milindmadhukar/keygen/README.md

# Keygen

**A wireless split ergonomic keyboard with a custom two-layer PCB designed in KiCad 10.**






Keygen, both halves in their black PETG case, the per-key LEDs lit under smoke translucent keycaps

Keygen is a one-off build: 66 keys over two column-staggered halves, a 2 × 2 thumb cluster, a rotary
encoder and a 0.96-inch OLED on each half, and per-key RGB lighting. Each half has its own
nRF52840 controller hidden on the PCB underside, and an optional printed wedge tents it 13°. The keyboard reaches the host over Bluetooth or
USB-C, and the halves talk to each other over Bluetooth.

The schematic, placement and most of the routing are generated by the Python scripts in
[`tools/`](tools/), and so are the switch plate and the 3D-printed case.
[`tools/regen.py`](tools/regen.py) keeps every generated file current with its sources. The name and the
silkscreen artwork come from Martin Garrix's track *Keygen* (STMPD RCRDS); see
[Silkscreen artwork](notes/16%20-%20hardware%20reference.md#silkscreen-artwork).
[`tools/check_mechanical.py`](tools/check_mechanical.py) checks the plate, case and component
clearances, including the battery stack at full gasket travel.

**To build one, follow [INSTRUCTIONS.md](INSTRUCTIONS.md).**

## Specifications

| | |
|---|---|
| Layout | Column-staggered QWERTY, six columns per hand plus an extra bottom row |
| Keys | 66 (33 per half): 52 × 1u, 14 × 1.25u |
| Thumb cluster | 2 × 2 block rotated 30° (two 1u over two 1.25u) plus one 1.25u key per hand |
| Encoders | HongYan EC11H with a 20 mm D shaft on each half, fixed to the top frame and plugged into a pin header on the PCB, with a 17 mm aluminium D-shaft knob, in the key matrix. Left: scroll wheel, press for middle click. Right: volume, press to mute |
| Displays | 0.96 in. 128 × 64 SSD1306 OLED per half (I2C), held in the top frame and plugged into the PCB, showing ZMK's status screen |
| Switches | Akko V3 Lavender Purple Pro (tactile, 5-pin) in Kailh hotswap sockets (CPG151101S11) |
| Keycaps | Blank DSA PBT, smoke translucent |
| Lighting | 33 SK6812MINI-E reverse-mount RGB backlights per half, on a 5 V rail from a TPS61023 boost that the firmware switches off with the lighting. An SN74LV1T125 buffer drives their data at 5 V. ZMK's addressable RGB driver; on battery the lighting is optional (a System-layer key), dimmer, and off on a low cell |
| Controller | nRF52840 SuperMini (nice!nano v2 clone, Pro Micro format), one per half, socketed on the underside |
| Connectivity | Host: USB-C (left half) or Bluetooth, 5 profiles. Halves: Bluetooth split |
| Power | KP-355085 LiPo pouch per half (3.5 × 50 × 85 mm, listed 3000 mAh) with a protection board, JST-PH connector, slide switch driving a P-MOSFET battery switch. Each half charges from its own USB-C at about 300 mA |
| PCB | 2 layers, FR-4 1.6 mm, 1 oz copper, HASL, black soldermask with white silkscreen. One half is 160.2 × 126.0 mm |
| Switch plate | Clear polycarbonate 1.5 mm, CNC-routed, with eight gasket tabs per half |
| Case | 3D-printed PETG, gasket-mounted: a bottom shell and a top frame per half, 175.4 × 143.7 × 24.5 mm. The top frame covers the plate round the keycaps and the knob, and holds the OLED and the encoder. Rubber feet, and a steel disc set flush into each floor |
| Tenting | Optional 3D-printed 13° PETG wedge per half, held by four N35 10 × 3 mm magnets to the steel disc, with the feet standing in recesses in its top face |
| Foam | Poron ring switch pads (0.5 mm) on the PCB, EVA plate foam (2 mm) taped under the plate, EVA case foam (5 mm) on the case floor |
| Firmware | [ZMK](https://zmk.dev) `main` (Zephyr 4.1): QWERTY base with Nav, Fn and System layers, ZMK Studio |

## Gallery

The lit pictures are Cycles renders of the [Blender scene](notes/17%20-%20building%20from%20source.md#blender-scene),
which is rebuilt from the board and the case on request; the case layers and the PCB come from KiCad.

<details>
<summary>More renders and animations</summary>

**Both OLEDs booting.** A closeup of both screens playing the firmware boot sequence.

Both Keygen OLEDs playing the boot animation in a Blender closeup

**Per-key lighting.** The SK6812MINI-E LEDs shine up through the switches' clear tops and the smoke
translucent caps. The [logic audit](docs/logic-audit.md) records the current and voltage limits that
still need a powered prototype test before brightness or battery life can be promised.

A rainbow wave running across Keygen's per-key LEDs

**All round.**

Keygen turning on a turntable

**From above.** The top frame's deck round the keycaps, the OLED window and the knob.

Keygen from above

**From the side.** The back edge of each half, with its USB-C port and power switch.

Keygen from behind at desk level, showing the case profile, the USB-C ports and the power switches

**Underneath.** The bottom shells, with the counterbored case screws and the reset pinhole.

Keygen turned over, showing the underside of both bottom shells

**Tenting.** Each half on its wedge, and the wedges' top faces: four recesses for the rubber feet, and
four pockets for the magnets under the steel disc.

Both halves on their 13° wedges, from behind at desk level

The two wedges, with their foot recesses and magnet pockets

**Knob and thumb cluster.**

Close up on the left half's knob, OLED window and thumb cluster

**Status screen.** ZMK's status screen on the left OLED: Bluetooth profile, battery and layer. The
Keygen screens, with their boot animation and lighting menu, are in
[`firmware/README.md`](firmware/README.md#oled-screens).

Close up on the left half's OLED showing ZMK's status screen, beside the knob

**Case layers.** Bottom shell, case foam, standoff screws, PCB, switch pads, shims and standoffs,
plate foam, gasket strips under and over the plate tabs, plate and top frame.

Keygen case, exploded

**Bare PCB.** Black soldermask with white silkscreen artwork on both sides; see
[Silkscreen artwork](notes/16%20-%20hardware%20reference.md#silkscreen-artwork).

The bare Keygen PCB at an angle, black soldermask and white silkscreen

The bare Keygen PCB from above

The bare Keygen PCB from below

**PCB underside, assembled.** The controllers, power switches, battery connectors and reset buttons
sit on the back.

Keygen PCB underside with its parts

Renders of the case parts, the plate and the routing are in the [`media` release](https://github.com/milindmadhukar/keygen/releases/tag/media).

</details>

## Documentation

| Document | What it covers |
|---|---|
| [Build guide](INSTRUCTIONS.md) | Parts list, what to order and when, what goes on which side, one section per part with close-ups, flashing, closing the case, troubleshooting |
| [Hardware reference](notes/16%20-%20hardware%20reference.md) | Electronics, PCB rules, plate, case, foam and the silkscreen artwork |
| [Building from source](notes/17%20-%20building%20from%20source.md) | Requirements, the schematic and PCB pipeline, the plate and case, the [Blender scene](notes/17%20-%20building%20from%20source.md#blender-scene), every generated file |
| [Firmware](firmware/README.md) | ZMK configuration: keymap, OLED screens, hardware support, building and flashing |
| [Design notes](notes/index.md) | The Obsidian design notes: layout, controller, PCB, case, final design, datasheet audit |
| [Encoder mount](docs/encoder-mount.md) | The encoder boss, knob clearance, the plate and PCB openings, the cable and a printable test coupon |
| [Build plan](plan/index.html) | Layout drawing, connectivity, parts, pin budget and checklist. Open it in a browser |
| [Printed reference (PDF)](https://github.com/milindmadhukar/keygen/releases/download/build/keygen-reference.pdf) | A4, black and white: each half's key layout with every layer's legends, the case footprint and the back of the board at 1:1, the power parts and each part type close up, the keymap, the key matrix with the controller's pads, and the parts lists |
| [Schematic (PDF)](https://github.com/milindmadhukar/keygen/releases/download/build/keygen-schematic.pdf) | A top sheet with left (refs 1xx) and right (refs 2xx) sub-sheets |
| [KiCad project](pcb/keygen.kicad_pro) | Schematic and PCB, KiCad 10. Both halves are in one board file as two separate outlines |
| [Build files](https://github.com/milindmadhukar/keygen/releases/tag/build) | The PCB and plate Gerbers, case and wedge STLs and STEPs, foam cut files and plate print PDFs, as a release |
| [Ordering notes](fab/ORDER.md) | PCB order-form settings and what to check in the DFM report |
| [Plate ordering notes](case/plate/PLATE.md) | The DXFs for routing the switch plates from polycarbonate sheet, and the Gerbers for an FR-4 plate from a PCB fab |
| [Assembly BOM](fab/BOM.md) | Every part's references per half, with quantities and soldering notes |
| [Parts and sources](plan/bom.html) | Shopping list with Indian and import sources (from [`bom/bom.csv`](bom/bom.csv)) |
| [Shopping checklist](bom/CHECKLIST.md) | What to buy, from which store, with links and prices, to tick off |
| [Datasheets](docs/datasheets/README.md) | Every part's datasheet, with the page each design fact comes from |

## Firmware

Keygen runs [ZMK](https://zmk.dev), one build per half on the nice!nano v2 target, with the left half as
the central. The configuration builds; it has not yet run on the boards. GitHub Actions builds the
UF2s on every push that changes `firmware/`. The keymap, the build and the flashing steps are in
[`firmware/README.md`](firmware/README.md).

Keygen base layer

## Repository layout

```
keygen/
├── INSTRUCTIONS.md Build guide
├── pcb/            KiCad 10 project: schematic (generated), PCB, plate, project footprints and 3D models
├── tools/          Python scripts that generate, route, check and export the design
├── fab/            Assembly BOMs and ordering notes (the Gerbers are in the build release)
├── case/           Plate ordering notes (the case, wedge, plate and foam files are in the build release)
├── bom/            Bill of materials with sources (bom.csv) and the shopping checklist
├── plan/           Build plan and parts list as HTML
├── docs/           Datasheet index (the PDFs are in the datasheets release)
├── assets/         Keymap pictures and assembly figures (the renders are in the media release)
├── blender/        Blender studio scene with the materials and the lit LEDs; it links the generated parts
├── notes/          Design notes, hardware reference and build pipeline (Obsidian Markdown)
├── firmware/       ZMK configuration: shield, keymap, builds
└── lib/            Git submodules: marbastlib and Keebio-Parts footprint libraries, KeyV2 keycaps
```

## Project status

- [x] Layout and schematic, ERC clean
- [x] PCB placed, routed, DRC clean with schematic parity
- [x] Datasheet audit with no failures
- [x] Manufacturing files and assembly BOM
- [x] Parts sourced and priced
- [ ] Boards ordered and assembled
- [x] ZMK firmware builds
- [ ] ZMK firmware tested on the boards
- [x] Switch plate, gasket-mounted case and tenting wedges designed, fit-checked against the PCB
- [ ] Case and wedges printed

## Credits and licenses

- Footprints from [marbastlib](https://github.com/ebastler/marbastlib) (CERN-OHL-P v2) and
  [Keebio-Parts](https://github.com/keebio/Keebio-Parts.pretty) (MIT), included as git submodules.
- DSA keycap models generated with [KeyV2](https://github.com/rsheldiii/KeyV2) (GPL-3.0), a git submodule.
- MX switch 3D model from [kiswitch](https://github.com/kiswitch/kiswitch) (MIT / CC-BY-SA 4.0); see
  [`pcb/lib/keygen.3dshapes/NOTICE.md`](pcb/lib/keygen.3dshapes/NOTICE.md).
- Datasheets in the [`datasheets` release](https://github.com/milindmadhukar/keygen/releases/tag/datasheets) belong to their manufacturers.
