milindmadhukar/keygen/notes/14 - case & plate requirements.md

---
created: 2026-10-20
name: 14 - case & plate requirements
tags:
  - keyboards
  - case
updated: 2026-10-24
---
# Case & Plate Requirements

> [!info] Running checklist
> Every PCB or electronics decision that the **case**, **switch plate** or **faceplate** must account for goes here as soon as it's made. Read this before designing either. Decisions themselves live in [[12 - final design]]; the case as designed is in [[09 - case design]].
>
> The positions table at the bottom is generated by `tools/case_refs.py` in the repo. Re-run it after any PCB change.

## Openings in the case

All the ports are on the **top edge** of each half, next to the controller, so one cut-out area per half covers them. The left and right halves mirror each other.

| Opening | Where | Size / notes |
|---|---|---|
| **USB-C** | Top wall, at the controller | The controller (18 mm wide) hangs **under** the PCB on sockets, and its USB-C end reaches ~1 mm past the PCB edge; the edge is slanted, so one corner reaches ~1.6 mm. The controller's end sits in a **20 mm pocket inside the wall**, open at the top of the bottom shell so the stack drops in straight, behind 1.5 mm of wall. Through that wall, a **14.2 × 9.8 mm port** with 2 mm corners is centred on the mid-mount receptacle (5.4 mm under the PCB top with 3.0 mm sockets): it takes a 12.35 × 6.5 mm plug overmould, the largest the USB-C spec recommends, moved by the floating stack 0.5 mm sideways, 1.5 mm down and 1.0 mm up, with 0.4 mm to spare, so a plugged cable never touches the case. 3.1 mm of wall stays below it. |
| **Power switch** (SK12D07VG5, right-angle) | Top wall, near the USB-C | The 2 × 2 mm knob comes out of the body 2.55 mm under the PCB's underside (centre) and reaches 4 mm past the PCB edge, through a **9 × 5.3 mm slot**, 1.5 mm proud of the wall (1.0–2.0 mm as the stack floats). The bottom shell's slot is open up to the split, so the stack drops in with the knob through the wall, and a tongue on the top frame fills it above the knob, 0.4 mm clear at full float. Outside, the wall is thinned from 10 mm before the USB-C to the corner past the switch: to **1.5 mm** past the inner wall round the knob, and to 1.5 mm in front of the controller's pocket across the USB-C. |
| **Reset pinhole** | Case **floor**, under the reset button | The 6 × 6 mm, 5 mm-tall button sits on the PCB underside. You press it with a **paperclip** through a **Ø 2 mm hole**, countersunk outside, with a guide tube (Ø 5 mm) up to 1 mm under the button. ZMK can also enter the bootloader from a key combo. |
| **Rotary encoder knob** (both halves, mirrored) | Top: through the switch plate | The encoder is fixed to the top frame and the plate and PCB float round it. The selected HongYan EC11H body is 12 × 11.7 mm and up to 6.8 mm tall. The plate has an **18 × 18 mm cut-out** and the PCB an **18 × 20 mm opening**; the top frame has a Ø15 mm boss, 2.5 mm thick, with a 7.3 mm hole for the 7 mm bushing, and two 1.2 × 9 mm cheeks that keep the body from turning. The washer and M7 nut clamp it from above. The encoder's 20 mm shaft is measured from its 6.5 mm body, so its tip is 26.5 mm above the PCB; it is cut 1.0 mm short so the knob (11 mm deep inside, its hub 2 mm up inside it) sits 5.5 mm above the deck, with its hub on the shaft's D flat and 2.4 mm clear of the nut while pushed. The knob is Ø 17 mm, its edge 10 mm below the OLED, 5.7 mm from the thumb cluster's top key and 9.1 mm from the G/H column. Shafts at (167.0, 134.5) left and (256.5, 134.5) right, in board coordinates (KiCad mm). |
| **OLED window** (both halves) | Top: through the switch plate, above the knob | The 27.5 × 27.8 mm SSD1306 module (GME12864-11 drawing) is held in the top frame on **four Ø 1.7 mm pegs** through its corner holes, melted or glued over on its back, and plugs into a right-angle header in J101/J201 on a 4-wire jumper lead. Its glass sits in a pocket under a **1.0 mm lip**, 1.0 mm below the deck top, and its board 5.2–6.4 mm above the PCB on a boss that thickens the deck down to it, with 1.5 mm reliefs over its four joints and over the flex cable at its far edge. The lip's window is 1 mm round the active area at its underside, chamfered at 45° and opening towards the thumbs. The header and plug lie flat under the module, 2.8 mm tall. The plate has a **29.5 × 29.8 mm window** round the module, 1 mm per side, so the floating plate clears it by 0.5 mm. Module at x 154–181.5, y 88–116 (left) and x 242–269.5, y 88–116 (right), in board coordinates, over the controller's antenna end and 4.6 mm from the nearest keycaps. `tools/gen_case.py` checks the case against the modules. |

## Inside the case (under the PCB)

- **Tallest part: the controller on sockets.** The case reserves **9.4 mm below the PCB** for the socketed controller (the sockets, the male pins' carrier and the board, plus 2.9 mm for its parts, pin tails and spare), plus 1.5 mm of float travel to the floor. The PCB's 3D model uses 3.0 mm sockets (`SOCKET_H` in `tools/gen_schematic.py`) under the 1.6 mm SuperMini with its mid-mount USB-C, and the USB-C port is placed from them: set `SOCKET_H` to the measured socket body before printing the case; the controller envelope and the case depth follow it.
- **Battery**: a **KP-355085 LiPo pouch, 85 × 50 × 3.5 mm, listed 3000 mAh**, with a protection board. The bay takes a cell **≤ 5 mm thick and at most 60 × 88 mm** including the protection board. It lies in a **bay sunk 1.6 mm into the case floor**, long side across the board, under the outer and middle key columns, held with double-sided tape. Measure the actual cell before printing.
  - Bay: the cell plus 1.5 mm each side, 63 × 91 mm. Cell position (same coordinates as the table below): left half x 16.7–104.7, y 6.4–66.4; right half x 57.9–145.9, y 6.4–66.4. `tools/case_geometry.py` places it, as near the battery connector as the rules below allow.
  - Keep it **≥ 15 mm from the controller's antenna end** (no foil near the antenna) and ≥ 3 mm from the controller, the JST-PH connector, the slide switch, the reset button, the encoder and the OLED header pins. It has 10 mm.
  - The lead end faces the side-entry JST-PH next to the controller, about 40 mm away, so a lead of 80 mm or more reaches it.
  - Height: bay floor 12.5 mm below the PCB's underside. A 6.1 mm installed envelope (5.0 mm nominal cell + 0.3 mm thickness tolerance + 0.5 mm swelling + 0.3 mm tape) leaves 4.4 mm to the sockets and diodes (assumed 2.0 mm under the PCB), and 2.9 mm with the floating stack pressed 1.5 mm down. `tools/gen_case.py` checks the modeled envelope. Solder higher than 2.0 mm uses that gap.
- **Case height:** 3.0 mm floor + 1.5 mm float gap + 9.4 mm controller envelope + 1.6 mm PCB puts the PCB top 15.5 mm above the desk, the plate top 20.5 mm and keycap tops about 35 mm, before tenting and feet. The full stack is in [[09 - case design#The stack]].
- **Plate standoff screws** under the PCB (M2 button heads, 1.1 mm) are lower than the hotswap sockets.
- **Other underside parts.** Kailh hotswap sockets (~1.8 mm), through-hole diodes (~2 mm body, leads clipped flush), reverse-mount LEDs (nearly flush) and the switch pins poking through. Allow **≥ 4 mm** clear under the key area.
- **Bluetooth antenna.** The nRF52840's chip antenna is at the controller's **bottom end** (opposite USB-C). The case must be **plastic**, with **no metal plate, weight or screws** under or right next to that end. The PCB already keeps ground fill out of that area.

## Switch plate (faceplate)

- **Clear polycarbonate, 1.5 mm**, the thickness the MX clips are made for, CNC-routed from solid sheet with `case/plate/dxf/` (notes in `case/plate/PLATE.md`): each half needs a 178 × 139 mm piece, so a 6 × 24 in. (152 × 610 mm) strip holds three. Routed, not laser-cut: a laser browns and chars polycarbonate edges. `case/plate/gerber/` has the same plate as a 1.6 mm board with no copper for a PCB fab; the case takes either.
- **14.0 × 14.0 mm** square cut-out per switch, with 0.5 mm corner radii (in the DXFs, a dogbone at each corner for a 1/8 in. bit).
  - Thumb keys follow the PCB rotation (±15° / ±30°).
  - The two tall 1.25u thumb switches per half are turned 90°, but the cut-out is square so that doesn't matter.
- **No stabilizer cut-outs.** Nothing is wider than 1.25u.
- **Plate-to-PCB gap.** The plate top sits 5.0 mm above the PCB top (MX standard), so the gap is 3.5 mm. At all five holes per half an **M2 × 3 mm female-female standoff** stands on a **0.5 mm DIN 988 shim** (2 × 5 mm) on the PCB, screwed on from below with an M2 × 5 button head: 2.9 mm into the 3 mm standoff, its tip within ±0.25 mm of the standoff top and free in the plate's 2.2 mm hole if it pokes past.
- **Plate fixing.** Every standoff's top bears on the plate; the switches, clipped into the plate and plugged into the hotswap sockets, hold the plate to the PCB, and the case clamps the plate's tabs between the gasket strips.
- **Mounting holes** line up with the PCB's M2 holes (table below), 2.2 mm.
- **Gasket tabs:** 8 per half, 12 × 5 mm, on the plate edge, kept 22 mm from the USB-C and the power switch. The right half's are the left's, mirrored.
- **Encoder cut-out** (18 × 18 mm) and **OLED window** (29.5 × 29.8 mm) on both halves (see above).

## Lighting

- **Per-key LEDs** sit **south** of each switch (under the MX LED window), so shine-through legends would need south-facing keycaps.
- **Opaque floor.** All the lighting is per-key and shows through the keycaps, so the case floor needs no diffuser.

## Ergonomics and feel

- **Tenting.** An optional printed 13° wedge per half, its four magnets on a 40 mm steel disc set flush into a 1.0 mm pocket in the inner half of the floor, at least 15 mm from the controller's antenna end and clear of the battery bay.
- **Rubber feet** and **foam** (EVA case foam, Poron switch pads) for a thocky sound. See [[07 - switch & keycap selection]].
- **Keycaps.** Blank DSA PBT, smoke translucent: 52 × 1u, 14 × 1.25u. Switches: Akko V3 Lavender Purple Pro.

## Positions (from the PCB)

Measured from the top-left corner of each half's bounding box, looking at the switch side. The y axis points down, toward the thumbs.

<!-- case-refs:start -->
**Left half**: board outline 160.2 × 126.0 mm (bounding box)

| Ref | What | x | y |
|---|---|---|---|
| BT101 | Battery JST-PH connector (underside) | 143.6 | 28.2 |
| ENC101 | Rotary encoder shaft (top) | 136.7 | 58.9 |
| H101 | M2 mounting hole | 84.0 | 60.0 |
| H102 | M2 mounting hole | 4.5 | 85.5 |
| H103 | M2 mounting hole | 152.7 | 51.4 |
| H104 | M2 mounting hole | 136.1 | 121.3 |
| H105 | M2 mounting hole | 23.5 | 8.5 |
| J101 | OLED wiring pin 1 (top); the module is above it, in the top frame | 141.2 | 39.1 |
| J102 | Encoder lead header pin 1 (underside) | 155.9 | 79.4 |
| SW190 | Power slide switch (underside), knob through the top wall | 149.6 | 7.0 |
| SW191 | Reset button (underside) -> floor pinhole | 152.6 | 41.2 |
| U101 | Controller (underside), USB-C at the top edge | 129.1 | 20.8 |

**Right half**: board outline 160.2 × 126.0 mm (bounding box)

| Ref | What | x | y |
|---|---|---|---|
| BT201 | Battery JST-PH connector (underside) | 16.7 | 28.2 |
| ENC201 | Rotary encoder shaft (top) | 23.6 | 58.9 |
| H201 | M2 mounting hole | 82.1 | 57.5 |
| H202 | M2 mounting hole | 7.5 | 51.4 |
| H203 | M2 mounting hole | 34.4 | 115.4 |
| H204 | M2 mounting hole | 155.6 | 85.5 |
| H205 | M2 mounting hole | 138.1 | 9.0 |
| J201 | OLED wiring pin 1 (top); the module is above it, in the top frame | 26.6 | 39.1 |
| J202 | Encoder lead header pin 1 (underside) | 14.5 | 79.4 |
| SW290 | Power slide switch (underside), knob through the top wall | 10.7 | 7.0 |
| SW291 | Reset button (underside) -> floor pinhole | 14.2 | 41.2 |
| U201 | Controller (underside), USB-C at the top edge | 31.2 | 20.8 |

<!-- case-refs:end -->
