milindmadhukar/keygen/notes/15 - datasheet audit.md

---
created: 2026-10-20
name: 15 - datasheet audit
tags:
  - keyboards
  - pcb
updated: 2026-10-22T15:00
---
# Datasheet Audit

> [!note] Result (2026-10-28): connectivity passes, lighting limits remain
> `tools/check_datasheets.py` checks the routed PCB against component pinouts and electrical limits: **109 pass, 0 fail, 15 warnings**. It now verifies all 66 switch/LED openings and warns about the 40% full-white current and missing per-pixel bypass capacitors. This is not a brightness or battery-life sign-off. The full operating review is in [`docs/logic-audit.md`](../docs/logic-audit.md). Re-run the script after any PCB change, with `-v` to list passes. Datasheets and source pages are in `docs/datasheets/`.

## How the checking fits together

There are three checks, each covering a different gap:

1. `tools/check_schematic.py`: the schematic matches the design tables in `gen_schematic.py` (plus KiCad's electrical rules check).
2. `kicad-cli pcb drc --schematic-parity`: the PCB matches the schematic.
3. `tools/check_datasheets.py`: the design tables are **right for the parts**. Nothing else checked this.

The audit reads the `.kicad_pcb` file, the thing that gets fabricated. It checks **physical pad positions**, not just pin numbers, because footprint numbering can disagree with the datasheet.

To prove the test catches real mistakes, I fed it deliberately broken copies of the board, and it flagged every one. They included a mirrored controller pinout, a mirrored LED footprint, a reversed diode, LED data on a low-frequency pin, and the battery bypassing the switch.

## Learnings

### nRF52840 pins
- **No bootstrapping pins.** Unlike the ESP32, every nRF52840 GPIO resets to a disconnected input, and nothing on the GPIOs decides how the chip boots. P0.18 is reset; P0.00/P0.01 are the 32 kHz crystal; SWD has dedicated pins.
- **Bootloader:** the nice!nano's Adafruit bootloader 0.6.0 defines DFU = P0.18 (reset) and FRESET = P0.19 (not connected), and current master says "no buttons". **No edge pad is read at power-up**, so a held key can't push the board into DFU. Double-tapping RST within 500 ms enters the bootloader.
- **"Low frequency" pins (≤ 10 kHz)** come from the *Recommended usage* column of Table 142 in the nRF52840 spec (aQFN73 ball assignments, p. 578). The nRF52840 has no "GPIO near the radio" section; that is the nRF52832's document. The restricted pins on the edge pads are P0.02, P0.09, P0.10, P0.29, P0.31, P1.04, P1.06, P1.11, P1.13 and P1.15, plus the inner pads P1.01, P1.02 and P1.07. The nice!nano pinout image colours exactly these purple. Running faster signals on them can upset the radio.
  - LED data (SPI at 4 MHz) is on **P0.06**, unrestricted. **P0.08** drives the LED boost's enable (a slow output). The OLED's I2C is on **P0.17** (SDA) and **P0.20** (SCL), both full-speed pins.
  - The encoder's A and B lines (P0.10, P0.09) are slow inputs, so the low-frequency NFC pins suit them.
  - The matrix columns and ROW4 *are* on low-frequency pins. That's fine: ZMK scans about once per millisecond (~1 kHz).
- **NFC pins P0.09/P0.10** stay NFC antenna pads until UICR.NFCPINS is cleared. With ZMK's Zephyr 4.1, the old `CONFIG_NFCT_PINS_AS_GPIOS` is gone; use devicetree `&uicr { nfct-pins-as-gpios; };`. Once written, the setting sticks until UICR is erased. When driven to different levels, the two pins leak 1–10 µA between each other.
- **Absolute maximum on any I/O is VDD + 0.3 V.** Every signal on a pin comes from inside the half, at 3.3 V.

### nice!nano v2 pinout (the SuperMini)
- The nRF52840 SuperMini is a nice!nano v2 clone with the same 24-pin header, so the footprint follows the nice!nano v2. Pinout verified pad by pad against the official image. **Mounted on the underside, the component side (chip, USB-C) must face away from the PCB.** That's what the footprint assumes. Soldered the other way, the columns swap and battery + lands on a GPIO.
- P0.13 *low* cuts VCC on the v2. The "high" wording in the docs is for v1. VCC (pad 16) powers the OLED, so the firmware holds P0.13 high with a gpio-hog. Battery voltage is read internally (VDDH), so it uses no pin.
- The SuperMini charges through a TP4054 at about 100 mA as shipped; its BOOST link on the back, an unfitted 0 Ω link, raises that to about **300 mA**, and Keygen bridges it: about ten hours for an empty 3000 mAh cell. On USB a diode feeds the controller (VDDH) from USB and a P-MOSFET takes the battery off it, so ZMK reads the battery as full while plugged in ([vendor schematic](https://img.alicdn.com/imgextra/i1/3009214883/O1CN01dX5XEt1lwSylaBst7_!!3009214883.jpg)). It has no over-discharge cut-off, so the cell carries its own protection board. Check B+ (pad 13), GND and VCC (pad 16) on each board before soldering it, and the charge current after bridging BOOST. With no battery fitted, B+ is only the charger's output, so the LED boost has no proper supply.
- No VCC current limit is published, and no antenna position or keep-out. The renders show bare board at the end away from USB-C, so the audit keeps the last 6 mm clear.

### Parts
- **SK6812MINI-E:** the datasheet numbers the pins 1 VDD, 2 DOUT, 3 GND, 4 DIN. KiCad's symbol uses 1 VSS, 2 DIN, 3 VDD, 4 DOUT. They still line up physically: the reverse-mount footprint is the datasheet's lens-side view mirrored, which is correct because the lens faces the board. The chamfered corner is GND. When ordering assembly, check the fab's placement preview against that.
  - VDD is rated 3.7–5.5 V. The LEDs get 4.95 V from the TPS61023 boost over the cell's whole 3.0–4.2 V. VIH = 0.7 × VDD = 3.47 V, so the data comes from an SN74LV1T125 on the same rail, which drives the chain at the rail.
  - 12 mA per colour, so 33 LEDs at full white ≈ 1.2 A per half. Each LED also draws 1 mA even when dark (≈ 33 mA per half), so the boost turns off with the lighting.
  - The manufacturer's example has a capacitor at every pixel and a resistor on DIN: each LED has an optional 100 nF footprint beside it (left empty), and a 330 Ω resistor feeds the first LED.
- **TPS61023:** SOT-563, pins 1 FB, 2 EN, 3 VIN, 4 GND, 5 SW, 6 VOUT. VREF 595 mV (580–610), so 732 kΩ / 100 kΩ gives 4.95 V. EN high above 1.2 V, so P0.08's 3.3 V enables it; 0.1 µA shutdown with the output disconnected. Valley switch limit 2.7–3.7 A at 3.6 V in. Inductor 0.37–2.9 µH (1 µH used, 4.6 A saturation); effective output capacitance at least 4 µF (2 × 22 µF used). Layout follows the example on p. 18. The pins are 0.15 mm apart, below the board's 0.2 mm rule, so a DRC rule allows 0.15 mm there (JLCPCB's minimum is 0.127 mm).
- **SN74LV1T125:** SOT-23-5, pins 1 OE̅ (tied to GND), 2 A, 3 GND, 4 Y, 5 VCC. VIH 2.02–2.03 V at VCC 4.5–5 V, against the nRF52840's VOH ≥ 2.9 V. Its inputs take 5.0 V with VCC at 0 V, so the controller can't back-power the LED rail when the boost is off.
- **SK12D07VG5 power switch:** three pins in a row at 2 mm pitch, the middle one (2) common, and mounting tabs 8.3 mm apart, all under the middle of the 8.7 × 4.4 × 4.7 mm body (p. 4). It makes before it breaks ("SHORTING"), so pin 3 is unconnected. The 2 × 2 mm knob stands 4 mm out of the body, centred 2.55 mm off the board, and slides 2 mm. Rated **300 mA at 50 V DC**, 130–330 gf, 5,000 cycles (pp. 2–3). It only drives the gate of an AO3401A P-MOSFET, which carries the battery current, including the charge current.
- **EC11:** A C B in a row with C (common) in the middle, and the push switch on the other side. Swapping A and B only reverses the rotation direction, which firmware can fix.
- **AO3401A:** SOT-23 pins 1 G, 2 S, 3 D, matching KiCad's symbol. RDS(on) < 85 mΩ at VGS = −2.5 V, so the battery's −3.0 to −4.2 V gate drive turns it fully on (about 43 mV drop at 500 mA). Its body diode runs drain to source: with the source on the battery and the drain on B+, it blocks the battery when the switch is off. With the switch off and USB in, charge current can cross that diode, dissipating about 0.2 W at 300 mA. Full-charge termination is not assured with the diode in that path; leave the switch on when charging.
- **JST PH:** JST defines no battery polarity, and LiPo packs come wired both ways round.

## Open warnings

> [!success] Fixed 2026-10-20
> - **Antenna keep-out.** `load_without_zones()` now keeps rule areas and `ground_pours()` adds back any missing antenna keep-out, so re-pours can't put ground under the antenna. Both keep-outs are on the board. About 20 signal tracks per half still cross the antenna end; that matters much less than solid ground.
> - **Battery polarity.** A "+" is printed beside pad 1 of BT101/BT201. Still check each battery's red wire before plugging it in: a reversed pack destroys the charger.

> [!note] Firmware (ZMK)
> - Both halves: `&uicr { nfct-pins-as-gpios; };`, or the encoder lines (A on P0.10, B on P0.09) read dead.
> - Hold P0.13 high (gpio-hog) so the OLED keeps its 3.3 V supply.
> - Cap LED brightness and check the actual P0.08/LED_VDD state on battery. The pinned ZMK ext-power driver enables the boost at startup; the Keygen module turns it off whenever the lighting is off, but a dark strip is not proof that its supply is cut.
> - Matrix: `diode-direction = "col2row"` (cathodes are on the rows).

> [!note] Accepted, but outside datasheet limits
> - Switch off with USB plugged in: charge current can cross the AO3401A's body diode, about 0.2 W at 300 mA on the SOT-23. Full-charge termination is not assured. Leave the switch on while charging.

## Datasheets

All in `docs/datasheets/` in the repo. Its `README.md` lists each source and the page every fact comes from, and has an English translation of the SK12D07VG5 drawing's Chinese notes. The nRF52840 spec is v1.1 (Nordic blocks scripted downloads); its pin table matches the current online spec.
