milindmadhukar/keygen/notes/03 - microcontroller selection.md

---
created: 2026-03-09
updated: 2026-10-22T15:00
name: 03 - microcontroller selection
---

> [!success] Controller
> **nRF52840 SuperMini**, a nice!nano v2-compatible board, one per half, socketed on the PCB **underside** and hidden, with USB-C out through the top edge of the case. It runs ZMK. See [[12 - final design#Controllers]].

## nRF52840 SuperMini

- **Compatibility:** a nice!nano v2 clone with the same 24-pin Pro Micro header and pinout. The board uses no other pads.
- **MCU:** nRF52840 (ARM Cortex-M4F, 64 MHz), 1 MB flash, 256 KB RAM
- **Radio:** Bluetooth Low Energy, used for the host link and the link between the halves
- **USB:** USB-C on the module, which is the keyboard's USB port
- **Format:** Pro Micro footprint (marbastlib's `nice_nano_H_USBup`), with USB facing the top edge
- **Firmware:** ZMK builds it as the nice!nano v2 (target `nice_nano//zmk`); flashing is drag-and-drop UF2 after a double-tap of reset
- **Charger:** an on-board TP4054 LiPo charger, at about 300 mA with the BOOST link on the back (an unfitted 0 Ω link) bridged, as Keygen has it: about ten hours for an empty cell. It has no over-discharge cut-off, so the battery carries its own protection board.
- **Power path:** on USB, the controller runs from USB through a diode, and a P-MOSFET takes the battery out of its supply. The LED boost runs from the cell rail (B+), so bright white lighting can draw more than the charger supplies. With no battery fitted, the keys, OLED and Bluetooth run from USB and the lighting has no supply. The battery level reads full while plugged in, since ZMK measures the controller supply (VDDH).
- **Check on arrival:** before soldering, check B+ (pad 13), GND and VCC (pad 16) with a multimeter. After bridging the BOOST link, confirm the charge current.
- **Switched VCC:** an on-board MOSFET on P0.13 cuts the 3.3 V VCC rail. Keygen's VCC (pad 16) powers only the OLED, and the firmware holds P0.13 high with a gpio-hog so it stays on. The LEDs run from a 5 V boost on the battery, enabled from P0.08.
- **Mounting:** socketed with low-profile machined round-pin headers, so a controller can be swapped. It sits about 7.5 mm below the PCB, which sets the case depth.

## Pin budget

21 usable GPIO; 18 on the Pro Micro edge pads.

| Function | Left | Right |
|---|---|---|
| Matrix (5 rows × 7 cols) | 12 | 12 |
| Encoder A/B | 2 | 2 |
| RGB data | 1 | 1 |
| LED boost enable | 1 | 1 |
| OLED SDA/SCL | 2 | 2 |
| **Total** | **18** | **18** |

Every one of the 18 edge pins is used on both halves; the three inner pads stay unused.

- LED data is on **P0.06**, a full-speed pin.
- The OLED's I2C is on **P0.17** (SDA, pad 5) and **P0.20** (SCL, pad 6), both full-speed pins.
- The encoder is on the NFC pins, the same on both halves: A on **P0.10** (pad 23), B on **P0.09** (pad 24), set up as GPIO with `nfct-pins-as-gpios`.
- **P0.08** enables the LED boost.
- The pin restrictions were checked against the nRF52840 datasheet in [[15 - datasheet audit]]. Full pin map: [[12 - final design#Controller pin map]].

## Related notes
- [[04 - firmware options]] — ZMK
- [[05 - pcb design]] — schematic and routing
- [[06 - split architecture]] — how the halves connect
- [[08 - electronics & components]] — supporting parts

## Resources
- [nice!nano documentation](https://nicekeyboards.com/docs/nice-nano/) (the pinout the SuperMini shares)
- [ZMK supported hardware](https://zmk.dev/docs/hardware)

### Video notes
- [[How To Build A Corne Keyboard - Beginners Guide]] — socketing the controller with Mill-Max pins
