milindmadhukar/keygen/notes/07 - switch & keycap selection.md

---
created: 2026-03-09
updated: 2026-10-22T15:00
name: 07 - switch & keycap selection
---

> [!success] Decision (2026-10-20)
> - **Switch: Akko V3 Lavender Purple Pro** (tactile, 5-pin), in **Kailh MX hotswap** sockets. 2 × 45 from [StacksKB](https://stackskb.com/store/akko-v3-lavender-purple-pro-switch-pack-of-45/) at ₹1,099 a pack: 66 used, 24 spare.
> - **Keycaps: blank DSA PBT, smoke translucent.** 52 × 1u and 14 × 1.25u, all from one AliExpress seller.
> - See [[12 - final design#Keycaps]] and [[13 - bill of materials]].

## Switches

### Akko V3 Lavender Purple Pro

| | |
|---|---|
| Type | Tactile, light, 5-pin MX |
| Force | 40 gf operating, 55 gf rounded bump |
| Travel | 3.8 mm |
| Housing | Clear PC top, nylon bottom, POM stem |
| Sound | Creamy and quiet |
| Quantity | 66 used, 24 spare (two packs of 45) |

**Why:** feedback on every press without a heavy bump, which suits small hands. The clear top lets the per-key LEDs through. The hotswap sockets let any switch be pulled and replaced without soldering, and the 24 spares cover that.

### Requirements it meets
- MX, in Kailh MX hotswap sockets
- Creamy rather than loud
- Light tactile

## Keycaps

### Blank DSA PBT, smoke translucent

- **Blank:** only the letters are fixed (QWERTY), so every other key can move between layers and positions freely.
- **Translucent:** the per-key RGB also shows status, and translucent caps show each key's colour across the whole cap.
- **DSA:** a uniform profile, so any cap works in any position, including the rotated thumb keys.
- **PBT:** textured, resists shine.

| Size | Qty | Source |
|---|---|---|
| 1u | 52 | [SZElectronic Store](https://www.aliexpress.com/item/1005008827240220.html), a 50-pack in LBlack, and a [10-pack in LBlack](https://www.aliexpress.com/item/1005010720096151.html) from the same store (8 spares) |
| 1.25u | 14 (8 outer column, 2 thumb, 4 tall thumb) | [SZElectronic Store](https://www.aliexpress.com/item/1005008827506189.html), 20-pack in LBlack |

All from SZElectronic Store on AliExpress, ordered with the LEDs, so the smoke shade matches across sizes.

Every key is 1.25u or smaller and sits on its switch alone.

## Sound

The thocky, creamy sound comes from the switch and the build together:

- **Switch:** nylon bottom housing and a POM stem.
- **Keycaps:** thick PBT.
- **Foam:** a 0.5 mm Poron ring switch pad on the PCB under each switch, 2 mm EVA plate foam between the pads and the plate, and 5 mm EVA in the case floor. The plate floats on Poron gaskets. See [[09 - case design#Sound]].

## Related Notes
- [[02 - layout design]] for key sizes and positions
- [[05 - pcb design]] for the hotswap sockets and LED windows
- [[09 - case design]] for the foam
- [[10 - assembly & build guide]] for switch installation
- [[13 - bill of materials]] for prices and sources

## Resources
- [Switch Search Database](https://switches.mx/)
- [GOLEM Keycap Profiles](https://golem.hu/guide/keycap-profiles/)
- [GOLEM Keyboard Sound Database](https://golem.hu/sound/)
