milindmadhukar/keygen/case/plate/PLATE.md

# Making the Keygen switch plates

The plate is clear polycarbonate, 1.5 mm (the MX clips are made for it), CNC-routed from
solid sheet.

## Routing the plates from polycarbonate sheet

[`keygen-plate-left.dxf`](https://github.com/milindmadhukar/keygen/releases/download/build/keygen-plate-left.dxf) and [`keygen-plate-right.dxf`](https://github.com/milindmadhukar/keygen/releases/download/build/keygen-plate-right.dxf) are the plates as 1:1 DXFs in mm,
seen from above, one closed outline per contour, on three layers:

| Layer | Cut |
|---|---|
| `CUTOUTS` | inside the line (pockets through): switch, encoder and OLED cut-outs |
| `OUTLINE` | outside the line: the plate edge with its gasket tabs |
| `DRILL` | 2.2 mm holes, drilled (smaller than a router bit) |

- Sheet: solid clear polycarbonate, 1.5 mm, at least 178 × 139 mm per half. A
  6 × 24 in. (152 × 610 mm) strip holds three halves, the 139 mm side across the strip.
- Route it, don't laser it: a laser browns and chars polycarbonate edges. A sharp single-flute
  (O-flute) bit for plastics, at a feed fast enough that the chips come off cold and the cut doesn't melt
  shut; hold the sheet down with tape or vacuum so the thin strips between cut-outs don't chatter.
- Each cut-out corner has a dogbone (a half circle through the corner) for a router bit of
  3.175 mm (1/8 in.) or smaller, so the switches sit square.
- 66 square switch cut-outs (33 per half), 14.0 × 14.0 mm, plus a 18 × 18 mm encoder cut-out
  and a 29.5 × 29.8 mm OLED window per half. Five 2.2 mm holes per half (M2).
- Leave the protective film on while cutting; peel it after deburring the edges.

## The same plate in FR-4 from a PCB fab

The Gerbers make the plate as a plain 1.6 mm FR-4 board with no copper; the case takes it too.
Place **two orders**, like the PCB:
[`keygen-plate-left-gerbers.zip`](https://github.com/milindmadhukar/keygen/releases/download/build/keygen-plate-left-gerbers.zip) and
[`keygen-plate-right-gerbers.zip`](https://github.com/milindmadhukar/keygen/releases/download/build/keygen-plate-right-gerbers.zip) from the build release, 5 of each.

| Setting | Value |
|---|---|
| Layers | 2 (both copper layers are empty) |
| Material | FR-4, 1.6 mm |
| Board size | one half: 169.8 × 130.6 mm |
| Quantity | 5 left + 5 right (two orders) |
| Surface finish | HASL lead-free (no copper is exposed) |
| Soldermask / silkscreen | **black** both sides / none |
| Assembly | none |

**Things to tell the fab or check in their DFM report**
- It is a keyboard switch plate: **no copper** on either layer. Empty copper Gerbers are on purpose.
- The switch, encoder and OLED cut-outs are internal Edge.Cuts outlines with 0.5 mm corner radii, to be
  routed (milled) with a bit of 1.0 mm or less, so the corners stay at 0.5 mm.
- The outline has rectangular tabs (12 × 5 mm) on its edges. They are part of the board.
- Five 2.2 mm non-plated holes per half (M2).

Files in each zip: keygen-plate-right-B_Cu.gbl, keygen-plate-right-B_Mask.gbs, keygen-plate-right-B_Silkscreen.gbo, keygen-plate-right-Edge_Cuts.gm1, keygen-plate-right-F_Cu.gtl, keygen-plate-right-F_Mask.gts, keygen-plate-right-F_Silkscreen.gto, keygen-plate-right-NPTH-drl_map.gbr, keygen-plate-right-NPTH.drl, keygen-plate-right-PTH-drl_map.gbr, keygen-plate-right-PTH.drl, keygen-plate-right-job.gbrjob

Generated by `tools/gen_plate.py` from `pcb/keygen.kicad_pcb`.
