milindmadhukar/keygen/bom/CHECKLIST.md

# Keygen shopping checklist

What to buy for one keyboard with spares, where from, and what it costs. Prices are what the
listings and carts showed on 2026-10-30, GST included. Specs are in the [bill of materials](../plan/bom.html).
Mark the first column `[x]` as things arrive. Anything shipped to Australia is bought on AliExpress
only, and a friend brings it to India.
The AliExpress order has now been placed, but this file records the earlier cart rather than the
final invoice. Its lines still say “in cart”; verify the delivered contents against the order before
marking them received. The Amazon.in cart was ordered on 2026-11-08.

Order in two stages. First the PCBs, the electronics and the AliExpress cart; build one half on the
bench and test it. Then the parts made to fit: the plate and its foam once an OLED module measures
27.5 × 28 mm or less, and the case and its foam once the controller sockets and an OLED module are measured
([INSTRUCTIONS.md](../INSTRUCTIONS.md#the-plan)). Estimated total
about ₹23,000 (at ₹67 per AU$ and ₹95 per US$ on 2026-10-30, with customs on the PCBs and the optional wedges, Y cable and wrist rests), plus the CNC cutting of the plate.

| Got | Item | Qty | Where | Link | Price | Notes |
|---|---|---|---|---|---|---|
| [ ] | Main PCBs, black | 5 left + 5 right | JLCPCB (in cart, JLCONE) | [quote](https://cart.jlcpcb.com/quote) | US$15.40 per design, US$40.63 with UPS to India | Settings in [`fab/ORDER.md`](../fab/ORDER.md). Stage 1. Both are in the cart with the current copper. Indian customs is paid on delivery (18 % IGST or more, and a UPS clearance fee). Lion Circuits is the fallback at ₹3,400 per design |
| [ ] | Switch plate sheet, clear polycarbonate, 1.5 mm solid, 6 × 24 in. (152 × 610 mm), pack of 2 | 1 | Amazon.in (ordered 2026-11-08) | [V-LITE 1.5 mm sheet](https://www.amazon.in/dp/B0GXG2SW48), size 6x24IN | ₹704 | Three halves per strip. Then a CNC router job (not a laser) with [`case/plate/dxf/`](../case/plate/dxf/), 1/8 in. bit or smaller, as [`PLATE.md`](../case/plate/PLATE.md) describes: a local router shop, as no Indian service quotes polycarbonate online. Stage 2. In FR-4 instead, the plate Gerbers are US$16.30 per design at JLCPCB |
| [ ] | Switches, Akko V3 Lavender Purple Pro | 90 (2 × 45) | StacksKB | [pack of 45](https://stackskb.com/store/akko-v3-lavender-purple-pro-switch-pack-of-45/) | ₹2,198 | 24 spare |
| [ ] | Diodes 1N4148W, SOD-123 (Diodes Inc 1N4148W-7-F) | 80 | Robu.in (in cart) | [R242981](https://robu.in/product/1n4148w-7-f-diodes-incorporated-100v-independent-type-1-25v150ma-4ns-300ma-sod-123-switching-diodes-rohs/) | ₹240 (₹3 each at 10+) | 68 needed + 12 spare |
| [ ] | Keycaps 1u, blank DSA PBT, LBlack (smoke translucent), pack of 50 | 50 | AliExpress → Australia (in cart) | [SZElectronic Store](https://www.aliexpress.com/item/1005008827240220.html) | AU$10.89 | Option "50pcs LBlack" |
| [ ] | Keycaps 1u, blank DSA PBT, LBlack (smoke translucent), pack of 10 | 10 | AliExpress → Australia (in cart) | [SZElectronic Store](https://www.aliexpress.com/item/1005010720096151.html) | AU$3.89 | Options "LBlack" and "10pcs": the last 2 of the 52 × 1u, plus 8 spares. Same store, so the shade matches |
| [ ] | Keycaps 1.25u, blank DSA PBT, LBlack (smoke translucent), pack of 20 | 20 | AliExpress → Australia (in cart) | [SZElectronic Store](https://www.aliexpress.com/item/1005008827506189.html) | AU$8.05 | Option "20pcs LBlack": 14 needed (4 of them the tall thumb keys), 6 spare |
| [ ] | Per-key LEDs SK6812MINI-E | 100 | AliExpress → Australia (in cart) | [Venuss 777 Store](https://www.aliexpress.com/item/1005007863635868.html) | AU$5.69 | 34 spare. Not stocked in India. Almost sold out |
| [ ] | Controller, nRF52840 SuperMini (nice!nano v2 clone), pack of 5 | 5 (2 + 3 spare) | AliExpress → Australia (in cart) | [A+A+A Store](https://www.aliexpress.com/item/1005007383270623.html) | AU$23.99 | Same 24-pin header as the nice!nano; the board uses no other pads. Before soldering, check B+ (pad 13), GND and VCC (pad 16) with a multimeter, then bridge its BOOST link and check the charge current (about 300 mA). Almost sold out |
| [ ] | Controller sockets, round-hole female header 1×40 | 10 | AliExpress → Australia (in cart) | [MT Technology](https://www.aliexpress.com/item/32717301965.html) | AU$5.09 | Round holes take only round pins, not square headers. Measure the height on arrival: with the male pins' carrier it sets how deep the controller sits. Not stocked at Robu |
| [ ] | Controller pins, machined male header 1×40 | 2 | Robu.in (in cart) | [machined pin header](https://robu.in/product/361019140sg107601-jiln-2-54x1-9machined-pin-header-1x40p-180-l7-65-upper-pinpoint0-46-bottom-pinpoint0-46-au1u-pps/) | ₹126 | Soldered to the controllers, in place of their square headers. The controller rests on their plastic carrier: measure it on arrival. One strip makes three 12-pin rows; the two controllers take four |
| [ ] | OLED 0.96 in. I2C, white | 3 | Robu.in (in cart) | [OLED white](https://robu.in/product/0-96-inch-i2c-iic-oled-lcd-module-4pin-with-vcc-gnd-white/) | ₹657 | Pin order GND VCC SCL SDA. Measure the board, glass and lit area before ordering the plate or printing the case: the top frame holds the glass in a pocket. Remove the header if fitted |
| [ ] | Right-angle male pin header, 1×40, 2.54 mm, pack of 5 | 2 × 4 + 2 × 5 pins | AliExpress → Australia (in cart) | [DQLZV Official Store](https://www.aliexpress.com/item/1005006149080284.html), option 5PCS | AU$1.93 | One 1×4 piece per half in J101 / J201 (OLED) and one 1×5 piece in J102 / J202 (encoder): 18 of the 200 pins |
| [x] | Female–female jumper wires, 2.54 mm | 18 | Already owned | | — | Four per OLED and five per encoder, plug ends glued into one plug; the other ends soldered to the OLED or the encoder. Check you have 18 |
| [ ] | Rotary encoder EC11 with switch, D shaft, 20 mm | 2 | Robu.in (in cart) | [Hongyan EC11](https://robu.in/product/hongyan-ec11h-7ce20p1zd20-rotary-encoder-with-push-button-switch-vertical-plug-in-5-pin/) | ₹116 | D shaft ("hemicycle") to match the knob. Measure the delivered knob and test it on the coupon before cutting the shaft; see [build guide](../INSTRUCTIONS.md#when-the-parts-arrive) |
| [ ] | Knob, aluminium 17 × 13 mm, 6 mm D shaft, pack of 10 | 2 | AliExpress → Australia (in cart) | Good Good Cheap Electronics Wholesale Store | AU$11.19 | Option "D halfshaft 17x13" |
| [ ] | Battery, 3.7 V LiPo KP-355085 | 2 | BatteriesShop.in (in cart) | [KP-355085](https://batteriesshop.in/products/37v-3000mah-lithium-polymer-lipo-rechargeable-battery-model-kp-355085) | ₹425 each + 18% tax + ₹49 shipping (~₹1,052 total), plus any connector charge | Seller lists 3000 mAh and 3.5 × 50 × 85 mm. The photo appears to show a protection PCB, but the listing says protection is optional. Confirm both delivered packs have it and measure no more than 5 × 60 × 88 mm including the PCB. Ask the seller to fit JST-PH 2.0 plugs to both packs; bare insulated leads are acceptable if buying the plugs locally. Check polarity with a multimeter before plugging in. |
| [ ] | Battery cable, 2-pin JST-PH 2.0 plug with 10 cm wires, pack of 10 | 2 | AliExpress → Australia (in cart) | [XMS Store](https://www.aliexpress.com/item/1005007270514533.html), option Single head / 10PCS / 10CM / 2P | AU$2.61 | Plugs into the S2B-PH-K-S socket; solder the battery leads to its wires and heat-shrink them, unless BatteriesShop fits PH 2.0 plugs. Check polarity at the PCB's + pad before plugging in |
| [ ] | Battery connector S2B-PH-K-S | 10 | Robu.in (in cart) | [S2B-PH-K](https://robu.in/product/s2b-ph-klfsn-jst-1x2p-2p-ph-tin-2-25%e2%84%8385%e2%84%83-2a-1-2mm-brass-bend-insert-push-pullp2mm-wire-to-board-connector-rohs/) | ₹80 | Check it is the side-entry -S part |
| [ ] | P-MOSFET AO3401A, SOT-23 | 10 | Robu.in (in cart) | [AO3401A](https://robu.in/product/ao3401a-umwyoutai-semiconductor-co-ltd-30v-4-2a-50m%CF%8910v-1-4w-400mv-1-piece-p-channel-sot-23-mosfets-rohs/) | ₹36 | 2 used, the battery switches |
| [ ] | Resistor 1 MΩ, 1206 | 20 | Robu.in (in cart) | [1 MΩ](https://robu.in/product/1m-ohm-1-4w-1206-surface-mount-chip-resistor-pack-of-100/) | ₹10.80 | 20, not 10: Robu needs at least ₹10 per line |
| [ ] | Resistor 100 kΩ 1 %, 1206 (Yageo RC1206FR-13100KL) | 25 | Robu.in (in cart) | [100 kΩ 1 %](https://robu.in/product/rc1206fr-13100kl-yageo-250mw-thick-film-resistors-%c2%b1100ppm-%e2%84%83-%c2%b11-100k%cf%89-1206-chip-resistor-surface-mount-rohs/) | ₹20.50 | 4 used: the boost's feedback and enable resistors. 25 to clear Robu's ₹10 line minimum |
| [ ] | Resistor 732 kΩ 1 %, 1206 (Yageo RC1206FR-07732KL) | 25 | Robu.in (in cart) | [732 kΩ](https://robu.in/product/rc1206fr-07732kl-yageo-250mw-thick-film-resistors-200v-%c2%b1100ppm-%e2%84%83-%c2%b11-732k%cf%89-1206-chip-resistor-surface-mount-rohs/) | ₹10.75 (₹0.43 each) | 2 used, the boost's feedback divider. 25 for the line minimum |
| [ ] | Resistor 330 Ω 1 %, 0805 (Yageo RC0805FR-07330RL) | 25 | Robu.in (in cart) | [330 Ω](https://robu.in/product/rc0805fr-07330rl-yageo-res-thick-film-0805-330-ohm-1-0-125w1-8w-%c2%b1100ppm-c-pad-smd-t-r/) | ₹11 | 2 used, beside the first LED. 25 for the line minimum |
| [ ] | Capacitor 10 µF, 1206 | 10 | Robu.in (in cart) | [10 µF](https://robu.in/product/cl31a106kbhnnne-samsung-electro-samsung-electro-mechanics-cap-smd-mlcc-10-f-50-v-1206-pack-of-1/) | ₹110 | 4 used: the boosts' inputs and the last LEDs |
| [ ] | Capacitor 22 µF 16 V X7R, 1206 (Samwha CS3216X7R226K160NRI) | 10 | Robu.in (in cart) | [22 µF](https://robu.in/product/cs3216x7r226k160nri-samwha-16v-22uf-x7r-%c2%b110-1206-multilayer-ceramic-capacitors-mlcc-smd-smt-rohs/) | ₹60 (₹6 each) | 4 used, the boosts' outputs |
| [ ] | Capacitor 100 nF X7R, 0805 (Yageo CC0805KKX7R0BB104) | 20 | Robu.in (in cart) | [100 nF](https://robu.in/product/cc0805kkx7r0bb104-yageo-100v-100nf-x7r-%c2%b110-0805-multilayer-ceramic-capacitors-mlcc-smd-smt-rohs/) | ₹27.40 | 2 used, at the buffers; the rest for the optional footprints beside the LEDs |
| [ ] | Boost converter TI TPS61023DRLR, SOT-563 | 5 | Robu.in (in cart) | [TPS61023DRLR](https://robu.in/product/tps61023drlr-texas-instruments-boost-type-adjustable-2-2v5-5v-3a-500mv5-5v-sot-563-dc-dc-converters-rohs/) | ₹215 (₹43 each) | 2 used, the LED boosts. 0.5 mm pitch: spares for practice |
| [ ] | Inductor 1 µH, 1210 (TDK TMS322512ALM-1R0MTAA) | 5 | Robu.in (in cart) | [TMS322512ALM-1R0MTAA](https://robu.in/product/tms322512alm-1r0mtaa-tdk-4a-1uh-%c2%b120-4-6a-37m%cf%89-1210-inductors-smd-rohs/) | ₹125 (₹25 each) | 2 used, one per boost |
| [ ] | Buffer TI SN74LV1T125DBVR, SOT-23-5 | 5 | Robu.in (in cart) | [SN74LV1T125DBVR](https://robu.in/product/sn74lv1t125dbvr-texas-instruments-buffer-74lv1t125-1-6-v-to-5-5-v-sot-23-5/) | ₹115 (₹23 each) | 2 used, the LED data buffers |
| [ ] | Power switch SK12D07VG5 | 5 | Robu.in (in cart) | [SK12D07VG5](https://robu.in/product/sk12d07vg5-shou-han-500ma-single-pole-double-throw-spdt-50v-5-thousand-times-plugin-slide-switches-rohs/) | ₹12.60 | 5, not 2: Robu needs at least ₹10 per line |
| [ ] | Reset button, 6 × 6 × 5 mm | 10 | Robu.in (in cart) | [tact switch](https://robu.in/product/kfc-a06-5-0-tact-switch-4pin6x6x5/) | ₹13 | |
| [ ] | Case, PETG black: 2 bottom shells + 2 top frames | 4 parts | Robu.in (saved BOM "Keygen case and wedge print 2026-10-30") | [3D printing service](https://robu.in/product/3d-printing-service1/) | ₹959 (₹341 + ₹342 + ₹138 + ₹138) | Stage 2. Quoted from the current STLs at 0.2 mm, PETG black, 90 % infill. Robu keeps the print and the parts in separate carts: restore the saved BOM to order it. Ask for no supports: the steel disc's pocket bridges. Upload again if the socket or pin carrier height changes the case |
| [ ] | Heat-set inserts M2, 3 mm long, 3.5 mm OD, pack of 100 | 16 | AliExpress → Australia (in cart) | [brass heat insert nut](https://www.aliexpress.com/item/1005006798286851.html) | AU$5.19 | Size for the case's 3.2 mm holes. 84 left for other projects |
| [ ] | Case screws M2 × 16, socket head (ISO 4762), 304 stainless, pack of 50 | 16 | AliExpress → Australia (in cart) | [HZYUEGOU](https://www.aliexpress.com/item/32966941844.html), option 304 stainless steel / M2 / 16mm | AU$2.84 | Bottom shell to top frame, 8 per half. Same store as the button-head screws |
| [ ] | Plate standoffs M2 × 3 mm, brass hex, female-female, pack of 100 | 10 | AliExpress → Australia (in cart) | [brass standoff](https://www.aliexpress.com/item/1005008798318304.html), option M2 / 3mm | AU$4.49 | Each stands on a 0.5 mm shim: together they set the plate height for MX. 3.5 mm standoffs are not stocked |
| [ ] | Standoff shims, DIN 988 M2 2 × 5 × 0.5 mm, pack of 50 | 10 | AliExpress → Australia (in cart) | [shim washer](https://www.aliexpress.com/item/1005002301164770.html), option M2x5 / 0.5mm | AU$4.09 | One under each standoff, on the PCB |
| [ ] | Plate screws M2 × 5, button head, pack of 50 | 10 | AliExpress → Australia (in cart) | [HZYUEGOU ISO 7380](https://www.aliexpress.com/item/32967225441.html), option M2 (50pcs) / 5mm | AU$2.09 | One under the PCB into each standoff; nothing screws in from above |
| [ ] | Switch pads, Poron ring, pack of 120 | 66 | AliExpress → Australia (in cart) | [Apc Accessories Store](https://www.aliexpress.com/item/1005009936259305.html), option PORON | AU$4.22 | One round each switch on the PCB, under the plate foam. Open middle, so the LED window stays clear. Only 1 left. StacksKB's KBDFans pads are a different shape, made to sit under the switch |
| [ ] | Plate foam, EVA 2 mm, A4 | 2 sheets | Amazon.in (ordered 2026-11-08) | [black, pack of 10](https://www.amazon.in/dp/B0H4D6P874) | ₹140 | Laser-cut the left/right plate-foam DXFs from the build release; taped under the plate with the thin double-sided tape |
| [ ] | Case foam, EVA 5 mm, A4 | 2 sheets | Amazon.in (ordered 2026-11-08) | [black, pack of 5](https://www.amazon.in/dp/B0D2NJD4DK) | ₹249 | Goes on the bottom shell's floor, under the PCB. Laser-cut the left/right case-foam DXFs from the build release |
| [ ] | Gaskets, Poron strip 80 × 4 × 3 mm, pack of 20 | 32 pieces | AliExpress → Australia (in cart) | [gasket Poron strip](https://www.aliexpress.com/item/1005004800667967.html) | AU$6.91 | Cut each strip into six 12 mm pieces. Two per plate tab: one on the shell's ledge under the tab, one on top of it under the frame. Option 80x4x3MM |
| [ ] | Y cable, USB-A to 2 × USB-C, data and charging | 1 | AliExpress → Australia (in cart) | [Asia Market Choice Store](https://www.aliexpress.com/item/1005012373354214.html), option Black/1.8m | AU$6.14 | Optional. Powers both halves from one port, wired mode through the left. Find the data leg on arrival: plug only the left half into each leg in turn |
| [ ] | Tenting wedges, PETG black, 13° | 2 parts | Robu.in (same saved BOM) | [3D printing service](https://robu.in/product/3d-printing-service1/) | ₹1,221 (₹610 + ₹611) | Optional, and can follow the case. 0.2 mm, PETG black, 20 % infill, top face down, no supports. Upload again with the case if its height changes |
| [ ] | Wedge magnets, neodymium disc, N35, 10 × 3 mm, pack of 10 | 8 | AliExpress → Australia (in cart) | [N35 10 × 3 mm](https://www.aliexpress.com/item/1005010134212551.html), option 10x3-10piece | AU$5.09 | Four per wedge, superglued in. Fits the wedge's 10.3 mm pockets |
| [ ] | Steel plates, self-adhesive, round, 40 mm, black, pack of 5 | 2 | Amazon.in (ordered 2026-11-08) | [LIRAMARK 5 Round Plates](https://www.amazon.in/dp/B0D6N3WY1T) | ₹179 | One per half, pressed into the round pocket in the floor, flush. The wedge's magnets hold to it |
| [ ] | Rubber feet, silicone bumpers, clear, domed, 8 mm across, 3 mm tall, pack of 100 | 16 | Amazon.in (ordered 2026-11-08) | [HASTHIP 3x8mm](https://www.amazon.in/dp/B083DTH5HL) | ₹179 | Four per half, four under each wedge |
| [ ] | Wrist rests, memory foam, black, 130 mm wide, 18 mm tall | 2 | Amazon.in (ordered 2026-11-08) | [Techzere](https://www.amazon.in/dp/B08R41X5V6) | ₹598 | One per half. Raise it with a strip of 5 mm case EVA when tented |
| [ ] | Flux, no-clean 559 paste, 10 ml syringe | 1 | Amazon.in (ordered 2026-11-08) | [SCHOFIC UV-559](https://www.amazon.in/dp/B0F4RKKKX7) | ₹390 | For the LEDs and the SOT-23 parts |
| [ ] | Kapton tape, 12 mm × 33 m | 1 roll | Amazon.in (ordered 2026-11-08) | [AR Kapton 12 mm](https://www.amazon.in/dp/B0DQYJ7569) | ₹139 | |
| [ ] | Keycap and switch puller, 2-in-1 | 1 | StacksKB | [Switch Puller + Keycap puller](https://stackskb.com/store/switch-puller-keycap-puller/) | ₹200 | Same order as the switches |
| [ ] | Double-sided tape, thin (0.3 mm or less) | 1 roll | Stationery shop | | ~₹30 | Holds the battery in its bay and the plate foam under the plate. Tissue tape, not foam tape |
| [ ] | Superglue, heat-shrink tubing, a paint pen | 1 of each | Stationery or hardware shop | | ~₹100 | Superglue for the OLED plug and the magnets; heat-shrink for the battery joints; the pen marks pin 1 on the OLED plug |
| [ ] | Bench tools: iron, solder, wick, IPA, multimeter, calipers, 1.3 and 1.5 mm hex keys, flush cutters, fine hacksaw, pliers, file, craft knife, steel ruler, hot glue | Check what you have | | | | Listed in [INSTRUCTIONS.md](../INSTRUCTIONS.md#tools). The flush cutters are in the Amazon.in order (₹217) |
| [x] | Hotswap sockets, Kailh | 66 of 100 | Already owned | | | |
