milindmadhukar/keygen/fab/ORDER.md

# Ordering the Keygen PCBs (bare boards, self-assembly)

Place **two orders**: [`keygen-left-gerbers.zip`](https://github.com/milindmadhukar/keygen/releases/download/build/keygen-left-gerbers.zip) and
[`keygen-right-gerbers.zip`](https://github.com/milindmadhukar/keygen/releases/download/build/keygen-right-gerbers.zip), 5 of each, from the build release.
In the JLCPCB cart (2026-10-27): US$15.40 per half, US$40.63 for both with UPS to India, plus customs.
[`keygen-gerbers.zip`](https://github.com/milindmadhukar/keygen/releases/download/build/keygen-gerbers.zip) (both halves in one design) is kept for fabs that price it better.

| Setting | Value |
|---|---|
| Layers | 2 |
| Material | FR-4, 1.6 mm |
| Copper | 1 oz (35 µm) |
| Board size | both halves: 363.0 × 126.1 mm · one half: 160.3 × 126.1 mm |
| Quantity | 5 left + 5 right (two orders) |
| Surface finish | HASL lead-free (fine for hand soldering) |
| Mark on PCB | Remove Mark (keeps the fab's order number off the silkscreen artwork) |
| Soldermask / silkscreen | **black / white** (the silkscreen artwork is drawn for it; set in the board stackup) |
| Min track / clearance | 0.15 mm / 0.15 mm (6/6 mil; 0.15 mm only between the LED boost's pins, 0.2 mm elsewhere) |
| Min hole | 0.3 mm (vias); no blind/buried vias |
| Assembly | none (bare boards) |
| Stencil | not needed |

**Things to tell the fab or check in their DFM report**
- Each half has 33 small internal rectangular cut-outs (reverse-mount LED windows, about
  3.5 × 3.2 mm, with corner reliefs). They are on the Edge.Cuts layer and must be routed (milled).
- LED pads sit about 0.25 mm from those cut-outs (copper-to-edge 0.2 mm).
- The USB-C end of each controller overhangs the board edge by 1 mm on purpose (no copper there).
- The hotswap sockets' 3.0 mm holes leave a 0.15 mm annular ring on their 3.3 mm pads; the DFM report
  may flag it. It is the socket footprint's own and harmless.
- The LED boost U102 / U202 (SOT-563) has 0.15 mm between pads. If the DFM report removes the mask
  between its pins, accept it: solder it with flux and check for bridges.
- The LED windows are 3.40 × 3.00 mm for a 3.2 × 2.8 mm LED. If routing leaves one tight, file it.

Generated by `tools/export_fab.py` from `pcb/keygen.kicad_pcb`.
Files in each zip, named keygen-left-… and keygen-right-… in the half zips: keygen-B_Cu.gbl, keygen-B_Mask.gbs, keygen-B_Silkscreen.gbo, keygen-Edge_Cuts.gm1, keygen-F_Cu.gtl, keygen-F_Mask.gts, keygen-F_Silkscreen.gto, keygen-NPTH-drl_map.gbr, keygen-NPTH.drl, keygen-PTH-drl_map.gbr, keygen-PTH.drl, keygen-job.gbrjob
