milindmadhukar/keygen/fab/BOM-left.csv

Part | Qty | References | Value | Footprint | Notes
JST-PH 2-pin battery connector | 1 | BT101 | LiPo 3.7V 3000mAh | Connector_JST:JST_PH_S2B-PH-K_1x02_P2.00mm_Horizontal | through-hole side-entry, back side; check battery polarity first
22 µF capacitor (1206) | 2 | C101 C104 | 22uF | Capacitor_SMD:C_1206_3216Metric_Pad1.33x1.80mm_HandSolder | SMD, back side, at the boost's output
100 nF capacitor (0805) | 1 | C102 | 100nF | Capacitor_SMD:C_0805_2012Metric_Pad1.18x1.45mm_HandSolder | SMD, back side, beside the data buffer
10 µF capacitor (1206) | 2 | C103 C105 | 10uF | Capacitor_SMD:C_1206_3216Metric_Pad1.33x1.80mm_HandSolder | SMD, back side: C3 at the boost's input, C5 at the last LED
100 nF capacitor (0805), optional | 33 | C111 C112 C113 C114 C115 C116 C117 C118 C119 C120 C121 C122 C123 C124 C125 C126 C127 C128 C129 C130 C131 C132 C133 C134 C135 C136 C137 C138 C139 C140 C141 C142 C143 | 100nF | Capacitor_SMD:C_0805_2012Metric_Pad1.18x1.45mm_HandSolder | Not fitted: a footprint beside every LED, for extra decoupling if the chain glitches on full white
1N4148W diode | 34 | D101 D102 D103 D104 D105 D106 D107 D108 D109 D110 D111 D112 D113 D114 D115 D116 D117 D118 D119 D120 D121 D122 D123 D124 D125 D126 D127 D128 D129 D130 D131 D132 D133 D134 | 1N4148W | keygen:D_SOD-123_HandSolder | SOD-123, back side; band (cathode) over the bar in its silkscreen outline, at pad 1
EC11 rotary encoder | 1 | ENC101 | EC11 | keygen:EC11_Case_Mount | held in the top frame by its M7 nut, 20 mm D shaft
OLED 0.96in I2C | 1 | J101 | OLED 0.96in I2C | Connector_PinHeader_2.54mm:PinHeader_1x04_P2.54mm_Vertical
1x5 right-angle pin header | 1 | J102 | Encoder lead, 1x5 right angle | Connector_PinHeader_2.54mm:PinHeader_1x05_P2.54mm_Horizontal | through-hole, back side, pins lying flat and pointing away from the thumb keys
1 µH inductor (1210) | 1 | L101 | 1uH | Inductor_SMD:L_1210_3225Metric_Pad1.42x2.65mm_HandSolder | SMD, back side, beside the boost
SK6812MINI-E LED | 33 | LED101 LED102 LED103 LED104 LED105 LED106 LED107 LED108 LED109 LED110 LED111 LED112 LED113 LED114 LED115 LED116 LED117 LED118 LED119 LED120 LED121 LED122 LED123 LED124 LED125 LED126 LED127 LED128 LED129 LED130 LED131 LED132 LED133 | SK6812MINI-E | LED_SMD:LED_SK6812MINI-E_3.2x2.8mm_P1.5mm_ReverseMount | SMD, reverse-mount on the back; mind the corner mark
AO3401A P-MOSFET (SOT-23) | 1 | Q101 | AO3401A | Package_TO_SOT_SMD:SOT-23 | SMD, back side, between the controller and the power switch
1 MΩ resistor (1206) | 1 | R101 | 1M | Resistor_SMD:R_1206_3216Metric_Pad1.30x1.75mm_HandSolder | SMD, back side, below the battery MOSFET
732 kΩ resistor, 1 % (1206) | 1 | R102 | 732k | Resistor_SMD:R_1206_3216Metric_Pad1.30x1.75mm_HandSolder | SMD, back side, beside the boost
100 kΩ resistor, 1 % (1206) | 2 | R103 R104 | 100k | Resistor_SMD:R_1206_3216Metric_Pad1.30x1.75mm_HandSolder | SMD, back side: R3 below the boost (enable), R4 beside it (feedback)
330 Ω resistor (0805) | 1 | R105 | 330 | Resistor_SMD:R_0805_2012Metric_Pad1.20x1.40mm_HandSolder | SMD, back side, beside the data buffer and the first LED
MX switch, 1.25u key | 7 | SW101 SW108 SW114 SW121 SW132 SW133 SW134 | = | keygen:SW_MX_HS_CPG151101S11_1.25u | Kailh socket on the back; switch + 1.25u keycap (the two tall thumb keys turned 90°)
MX switch, 1u key | 26 | SW102 SW103 SW104 SW105 SW106 SW109 SW110 SW111 SW112 SW113 SW115 SW116 SW117 SW118 SW119 SW120 SW122 SW123 SW124 SW125 SW126 SW127 SW128 SW129 SW130 SW131 | 1 | keygen:SW_MX_HS_CPG151101S11_1u | Kailh socket on the back; switch + 1u keycap on top
SK12D07VG5 power slide switch | 1 | SW190 | SK12D07VG5 power | keygen:SW_SK12D07VG5 | through-hole, back side at the top edge, knob out; pins trimmed flush on the front
6 mm reset button | 1 | SW191 | Reset | Button_Switch_THT:SW_PUSH_6mm_H5mm | through-hole, back side
nRF52840 SuperMini (nice!nano v2 clone) | 1 | U101 | nRF52840 Pro Micro | keygen:nice_nano_H_USBup | on the back, socketed (Mill-Max/low-profile); check B+, GND and VCC first
TPS61023 boost converter (SOT-563) | 1 | U102 | TPS61023 | keygen:SOT-563_HandSolder | SMD, back side, beside the battery connector; 0.5 mm pitch: flux, then a fine tip or hot air. Pin 1 to the footprint's mark
SN74LV1T125 buffer (SOT-23-5) | 1 | U103 | SN74LV1T125 | Package_TO_SOT_SMD:SOT-23-5_HandSoldering | SMD, back side, beside the first LED
