milindmadhukar/keygen/fab/BOM-right.csv

Part | Qty | References | Value | Footprint | Notes
JST-PH 2-pin battery connector | 1 | BT201 | LiPo 3.7V 3000mAh | Connector_JST:JST_PH_S2B-PH-K_1x02_P2.00mm_Horizontal | through-hole side-entry, back side; check battery polarity first
22 µF capacitor (1206) | 2 | C201 C204 | 22uF | Capacitor_SMD:C_1206_3216Metric_Pad1.33x1.80mm_HandSolder | SMD, back side, at the boost's output
100 nF capacitor (0805) | 1 | C202 | 100nF | Capacitor_SMD:C_0805_2012Metric_Pad1.18x1.45mm_HandSolder | SMD, back side, beside the data buffer
10 µF capacitor (1206) | 2 | C203 C205 | 10uF | Capacitor_SMD:C_1206_3216Metric_Pad1.33x1.80mm_HandSolder | SMD, back side: C3 at the boost's input, C5 at the last LED
100 nF capacitor (0805), optional | 33 | C211 C212 C213 C214 C215 C216 C217 C218 C219 C220 C221 C222 C223 C224 C225 C226 C227 C228 C229 C230 C231 C232 C233 C234 C235 C236 C237 C238 C239 C240 C241 C242 C243 | 100nF | Capacitor_SMD:C_0805_2012Metric_Pad1.18x1.45mm_HandSolder | Not fitted: a footprint beside every LED, for extra decoupling if the chain glitches on full white
1N4148W diode | 34 | D201 D202 D203 D204 D205 D206 D207 D208 D209 D210 D211 D212 D213 D214 D215 D216 D217 D218 D219 D220 D221 D222 D223 D224 D225 D226 D227 D228 D229 D230 D231 D232 D233 D234 | 1N4148W | keygen:D_SOD-123_HandSolder | SOD-123, back side; band (cathode) over the bar in its silkscreen outline, at pad 1
EC11 rotary encoder | 1 | ENC201 | EC11 | keygen:EC11_Case_Mount | held in the top frame by its M7 nut, 20 mm D shaft
OLED 0.96in I2C | 1 | J201 | OLED 0.96in I2C | Connector_PinHeader_2.54mm:PinHeader_1x04_P2.54mm_Vertical
1x5 right-angle pin header | 1 | J202 | Encoder lead, 1x5 right angle | Connector_PinHeader_2.54mm:PinHeader_1x05_P2.54mm_Horizontal | through-hole, back side, pins lying flat and pointing away from the thumb keys
1 µH inductor (1210) | 1 | L201 | 1uH | Inductor_SMD:L_1210_3225Metric_Pad1.42x2.65mm_HandSolder | SMD, back side, beside the boost
SK6812MINI-E LED | 33 | LED201 LED202 LED203 LED204 LED205 LED206 LED207 LED208 LED209 LED210 LED211 LED212 LED213 LED214 LED215 LED216 LED217 LED218 LED219 LED220 LED221 LED222 LED223 LED224 LED225 LED226 LED227 LED228 LED229 LED230 LED231 LED232 LED233 | SK6812MINI-E | LED_SMD:LED_SK6812MINI-E_3.2x2.8mm_P1.5mm_ReverseMount | SMD, reverse-mount on the back; mind the corner mark
AO3401A P-MOSFET (SOT-23) | 1 | Q201 | AO3401A | Package_TO_SOT_SMD:SOT-23 | SMD, back side, between the controller and the power switch
1 MΩ resistor (1206) | 1 | R201 | 1M | Resistor_SMD:R_1206_3216Metric_Pad1.30x1.75mm_HandSolder | SMD, back side, below the battery MOSFET
732 kΩ resistor, 1 % (1206) | 1 | R202 | 732k | Resistor_SMD:R_1206_3216Metric_Pad1.30x1.75mm_HandSolder | SMD, back side, beside the boost
100 kΩ resistor, 1 % (1206) | 2 | R203 R204 | 100k | Resistor_SMD:R_1206_3216Metric_Pad1.30x1.75mm_HandSolder | SMD, back side: R3 below the boost (enable), R4 beside it (feedback)
330 Ω resistor (0805) | 1 | R205 | 330 | Resistor_SMD:R_0805_2012Metric_Pad1.20x1.40mm_HandSolder | SMD, back side, beside the data buffer and the first LED
MX switch, 1.25u key | 7 | SW201 SW208 SW214 SW221 SW232 SW233 SW234 | - | keygen:SW_MX_HS_CPG151101S11_1.25u | Kailh socket on the back; switch + 1.25u keycap (the two tall thumb keys turned 90°)
MX switch, 1u key | 26 | SW202 SW203 SW204 SW205 SW206 SW209 SW210 SW211 SW212 SW213 SW215 SW216 SW217 SW218 SW219 SW220 SW222 SW223 SW224 SW225 SW226 SW227 SW228 SW229 SW230 SW231 | 0 | keygen:SW_MX_HS_CPG151101S11_1u | Kailh socket on the back; switch + 1u keycap on top
SK12D07VG5 power slide switch | 1 | SW290 | SK12D07VG5 power | keygen:SW_SK12D07VG5 | through-hole, back side at the top edge, knob out; pins trimmed flush on the front
6 mm reset button | 1 | SW291 | Reset | Button_Switch_THT:SW_PUSH_6mm_H5mm | through-hole, back side
nRF52840 SuperMini (nice!nano v2 clone) | 1 | U201 | nRF52840 Pro Micro | keygen:nice_nano_H_USBup | on the back, socketed (Mill-Max/low-profile); check B+, GND and VCC first
TPS61023 boost converter (SOT-563) | 1 | U202 | TPS61023 | keygen:SOT-563_HandSolder | SMD, back side, beside the battery connector; 0.5 mm pitch: flux, then a fine tip or hot air. Pin 1 to the footprint's mark
SN74LV1T125 buffer (SOT-23-5) | 1 | U203 | SN74LV1T125 | Package_TO_SOT_SMD:SOT-23-5_HandSoldering | SMD, back side, beside the first LED
