milindmadhukar/keygen/case/3mf/keygen.3mf

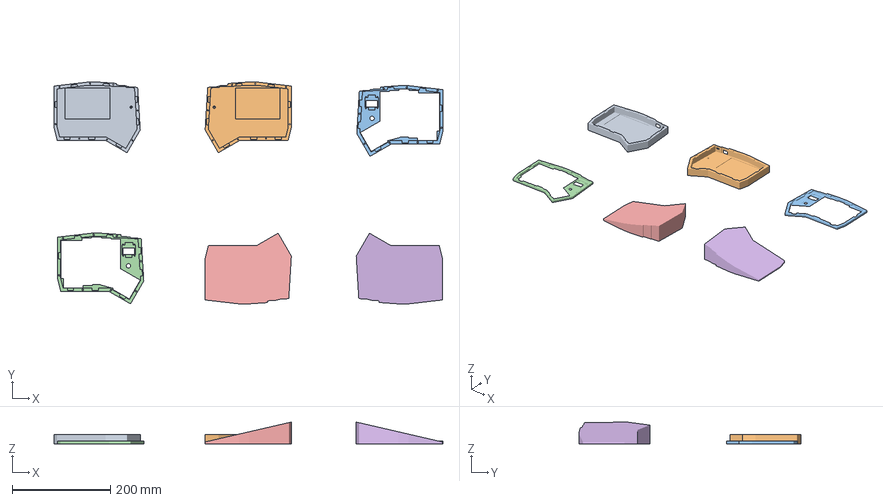
[picture p2: CAD file, 2026-11-11]
case/3mf/keygen.3mf
790.8 x 450.9 x 44.5 mm
keygen-left-bottom.stl
keygen-right-bottom.stl
keygen-left-top.stl
keygen-right-top.stl
keygen-left-wedge.stl
keygen-right-wedge.stl
