milindmadhukar/keygen/case/bottom/stl/keygen-right-bottom.3mf

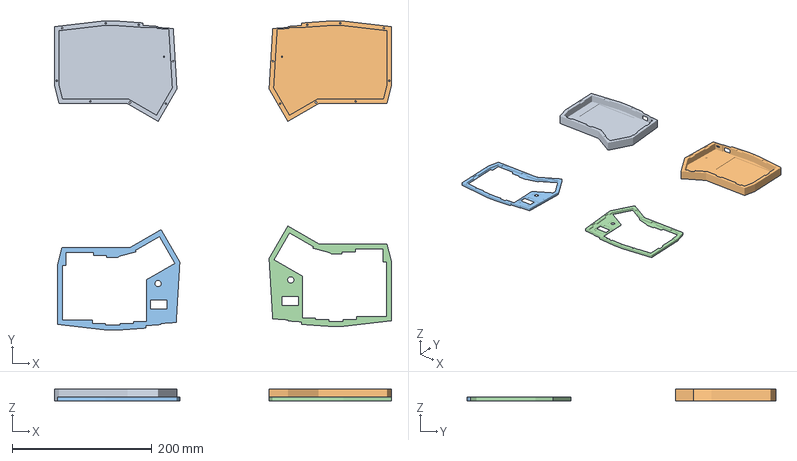
[picture p3: CAD file, 2026-11-11]
case/bottom/stl/keygen-right-bottom.3mf
482.6 x 442.3 x 17.1 mm
keygen-left-bottom.stl
keygen-right-bottom.stl
keygen-left-top.stl
keygen-right-top.stl
