milindmadhukar/keygen/(list of files, cad)

Other CAD files:
blender/keygen.blend
