milindmadhukar/keygen/pcb/keygen.kicad_pcb

## KiCad design pcb/keygen.kicad_pcb (2026-11-11)

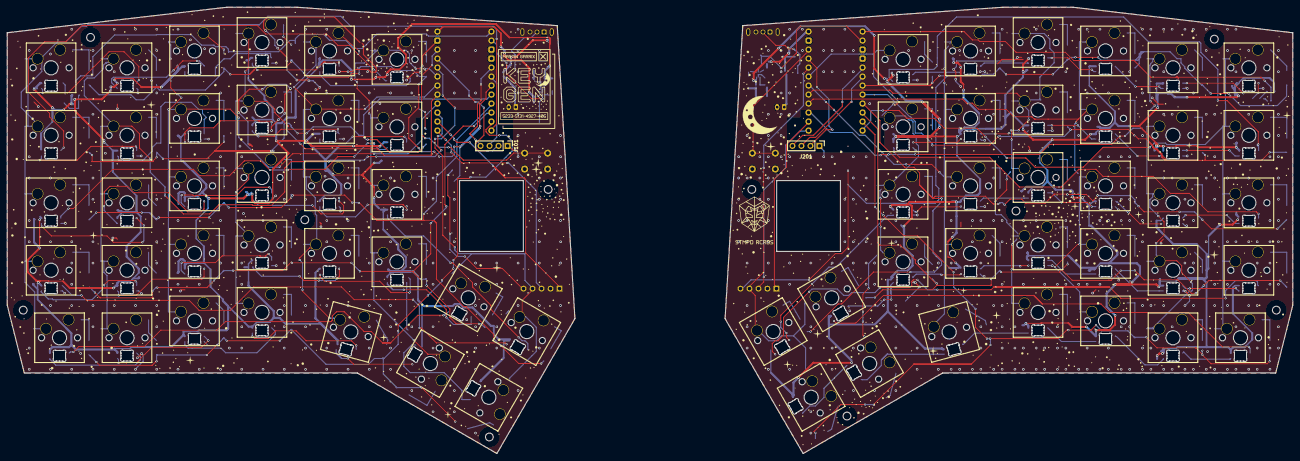
[picture p4: board keygen.kicad_pcb from above]

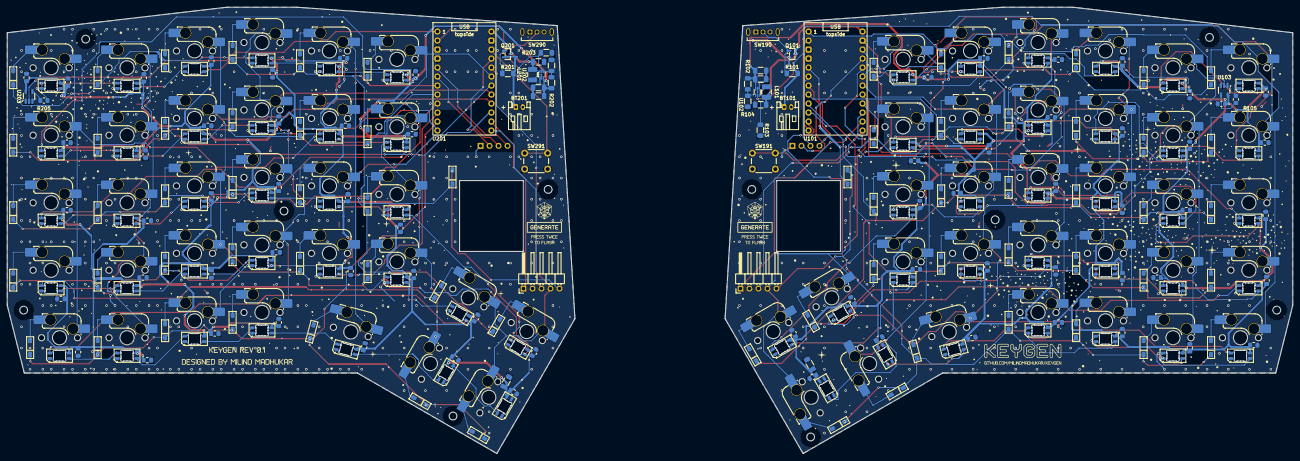
[picture p5: board keygen.kicad_pcb from below]

Board: 2 copper layers, 362.9 x 126.0 mm, 318 parts (304 on the bottom side), 190 nets.

Parts:
BT101, BT201: LiPo 3.7V 3000mAh; JST_PH_S2B-PH-K_1x02_P2.00mm_Horizontal
C101, C104, C201, C204: 22uF; C_1206_3216Metric_Pad1.33x1.80mm_HandSolder
C102, C111, C112, C113, C114, C115, C116, C117, C118, C119, C120, C121, C122, C123, C124, C125, C126, C127, C128, C129, C130, C131, C132, C133, C134, C135, C136, C137, C138, C139, C140, C141, C142, C143, C202, C211, C212, C213, C214, C215, C216, C217, C218, C219, C220, C221, C222, C223, C224, C225, C226, C227, C228, C229, C230, C231, C232, C233, C234, C235, C236, C237, C238, C239, C240, C241, C242, C243: 100nF; C_0805_2012Metric_Pad1.18x1.45mm_HandSolder
C103, C105, C203, C205: 10uF; C_1206_3216Metric_Pad1.33x1.80mm_HandSolder
D101, D102, D103, D104, D105, D106, D107, D108, D109, D110, D111, D112, D113, D114, D115, D116, D117, D118, D119, D120, D121, D122, D123, D124, D125, D126, D127, D128, D129, D130, D131, D132, D133, D134, D201, D202, D203, D204, D205, D206, D207, D208, D209, D210, D211, D212, D213, D214, D215, D216, D217, D218, D219, D220, D221, D222, D223, D224, D225, D226, D227, D228, D229, D230, D231, D232, D233, D234: 1N4148W; D_SOD-123_HandSolder
ENC101, ENC201: EC11; EC11_Case_Mount
H101, H102, H103, H104, H105, H201, H202, H203, H204, H205: M2; MountingHole_2.2mm_M2
J101, J201: OLED 0.96in I2C; PinHeader_1x04_P2.54mm_Vertical
J102, J202: Encoder lead, 1x5 right angle; PinHeader_1x05_P2.54mm_Horizontal
L101, L201: 1uH; L_1210_3225Metric_Pad1.42x2.65mm_HandSolder
LED101, LED102, LED103, LED104, LED105, LED106, LED107, LED108, LED109, LED110, LED111, LED112, LED113, LED114, LED115, LED116, LED117, LED118, LED119, LED120, LED121, LED122, LED123, LED124, LED125, LED126, LED127, LED128, LED129, LED130, LED131, LED132, LED133, LED201, LED202, LED203, LED204, LED205, LED206, LED207, LED208, LED209, LED210, LED211, LED212, LED213, LED214, LED215, LED216, LED217, LED218, LED219, LED220, LED221, LED222, LED223, LED224, LED225, LED226, LED227, LED228, LED229, LED230, LED231, LED232, LED233: SK6812MINI-E; LED_SK6812MINI-E_3.2x2.8mm_P1.5mm_ReverseMount
Q101, Q201: AO3401A; SOT-23
R101, R201: 1M; R_1206_3216Metric_Pad1.30x1.75mm_HandSolder
R102, R202: 732k; R_1206_3216Metric_Pad1.30x1.75mm_HandSolder
R103, R104, R203, R204: 100k; R_1206_3216Metric_Pad1.30x1.75mm_HandSolder
R105, R205: 330; R_0805_2012Metric_Pad1.20x1.40mm_HandSolder
SW101: =; SW_MX_HS_CPG151101S11_1.25u
SW102: 1; SW_MX_HS_CPG151101S11_1u
SW103: 2; SW_MX_HS_CPG151101S11_1u
SW104: 3; SW_MX_HS_CPG151101S11_1u
SW105: 4; SW_MX_HS_CPG151101S11_1u
SW106: 5; SW_MX_HS_CPG151101S11_1u
SW108: Tab; SW_MX_HS_CPG151101S11_1.25u
SW109: Q; SW_MX_HS_CPG151101S11_1u
SW110: W; SW_MX_HS_CPG151101S11_1u
SW111: E; SW_MX_HS_CPG151101S11_1u
SW112: R; SW_MX_HS_CPG151101S11_1u
SW113: T; SW_MX_HS_CPG151101S11_1u
SW114: Esc; SW_MX_HS_CPG151101S11_1.25u
SW115: A; SW_MX_HS_CPG151101S11_1u
SW116: S; SW_MX_HS_CPG151101S11_1u
SW117: D; SW_MX_HS_CPG151101S11_1u
SW118: F; SW_MX_HS_CPG151101S11_1u
SW119: G; SW_MX_HS_CPG151101S11_1u
SW120, SW220: Alt; SW_MX_HS_CPG151101S11_1u
SW121, SW221: Shift; SW_MX_HS_CPG151101S11_1.25u
SW122: Z; SW_MX_HS_CPG151101S11_1u
SW123: X; SW_MX_HS_CPG151101S11_1u
SW124: C; SW_MX_HS_CPG151101S11_1u
SW125: V; SW_MX_HS_CPG151101S11_1u
SW126: B; SW_MX_HS_CPG151101S11_1u
SW127, SW227: Ctrl; SW_MX_HS_CPG151101S11_1u
SW128: `; SW_MX_HS_CPG151101S11_1u
SW129: Caps; SW_MX_HS_CPG151101S11_1u
SW130: Left; SW_MX_HS_CPG151101S11_1u
SW131: Right; SW_MX_HS_CPG151101S11_1u
SW132: Super; SW_MX_HS_CPG151101S11_1.25u
SW133: Bksp; SW_MX_HS_CPG151101S11_1.25u
SW134: Del; SW_MX_HS_CPG151101S11_1.25u
SW190, SW290: SK12D07VG5 power; SW_SK12D07VG5
SW191, SW291: Reset; SW_PUSH_6mm_H5mm
SW201: -; SW_MX_HS_CPG151101S11_1.25u
SW202: 0; SW_MX_HS_CPG151101S11_1u
SW203: 9; SW_MX_HS_CPG151101S11_1u
SW204: 8; SW_MX_HS_CPG151101S11_1u
SW205: 7; SW_MX_HS_CPG151101S11_1u
SW206: 6; SW_MX_HS_CPG151101S11_1u
SW208: \; SW_MX_HS_CPG151101S11_1.25u
SW209: P; SW_MX_HS_CPG151101S11_1u
SW210: O; SW_MX_HS_CPG151101S11_1u
SW211: I; SW_MX_HS_CPG151101S11_1u
SW212: U; SW_MX_HS_CPG151101S11_1u
SW213: Y; SW_MX_HS_CPG151101S11_1u
SW214: '; SW_MX_HS_CPG151101S11_1.25u
SW215: ;; SW_MX_HS_CPG151101S11_1u
SW216: L; SW_MX_HS_CPG151101S11_1u
SW217: K; SW_MX_HS_CPG151101S11_1u
SW218: J; SW_MX_HS_CPG151101S11_1u
SW219: H; SW_MX_HS_CPG151101S11_1u
SW222: /; SW_MX_HS_CPG151101S11_1u
SW223: .; SW_MX_HS_CPG151101S11_1u
SW224: ,; SW_MX_HS_CPG151101S11_1u
SW225: M; SW_MX_HS_CPG151101S11_1u
SW226: N; SW_MX_HS_CPG151101S11_1u
SW228: ]; SW_MX_HS_CPG151101S11_1u
SW229: [; SW_MX_HS_CPG151101S11_1u
SW230: Down; SW_MX_HS_CPG151101S11_1u
SW231: Up; SW_MX_HS_CPG151101S11_1u
SW232: Fn; SW_MX_HS_CPG151101S11_1.25u
SW233: Space; SW_MX_HS_CPG151101S11_1.25u
SW234: Enter; SW_MX_HS_CPG151101S11_1.25u
U101, U201: nRF52840 Pro Micro; nice_nano_H_USBup
U102, U202: TPS61023; SOT-563_HandSolder
U103, U203: SN74LV1T125; SOT-23-5_HandSoldering

Connections:
/left/BAT_GATE: Q101.1, R101.1, SW190.2
/left/BAT_RAW: BT101.1, Q101.2, R101.2
/left/COL0: SW101.1, SW108.1, SW114.1, SW121.1, SW128.1, U101.12
/left/COL1: SW102.1, SW109.1, SW115.1, SW122.1, SW129.1, U101.22
/left/COL2: SW103.1, SW110.1, SW116.1, SW123.1, SW130.1, U101.21
/left/COL3: SW104.1, SW111.1, SW117.1, SW124.1, SW131.1, U101.20
/left/COL4: SW105.1, SW112.1, SW118.1, SW125.1, SW132.1, U101.19
/left/COL5: SW106.1, SW113.1, SW119.1, SW126.1, SW133.1, U101.18
/left/COL6: J102.4, SW120.1, SW127.1, SW134.1, U101.17
/left/ENC_A: J102.1, U101.23
/left/ENC_B: J102.3, U101.24
/left/GND: BT101.2, C101.2, C102.2, C103.2, C104.2, C105.2, C111.2, C112.2, C113.2, C114.2, C115.2, C116.2, C117.2, C118.2, C119.2, C120.2, C121.2, C122.2, C123.2, C124.2, C125.2, C126.2, C127.2, C128.2, C129.2, C130.2, C131.2, C132.2, C133.2, C134.2, C135.2, C136.2, C137.2, C138.2, C139.2, C140.2, C141.2, C142.2, C143.2, J101.1, J102.2, LED101.1, LED102.1, LED103.1, LED104.1, LED105.1, LED106.1, LED107.1, LED108.1, LED109.1, LED110.1, LED111.1, LED112.1, LED113.1, LED114.1, LED115.1, LED116.1, LED117.1, LED118.1, LED119.1, LED120.1, LED121.1, LED122.1, LED123.1, LED124.1, LED125.1, LED126.1, LED127.1, LED128.1, LED129.1, LED130.1, LED131.1, LED132.1, LED133.1, R103.2, R104.2, SW190.1, SW191.2, U101.3, U101.4, U101.14, U102.4, U103.1, U103.3
/left/K00: D101.2, SW101.2
/left/K01: D102.2, SW102.2
/left/K02: D103.2, SW103.2
/left/K03: D104.2, SW104.2
/left/K04: D105.2, SW105.2
/left/K05: D106.2, SW106.2
/left/K06: D107.2, J102.5
/left/K10: D108.2, SW108.2
/left/K11: D109.2, SW109.2
/left/K12: D110.2, SW110.2
/left/K13: D111.2, SW111.2
/left/K14: D112.2, SW112.2
/left/K15: D113.2, SW113.2
/left/K20: D114.2, SW114.2
/left/K21: D115.2, SW115.2
/left/K22: D116.2, SW116.2
/left/K23: D117.2, SW117.2
/left/K24: D118.2, SW118.2
/left/K25: D119.2, SW119.2
/left/K26: D120.2, SW120.2
/left/K30: D121.2, SW121.2
/left/K31: D122.2, SW122.2
/left/K32: D123.2, SW123.2
/left/K33: D124.2, SW124.2
/left/K34: D125.2, SW125.2
/left/K35: D126.2, SW126.2
/left/K36: D127.2, SW127.2
/left/K40: D128.2, SW128.2
/left/K41: D129.2, SW129.2
/left/K42: D130.2, SW130.2
/left/K43: D131.2, SW131.2
/left/K44: D132.2, SW132.2
/left/K45: D133.2, SW133.2
/left/K46: D134.2, SW134.2
/left/LED_D0: LED101.2, R105.2
/left/LED_D1: LED101.4, LED102.2
/left/LED_D2: LED102.4, LED103.2
/left/LED_D3: LED103.4, LED104.2
/left/LED_D4: LED104.4, LED105.2
/left/LED_D5: LED105.4, LED106.2
/left/LED_D6: LED106.4, LED107.2
/left/LED_D7: LED107.4, LED108.2
/left/LED_D8: LED108.4, LED109.2
/left/LED_D9: LED109.4, LED110.2
/left/LED_D10: LED110.4, LED111.2
/left/LED_D11: LED111.4, LED112.2
/left/LED_D12: LED112.4, LED113.2
/left/LED_D13: LED113.4, LED114.2
/left/LED_D14: LED114.4, LED115.2
/left/LED_D15: LED115.4, LED116.2
/left/LED_D16: LED116.4, LED117.2
/left/LED_D17: LED117.4, LED118.2
/left/LED_D18: LED118.4, LED119.2
/left/LED_D19: LED119.4, LED120.2
/left/LED_D20: LED120.4, LED121.2
/left/LED_D21: LED121.4, LED122.2
/left/LED_D22: LED122.4, LED123.2
/left/LED_D23: LED123.4, LED124.2
/left/LED_D24: LED124.4, LED125.2
/left/LED_D25: LED125.4, LED126.2
/left/LED_D26: LED126.4, LED127.2
/left/LED_D27: LED127.4, LED128.2
/left/LED_D28: LED128.4, LED129.2
/left/LED_D29: LED129.4, LED130.2
/left/LED_D30: LED130.4, LED131.2
/left/LED_D31: LED131.4, LED132.2
/left/LED_D32: LED132.4, LED133.2
/left/LED_DIN: U101.1, U103.2
/left/LED_DY: R105.1, U103.4
/left/LED_EN: R103.1, U101.2, U102.2
/left/LED_FB: R102.2, R104.1, U102.1
/left/LED_SW: L101.2, U102.5
/left/LED_VDD: C101.1, C102.1, C104.1, C105.1, C111.1, C112.1, C113.1, C114.1, C115.1, C116.1, C117.1, C118.1, C119.1, C120.1, C121.1, C122.1, C123.1, C124.1, C125.1, C126.1, C127.1, C128.1, C129.1, C130.1, C131.1, C132.1, C133.1, C134.1, C135.1, C136.1, C137.1, C138.1, C139.1, C140.1, C141.1, C142.1, C143.1, LED101.3, LED102.3, LED103.3, LED104.3, LED105.3, LED106.3, LED107.3, LED108.3, LED109.3, LED110.3, LED111.3, LED112.3, LED113.3, LED114.3, LED115.3, LED116.3, LED117.3, LED118.3, LED119.3, LED120.3, LED121.3, LED122.3, LED123.3, LED124.3, LED125.3, LED126.3, LED127.3, LED128.3, LED129.3, LED130.3, LED131.3, LED132.3, LED133.3, R102.1, U102.6, U103.5
/left/OLED_SCL: J101.3, U101.6
/left/OLED_SDA: J101.4, U101.5
/left/ROW0: D101.1, D102.1, D103.1, D104.1, D105.1, D106.1, D107.1, U101.7
/left/ROW1: D108.1, D109.1, D110.1, D111.1, D112.1, D113.1, U101.8
/left/ROW2: D114.1, D115.1, D116.1, D117.1, D118.1, D119.1, D120.1, U101.9
/left/ROW3: D121.1, D122.1, D123.1, D124.1, D125.1, D126.1, D127.1, U101.10
/left/ROW4: D128.1, D129.1, D130.1, D131.1, D132.1, D133.1, D134.1, U101.11
/left/RST: SW191.1, U101.15
/left/VBAT: C103.1, L101.1, Q101.3, U101.13, U102.3
/left/VCC: J101.2, U101.16
/right/BAT_GATE: Q201.1, R201.1, SW290.2
/right/BAT_RAW: BT201.1, Q201.2, R201.2
/right/COL0: SW201.1, SW208.1, SW214.1, SW221.1, SW228.1, U201.12
/right/COL1: SW202.1, SW209.1, SW215.1, SW222.1, SW229.1, U201.22
/right/COL2: SW203.1, SW210.1, SW216.1, SW223.1, SW230.1, U201.21
/right/COL3: SW204.1, SW211.1, SW217.1, SW224.1, SW231.1, U201.20
/right/COL4: SW205.1, SW212.1, SW218.1, SW225.1, SW232.1, U201.19
/right/COL5: SW206.1, SW213.1, SW219.1, SW226.1, SW233.1, U201.18
/right/COL6: J202.4, SW220.1, SW227.1, SW234.1, U201.17
/right/ENC_A: J202.1, U201.23
/right/ENC_B: J202.3, U201.24
/right/GND: BT201.2, C201.2, C202.2, C203.2, C204.2, C205.2, C211.2, C212.2, C213.2, C214.2, C215.2, C216.2, C217.2, C218.2, C219.2, C220.2, C221.2, C222.2, C223.2, C224.2, C225.2, C226.2, C227.2, C228.2, C229.2, C230.2, C231.2, C232.2, C233.2, C234.2, C235.2, C236.2, C237.2, C238.2, C239.2, C240.2, C241.2, C242.2, C243.2, J201.1, J202.2, LED201.1, LED202.1, LED203.1, LED204.1, LED205.1, LED206.1, LED207.1, LED208.1, LED209.1, LED210.1, LED211.1, LED212.1, LED213.1, LED214.1, LED215.1, LED216.1, LED217.1, LED218.1, LED219.1, LED220.1, LED221.1, LED222.1, LED223.1, LED224.1, LED225.1, LED226.1, LED227.1, LED228.1, LED229.1, LED230.1, LED231.1, LED232.1, LED233.1, R203.2, R204.2, SW290.1, SW291.2, U201.3, U201.4, U201.14, U202.4, U203.1, U203.3
/right/K00: D201.2, SW201.2
/right/K01: D202.2, SW202.2
/right/K02: D203.2, SW203.2
/right/K03: D204.2, SW204.2
/right/K04: D205.2, SW205.2
/right/K05: D206.2, SW206.2
/right/K06: D207.2, J202.5
/right/K10: D208.2, SW208.2
/right/K11: D209.2, SW209.2
/right/K12: D210.2, SW210.2
/right/K13: D211.2, SW211.2
/right/K14: D212.2, SW212.2
/right/K15: D213.2, SW213.2
/right/K20: D214.2, SW214.2
/right/K21: D215.2, SW215.2
/right/K22: D216.2, SW216.2
/right/K23: D217.2, SW217.2
/right/K24: D218.2, SW218.2
/right/K25: D219.2, SW219.2
/right/K26: D220.2, SW220.2
/right/K30: D221.2, SW221.2
/right/K31: D222.2, SW222.2
/right/K32: D223.2, SW223.2
/right/K33: D224.2, SW224.2
/right/K34: D225.2, SW225.2
/right/K35: D226.2, SW226.2
/right/K36: D227.2, SW227.2
/right/K40: D228.2, SW228.2
/right/K41: D229.2, SW229.2
/right/K42: D230.2, SW230.2
/right/K43: D231.2, SW231.2
/right/K44: D232.2, SW232.2
/right/K45: D233.2, SW233.2
/right/K46: D234.2, SW234.2
/right/LED_D0: LED201.2, R205.2
/right/LED_D1: LED201.4, LED202.2
/right/LED_D2: LED202.4, LED203.2
/right/LED_D3: LED203.4, LED204.2
/right/LED_D4: LED204.4, LED205.2
/right/LED_D5: LED205.4, LED206.2
/right/LED_D6: LED206.4, LED207.2
/right/LED_D7: LED207.4, LED208.2
/right/LED_D8: LED208.4, LED209.2
/right/LED_D9: LED209.4, LED210.2
/right/LED_D10: LED210.4, LED211.2
/right/LED_D11: LED211.4, LED212.2
/right/LED_D12: LED212.4, LED213.2
/right/LED_D13: LED213.4, LED214.2
/right/LED_D14: LED214.4, LED215.2
/right/LED_D15: LED215.4, LED216.2
/right/LED_D16: LED216.4, LED217.2
/right/LED_D17: LED217.4, LED218.2
/right/LED_D18: LED218.4, LED219.2
/right/LED_D19: LED219.4, LED220.2
/right/LED_D20: LED220.4, LED221.2
/right/LED_D21: LED221.4, LED222.2
/right/LED_D22: LED222.4, LED223.2
/right/LED_D23: LED223.4, LED224.2
/right/LED_D24: LED224.4, LED225.2
/right/LED_D25: LED225.4, LED226.2
/right/LED_D26: LED226.4, LED227.2
/right/LED_D27: LED227.4, LED228.2
/right/LED_D28: LED228.4, LED229.2
/right/LED_D29: LED229.4, LED230.2
/right/LED_D30: LED230.4, LED231.2
/right/LED_D31: LED231.4, LED232.2
/right/LED_D32: LED232.4, LED233.2
/right/LED_DIN: U201.1, U203.2
/right/LED_DY: R205.1, U203.4
/right/LED_EN: R203.1, U201.2, U202.2
/right/LED_FB: R202.2, R204.1, U202.1
/right/LED_SW: L201.2, U202.5
/right/LED_VDD: C201.1, C202.1, C204.1, C205.1, C211.1, C212.1, C213.1, C214.1, C215.1, C216.1, C217.1, C218.1, C219.1, C220.1, C221.1, C222.1, C223.1, C224.1, C225.1, C226.1, C227.1, C228.1, C229.1, C230.1, C231.1, C232.1, C233.1, C234.1, C235.1, C236.1, C237.1, C238.1, C239.1, C240.1, C241.1, C242.1, C243.1, LED201.3, LED202.3, LED203.3, LED204.3, LED205.3, LED206.3, LED207.3, LED208.3, LED209.3, LED210.3, LED211.3, LED212.3, LED213.3, LED214.3, LED215.3, LED216.3, LED217.3, LED218.3, LED219.3, LED220.3, LED221.3, LED222.3, LED223.3, LED224.3, LED225.3, LED226.3, LED227.3, LED228.3, LED229.3, LED230.3, LED231.3, LED232.3, LED233.3, R202.1, U202.6, U203.5
/right/OLED_SCL: J201.3, U201.6
/right/OLED_SDA: J201.4, U201.5
/right/ROW0: D201.1, D202.1, D203.1, D204.1, D205.1, D206.1, D207.1, U201.7
/right/ROW1: D208.1, D209.1, D210.1, D211.1, D212.1, D213.1, U201.8
/right/ROW2: D214.1, D215.1, D216.1, D217.1, D218.1, D219.1, D220.1, U201.9
/right/ROW3: D221.1, D222.1, D223.1, D224.1, D225.1, D226.1, D227.1, U201.10
/right/ROW4: D228.1, D229.1, D230.1, D231.1, D232.1, D233.1, D234.1, U201.11
/right/RST: SW291.1, U201.15
/right/VBAT: C203.1, L201.1, Q201.3, U201.13, U202.3
/right/VCC: J201.2, U201.16
