milindmadhukar/keygen/tools/gen_pcb.py

#!/usr/bin/env python3
"""Build pcb/keygen.kicad_pcb: place every footprint from the schematic's netlist, assign nets,
and draw each half's outline. Routing is not done here.

Key positions come from Redox's KLE layout (19.05 mm per unit). Per-key parts are placed
relative to each switch:  switch + socket (back), SK6812MINI-E under the switch's LED window
(back, south), 1N4148W (SOD-123) standing east of the switch (back). Everything else is placed by hand
below. Footprints keep their schematic link (path) so KiCad's "Update PCB from schematic"
still works after this script.
"""
import math, re, subprocess, sys, tempfile
from pathlib import Path

import pcbnew

sys.path.insert(0, str(Path(__file__).parent))
from sexp import find, first, parse
import gen_schematic as g

ROOT = Path(__file__).resolve().parent.parent
PCB = ROOT / "pcb"
U = 19.05
OFF = (26.0, 76.0)            # centres both halves on the A3 drawing sheet (mm)
MIRROR_X = 19.5 * U           # left x  <->  right x  (Redox is mirror-symmetric about 9.75u)

FP_DIRS = {
    "keygen": ROOT / "pcb/lib/keygen.pretty",
    "marbastlib-mx": ROOT / "lib/marbastlib/footprints/marbastlib-mx.pretty",
    "marbastlib-various": ROOT / "lib/marbastlib/footprints/marbastlib-various.pretty",
    "marbastlib-xp-promicroish": ROOT / "lib/marbastlib/footprints/marbastlib-xp-promicroish.pretty",
    "Keebio-Parts": ROOT / "lib/Keebio-Parts.pretty",
}

# --------------------------------------------------------------------------------------
# Redox KLE (img/redox-layout.json from mattdibi/redox-keyboard, MIT), legends stripped. The 2x2
# thumb block's tall keys are 1.25u (Redox: 1.5u), bottom edge unchanged, the 1u pair above them
# moved down to meet them. The right 1.25u thumb key is the exact mirror of the left one (Redox has it
# 1.9 mm off).
# --------------------------------------------------------------------------------------
KLE = [[{"x":3.5},"",{"x":10.5},""],[{"y":-0.875,"x":2.5},"",{"x":1},"",{"x":8.5},"",{"x":1},""],[{"y":-0.875,"x":5.5},"",{"x":6.5},""],[{"y":-0.875,"x":0.25,"w":1.25},"","",{"x":14.5},"",{"w":1.25},""],[{"y":-0.625,"x":6.5},"",{"x":4.5},""],[{"y":-0.75,"x":3.5},"",{"x":10.5},""],[{"y":-0.875,"x":2.5},"",{"x":1},"",{"x":8.5},"",{"x":1},""],[{"y":-0.875,"x":5.5},"",{"x":6.5},""],[{"y":-0.875,"x":0.25,"w":1.25},"","",{"x":14.5},"",{"w":1.25},""],[{"y":-0.625,"x":6.5,"h":1.5},"",{"x":4.5,"h":1.5},""],[{"y":-0.75,"x":3.5},"",{"x":10.5},""],[{"y":-0.875,"x":2.5},"",{"x":1},"",{"x":8.5},"",{"x":1},""],[{"y":-0.875,"x":5.5},"",{"x":6.5},""],[{"y":-0.875,"x":0.25,"w":1.25},"","",{"x":14.5},"",{"w":1.25},""],[{"y":-0.375,"x":3.5},"",{"x":10.5},""],[{"y":-0.875,"x":2.5},"",{"x":1},"",{"x":8.5},"",{"x":1},""],[{"y":-0.875,"x":5.5},"",{"x":6.5},""],[{"y":-0.875,"x":0.25,"w":1.25},"","",{"x":14.5},"",{"w":1.25},""],[{"y":-0.375,"x":3.5},"",{"x":10.5},""],[{"y":-0.875,"x":2.5},"",{"x":12.5},""],[{"y":-0.75,"x":0.5},"","",{"x":14.5},"",""],[{"r":15,"y":-2.625,"x":5.75,"w":1.25},""],[{"r":30,"rx":6.5,"ry":4.25,"y":-0.75},"",""],[{"h":1.25},"",{"h":1.25},""],[{"r":-30,"rx":13,"y":-0.75,"x":-2},"",""],[{"x":-2,"h":1.25},"",{"h":1.25},""],[{"r":-15,"rx":19.5,"ry":0,"y":2.75,"x":-7,"w":1.25},""]]

def parse_kle(rows):
    keys, c, cl = [], dict(x=0, y=0, w=1, h=1, r=0, rx=0, ry=0), dict(x=0, y=0)
    for row in rows:
        for it in row:
            if isinstance(it, dict):
                if "r" in it: c["r"] = it["r"]
                if "rx" in it: c["rx"] = cl["x"] = it["rx"]; c["x"], c["y"] = cl["x"], cl["y"]
                if "ry" in it: c["ry"] = cl["y"] = it["ry"]; c["x"], c["y"] = cl["x"], cl["y"]
                c["x"] += it.get("x", 0); c["y"] += it.get("y", 0)
                if "w" in it: c["w"] = it["w"]
                if "h" in it: c["h"] = it["h"]
            else:
                keys.append(dict(c)); c["x"] += c["w"]; c["w"] = c["h"] = 1
        c["y"] += 1; c["x"] = c["rx"]
    return keys

# KLE index -> (side, row, col) of the matrix in gen_schematic.KEYS. Indices 12, 13, 26, 27 are
# Redox's inner column, removed in Keygen.
KLE_MAP = {
    8: ("left", 0, 0), 9: ("left", 0, 1), 2: ("left", 0, 2), 0: ("left", 0, 3), 3: ("left", 0, 4), 6: ("left", 0, 5),
    22: ("left", 1, 0), 23: ("left", 1, 1), 16: ("left", 1, 2), 14: ("left", 1, 3), 17: ("left", 1, 4), 20: ("left", 1, 5),
    36: ("left", 2, 0), 37: ("left", 2, 1), 30: ("left", 2, 2), 28: ("left", 2, 3), 31: ("left", 2, 4), 34: ("left", 2, 5),
    48: ("left", 3, 0), 49: ("left", 3, 1), 42: ("left", 3, 2), 40: ("left", 3, 3), 43: ("left", 3, 4), 46: ("left", 3, 5),
    56: ("left", 4, 0), 57: ("left", 4, 1), 54: ("left", 4, 2), 52: ("left", 4, 3), 60: ("left", 4, 4),
    63: ("left", 4, 5), 64: ("left", 4, 6), 61: ("left", 3, 6), 62: ("left", 2, 6),
    11: ("right", 0, 0), 10: ("right", 0, 1), 5: ("right", 0, 2), 1: ("right", 0, 3), 4: ("right", 0, 4), 7: ("right", 0, 5),
    25: ("right", 1, 0), 24: ("right", 1, 1), 19: ("right", 1, 2), 15: ("right", 1, 3), 18: ("right", 1, 4), 21: ("right", 1, 5),
    39: ("right", 2, 0), 38: ("right", 2, 1), 33: ("right", 2, 2), 29: ("right", 2, 3), 32: ("right", 2, 4), 35: ("right", 2, 5),
    51: ("right", 3, 0), 50: ("right", 3, 1), 45: ("right", 3, 2), 41: ("right", 3, 3), 44: ("right", 3, 4), 47: ("right", 3, 5),
    59: ("right", 4, 0), 58: ("right", 4, 1), 55: ("right", 4, 2), 53: ("right", 4, 3), 69: ("right", 4, 4),
    68: ("right", 4, 5), 67: ("right", 4, 6), 66: ("right", 3, 6), 65: ("right", 2, 6),
}

def key_geometry():
    """(side, row, col) -> (cx_mm, cy_mm, rot_cw_deg, w_u, h_u, corners_mm)"""
    out = {}
    for i, k in enumerate(parse_kle(KLE)):
        if i not in KLE_MAP: continue
        a = math.radians(k["r"])
        def tf(x, y):
            dx, dy = x - k["rx"], y - k["ry"]
            return ((k["rx"] + dx * math.cos(a) - dy * math.sin(a)) * U, (k["ry"] + dx * math.sin(a) + dy * math.cos(a)) * U)
        cx, cy = tf(k["x"] + k["w"] / 2, k["y"] + k["h"] / 2)
        corners = [tf(k["x"], k["y"]), tf(k["x"] + k["w"], k["y"]), tf(k["x"] + k["w"], k["y"] + k["h"]), tf(k["x"], k["y"] + k["h"])]
        out[KLE_MAP[i]] = (cx, cy, k["r"], k["w"], k["h"], corners)
    return out

def rot(v, deg):
    a = math.radians(deg)
    return (v[0] * math.cos(a) - v[1] * math.sin(a), v[0] * math.sin(a) + v[1] * math.cos(a))

# --------------------------------------------------------------------------------------
# Netlist from the schematic
# --------------------------------------------------------------------------------------
def read_netlist():
    sch = PCB / "keygen.kicad_sch"
    with tempfile.TemporaryDirectory() as d:
        out = Path(d) / "n.net"
        subprocess.run(["kicad-cli", "sch", "export", "netlist", "--format", "kicadsexpr", "-o", str(out), str(sch)],
                       check=True, capture_output=True)
        tree = parse(out.read_text())
    comps = {}
    for c in find(first(tree, "components"), "comp"):
        ref = first(c, "ref")[1]
        sp = first(c, "sheetpath")
        comps[ref] = dict(value=first(c, "value")[1], footprint=first(c, "footprint")[1],
                          path=first(sp, "tstamps")[1] + first(c, "tstamps")[1], pins={})
    for n in find(first(tree, "nets"), "net"):
        name = first(n, "name")[1]
        for node in find(n, "node"):
            ref, pin = first(node, "ref")[1], first(node, "pin")[1]
            if ref in comps: comps[ref]["pins"][pin] = name
    return comps

# --------------------------------------------------------------------------------------
# Board building
# --------------------------------------------------------------------------------------
def mm(x, y): return pcbnew.VECTOR2I(pcbnew.FromMM(x + OFF[0]), pcbnew.FromMM(y + OFF[1]))

class Board:
    def __init__(self, comps):
        self.b = pcbnew.CreateEmptyBoard()
        self.comps, self.nets, self.placed = comps, {}, set()
        ds = self.b.GetDesignSettings()
        ds.m_TrackMinWidth = pcbnew.FromMM(0.2)
        ds.m_MinClearance = pcbnew.FromMM(0.2)
        ds.m_ViasMinSize = pcbnew.FromMM(0.6)
        ds.m_MinThroughDrill = pcbnew.FromMM(0.3)
        # Reverse-mount SK6812MINI-E pads sit ~0.29 mm from their own light cut-out.
        ds.m_CopperEdgeClearance = pcbnew.FromMM(0.25)

    def net(self, name):
        if name not in self.nets:
            ni = pcbnew.NETINFO_ITEM(self.b, name); self.b.Add(ni); self.nets[name] = ni
        return self.nets[name]

    def place(self, ref, x, y, rot_cw=0.0, back=False, extra=0.0):
        """Put ref's footprint with its origin at (x, y) mm. rot_cw: clockwise degrees (KLE sense).
        extra: additional rotation for parts whose own drawing needs turning."""
        c = self.comps[ref]
        lib, name = c["footprint"].split(":", 1)
        d = FP_DIRS.get(lib, Path(f"/usr/share/kicad/footprints/{lib}.pretty"))
        fp = pcbnew.FootprintLoad(str(d), name)
        if fp is None: raise RuntimeError(f"{ref}: footprint {c['footprint']} not found")
        fp.SetFPID(pcbnew.LIB_ID(lib, name))
        fp.SetReference(ref); fp.SetValue(c["value"])
        fp.SetPath(pcbnew.KIID_PATH(c["path"]))
        self.b.Add(fp)
        pos = mm(x, y)
        fp.SetPosition(pos)
        if back:
            fp.SetOrientationDegrees(rot_cw + extra)
            fp.Flip(pos, pcbnew.FLIP_DIRECTION_LEFT_RIGHT)
        else:
            fp.SetOrientationDegrees(-(rot_cw + extra))
        for p in fp.Pads():
            n = c["pins"].get(p.GetNumber())
            if n: p.SetNet(self.net(n))
        if re.match(r"(SW|D|LED)\d+$", ref) and not ref.startswith(("SW19", "SW29")):
            fp.Reference().SetVisible(False)      # 200+ labels would only clutter the silkscreen
        self.placed.add(ref)
        return fp

    def outline(self, pts):
        hull = convex_hull(pts)
        for a, b in zip(hull, hull[1:] + hull[:1]):
            s = pcbnew.PCB_SHAPE(self.b); s.SetShape(pcbnew.SHAPE_T_SEGMENT)
            s.SetStart(mm(*a)); s.SetEnd(mm(*b)); s.SetLayer(pcbnew.Edge_Cuts); s.SetWidth(pcbnew.FromMM(0.1))
            self.b.Add(s)

HOLES_PER_HALF = 5
HOLE_KEEPOUT = 3.5      # mm from hole centre to any pad, hole or LED cut-out
EDGE_KEEPOUT = 4.0      # mm from hole centre to the board edge
# The inner top holes move below the reset switches to clear the OLED modules when those modules
# move 3 mm away from the keycaps. Coordinates are in the KLE frame, before OFF is added.
OLED_SIDE_HOLE = (183.0 - OFF[0], 127.0 - OFF[1])
HOLE_OVERRIDES = {
    "left": {3: OLED_SIDE_HOLE},
    "right": {2: (MIRROR_X - OLED_SIDE_HOLE[0], OLED_SIDE_HOLE[1])},
}

def _mounting_holes(self, hull, side):
    """Pick M2 hole spots where nothing else is, spread across the half (farthest-point)."""
    obst, switches, boxes = [], [], []
    for fp in self.b.GetFootprints():
        ref = fp.GetReference()
        for p in fp.Pads():
            q = p.GetPosition(); s = p.GetSize()
            obst.append((pcbnew.ToMM(q.x) - OFF[0], pcbnew.ToMM(q.y) - OFF[1], max(pcbnew.ToMM(s.x), pcbnew.ToMM(s.y)) / 2))
        if ref.startswith("LED"):          # light cut-out
            q = fp.GetPosition(); obst.append((pcbnew.ToMM(q.x) - OFF[0], pcbnew.ToMM(q.y) - OFF[1], 2.0))
        if re.match(r"SW\d+$", ref) and int(ref[2:]) % 100 < 90:   # key switches: 14 mm body + screw head
            q = fp.GetPosition()
            switches.append((pcbnew.ToMM(q.x) - OFF[0], pcbnew.ToMM(q.y) - OFF[1], fp.GetOrientationDegrees()))
        elif not re.match(r"(D|LED|H)\d+$", ref):                    # controller, jack, encoder, ...
            bb = fp.GetBoundingBox(False)
            boxes.append((pcbnew.ToMM(bb.GetLeft()) - OFF[0], pcbnew.ToMM(bb.GetTop()) - OFF[1],
                          pcbnew.ToMM(bb.GetRight()) - OFF[0], pcbnew.ToMM(bb.GetBottom()) - OFF[1]))
    def clear_of_switches(x, y):
        for sx, sy, o in switches:
            dx, dy = rot((x - sx, y - sy), o)      # into the switch's own frame (either sign works: square)
            if max(abs(dx), abs(dy)) < 9.4: return False
        return True
    def clear_of_boxes(x, y):
        return all(not (l - 2.5 < x < r + 2.5 and t - 2.5 < y < b + 2.5) for l, t, r, b in boxes)
    def edge_dist(x, y):
        best = 1e9
        for (ax, ay), (bx, by) in zip(hull, hull[1:] + hull[:1]):
            vx, vy = bx - ax, by - ay; t = max(0, min(1, ((x - ax) * vx + (y - ay) * vy) / (vx * vx + vy * vy)))
            best = min(best, math.hypot(x - ax - t * vx, y - ay - t * vy))
        return best
    def inside(x, y):
        return all((bx - ax) * (y - ay) - (by - ay) * (x - ax) >= 0 for (ax, ay), (bx, by) in zip(hull, hull[1:] + hull[:1]))
    xs = [p[0] for p in hull]; ys = [p[1] for p in hull]
    cands = []
    y = min(ys)
    while y < max(ys):
        x = min(xs)
        while x < max(xs):
            if inside(x, y) and edge_dist(x, y) >= EDGE_KEEPOUT and \
               all(math.hypot(x - ox, y - oy) >= HOLE_KEEPOUT + r for ox, oy, r in obst) and \
               clear_of_switches(x, y) and clear_of_boxes(x, y):
                cands.append((x, y))
            x += 0.5
        y += 0.5
    if not cands: raise RuntimeError(f"{side}: no room for mounting holes")
    cx, cy = sum(xs) / len(xs), sum(ys) / len(ys)
    chosen = [min(cands, key=lambda p: math.hypot(p[0] - cx, p[1] - cy))]
    while len(chosen) < HOLES_PER_HALF:
        chosen.append(max(cands, key=lambda p: min(math.hypot(p[0] - q[0], p[1] - q[1]) for q in chosen)))
    for i, (x, y) in enumerate(chosen, 1):
        x, y = HOLE_OVERRIDES.get(side, {}).get(i, (x, y))
        if not (inside(x, y) and edge_dist(x, y) >= EDGE_KEEPOUT and
                all(math.hypot(x - ox, y - oy) >= HOLE_KEEPOUT + r for ox, oy, r in obst) and
                clear_of_switches(x, y) and clear_of_boxes(x, y)):
            raise RuntimeError(f"{side}: fixed mounting hole H{(100 if side == 'left' else 200) + i} is obstructed")
        fp = pcbnew.FootprintLoad("/usr/share/kicad/footprints/MountingHole.pretty", "MountingHole_2.2mm_M2")
        fp.SetFPID(pcbnew.LIB_ID("MountingHole", "MountingHole_2.2mm_M2"))
        ref = f"H{(100 if side == 'left' else 200) + i}"
        fp.SetReference(ref); fp.SetValue("M2")
        if ref in self.comps:
            fp.SetPath(pcbnew.KIID_PATH(self.comps[ref]["path"]))
        self.placed.add(ref)
        fp.SetPosition(mm(x, y)); self.b.Add(fp)
    print(f"{side}: mounting holes at " + ", ".join(f"({x:.1f},{y:.1f})" for x, y in chosen))

Board.mounting_holes = _mounting_holes

def convex_hull(pts):
    pts = sorted(set((round(x, 4), round(y, 4)) for x, y in pts))
    cross = lambda o, a, b: (a[0] - o[0]) * (b[1] - o[1]) - (a[1] - o[1]) * (b[0] - o[0])
    lo, up = [], []
    for p in pts:
        while len(lo) >= 2 and cross(lo[-2], lo[-1], p) <= 0: lo.pop()
        lo.append(p)
    for p in reversed(pts):
        while len(up) >= 2 and cross(up[-2], up[-1], p) <= 0: up.pop()
        up.append(p)
    return lo[:-1] + up[:-1]

def grow(corners, cx, cy, d):
    """Push polygon corners outward from (cx, cy) by d mm."""
    out = []
    for x, y in corners:
        vx, vy = x - cx, y - cy; L = math.hypot(vx, vy)
        out.append((x + vx / L * d, y + vy / L * d))
    return out

# --------------------------------------------------------------------------------------
# Placement
# --------------------------------------------------------------------------------------
LED_OFFSET = (0.0, 5.08)          # SK6812MINI-E under the MX LED window (south of centre)
DIODE_AT = (8.3, 2.79)            # 1N4148W centre, on the back: cathode south, anode north, so nothing
                                  # reaches the front, where the Poron switch pads lie

# Non-key parts on the LEFT half (mm, KLE frame). The right half mirrors these about MIRROR_X.
TOP_EDGE = 0.25 * U               # top of the number-row key next to the controller ("5")
MCU_X = 7.0 * U                   # centre of Redox's removed inner column
# Keys are references without the half's 100/200 base; rot is clockwise degrees.
LEFT_PARTS = {
    "U1":  dict(x=MCU_X, y=TOP_EDGE + 16.65 - 1.0, back=True),     # USB-C overhangs the edge by 1 mm
    # power slide switch: its pin row 2.2 mm in from the sloped top edge, so the body's front face meets
    # the edge at its middle and the knob reaches 4 mm past it; its outer tab hole is 1.7 mm off the side edge
    "SW90": dict(x=MCU_X + 20.5, y=TOP_EDGE + 1.8, back=True),
    "BT1": dict(x=MCU_X + 9.0 + 5.5, y=TOP_EDGE + 23.0, back=True),          # JST-PH battery
    # battery load switch: P-MOSFET and its gate resistor, between the controller and the slide switch
    "Q1":  dict(x=MCU_X + 12.25, y=TOP_EDGE + 8.0, back=True),
    "R1":  dict(x=MCU_X + 12.25, y=TOP_EDGE + 13.5, back=True),
    # the LED boost's enable pull-down: below the boost on the left, above it on the right, where
    # that half's boost group is turned half a turn (right= gives the right half's own position)
    "R3":  dict(x=MCU_X + 21.25, y=TOP_EDGE + 29.5, back=True, rot=270, right=dict(x=215.0, y=12.4, rot=0)),
    # reset: x is the body's centre, so the two halves' buttons mirror; its origin (pad 1) sits
    # 3.25 mm off the centre, toward +x on both halves once flipped to the back
    "SW91": dict(x=MCU_X + 20.25, y=TOP_EDGE + 36.0, back=True, body_dx=-3.25),
}
# The LED boost (U2, TPS61023) and its parts, between the battery connector and the board edge.
# Offsets from U2 in mm; the layout follows the datasheet's example (section 10.2): the inductor
# beside the IC with the SW trace between its pin rows, the output capacitors across VOUT and GND,
# the input capacitor across VIN and GND. U2's pinout isn't symmetric, so the right half turns the
# whole group half a turn instead of mirroring it, and sits higher, clear of its battery connector.
BOOST = [   # (ref, dx, dy, rot)
    ("U2", 0.0, 0.0, 90), ("L1", -2.6, 0.0, 90),
    ("C1", -0.9, -3.65, 0), ("C4", -0.9, -6.05, 0),       # 2 x 22 uF at VOUT
    ("C3", -0.9, 3.6, 180),                                # 10 uF at VIN
    ("R2", 2.75, -2.3, 270), ("R4", 2.75, 2.6, 270),       # feedback divider
]
BOOST_AT = {"left": (155.4, 23.5), "right": (216.3, 18.6)}  # U2, KLE frame (board mm minus OFF)
# The 100 nF beside each LED (C111-C143, C211-C243): (x, y) in the key's frame from the switch
# centre, and its turn relative to the key. Each spot is clear of the routed copper, within reach of
# the LED rail and as close to its LED's VDD pad as the board allows, with room for an iron: 0.5 mm
# to other parts' pads, 1 mm to through-hole and hotswap pads.
LED_CAPS = {
    "left": {1: (-4.75, 6.83, 270), 2: (-4.75, 7.58, 270), 3: (-4.75, 3.08, 90), 4: (-5.75, 4.83, 0), 5: (-3.75, 2.08, 0),
             6: (-7.0, 5.08, 0), 7: (-4.5, 2.08, 0), 8: (-4.75, 2.83, 90), 9: (-4.75, 3.83, 90), 10: (-3.75, 2.08, 0),
             11: (-5.25, 8.58, 270), 12: (-3.25, 9.58, 180), 13: (-4.75, 3.58, 90), 14: (-3.75, 2.08, 0),
             15: (-4.75, 6.58, 270), 16: (-5, 2.83, 90), 17: (3.75, 2.08, 180), 18: (-4.75, 2.83, 90),
             19: (-4.75, 3.33, 90), 20: (-5, 2.83, 90), 21: (4.5, 2.08, 180), 22: (-4.75, 6.58, 270),
             23: (-5, 7.33, 270), 24: (-4.75, 3.83, 90), 25: (-3.75, 2.08, 0), 26: (-4.75, 3.58, 90),
             27: (-3.75, 2.08, 0), 28: (-4.75, 2.83, 90), 29: (-4.75, 3.33, 90), 30: (-5.75, 2.83, 0),
             31: (-5.75, 3.33, 0), 32: (-4.75, 5.83, 270), 33: (-4.75, 3.33, 90)},
    "right": {1: (-4.75, 4.08, 90), 2: (-4.75, 2.83, 90), 3: (-4.75, 2.83, 90), 4: (-3, 8.83, 270), 5: (-4.0, 2.08, 180),
              6: (-5.25, 4.33, 90), 7: (-4.5, 2.08, 0), 8: (-5.25, 5.33, 270), 9: (-3.75, 2.08, 0),
              10: (-4.75, 2.83, 90), 11: (-4.5, 2.08, 0), 12: (-4.25, 2.08, 0), 13: (-4.5, 2.08, 0),
              14: (-5.75, 5.08, 0), 15: (-4.75, 3.08, 90), 16: (-4.75, 2.83, 90), 17: (-5.25, 3.33, 90),
              18: (-1, 9.58, 270), 19: (-4.75, 4.08, 90), 20: (-2.75, 8.08, 180), 21: (-4.5, 2.08, 0),
              22: (-4.75, 5.83, 270), 23: (-4, 2.08, 0), 24: (-6, 5.08, 270), 25: (-4.75, 3.58, 90),
              26: (-4.75, 3.83, 90), 27: (-5.25, 4.08, 270), 28: (-5.75, 6.33, 0), 29: (-5.75, 3.58, 0),
              30: (-4.75, 2.83, 90), 31: (-4.75, 3.08, 90), 32: (-4.75, 5.33, 270), 33: (-4.75, 5.33, 270)},
}
# The LED data buffer (U3), its 100 nF (C2) and the data resistor (R5), beside the first LED: the
# controller's 3.3 V data crosses the board as before and the buffer drives the first LED's DIN at
# 5 V from a few millimetres away. U3 keeps 1 mm clear of every other pad and 0.5 mm of every other
# courtyard, so an iron reaches its pins. (x, y, rot), KLE frame.
BUFFER = {
    "left": {"U3": (23.6438, 22.9987, 270), "C2": (24.4438, 26.8487, 180), "R5": (20.3438, 25.5987, 90)},
    "right": {"U3": (361.0313, 24.7487, 90), "C2": (361.7313, 19.3987, 90), "R5": (356.8313, 25.8987, 0)},
}
LED_BULK = {"left": (-8.25, 4.33, 0), "right": (-6.25, 2.08, 0)}   # C5, 10 uF, in the last LED's key frame
BAT_PLUS = (3.5, 0.0)                        # "+" beside the battery connector's pad 1, outside its outline
# Encoders: one per half, mirrored. The right half's shaft, on the front below the controller and its
# OLED: a 17 mm knob clears the OLED by 10 mm, the thumb cluster's top keycap by 5.7 mm and H by 9.1 mm.
ENCODER_SHAFT = (230.5, 58.5)
ENC_DIODE = (11.0, -11.0)         # its diode on the back, from the shaft (right half): its centre, anode north
ENC_OPENING = (18.0, 20.0)        # the PCB's opening round the encoder, which is fixed to the top frame
ENC_HEADER = (-19.225, 20.5)      # 1x5 right-angle header on the back, its outer pin from the shaft (right half),
                                  # pins pointing north on both halves, so the jumper plug lies flat beside the opening
# OLED: a 0.96 in. module (27.5 x 28 mm) over the controller's lower end, its header along its bottom
# edge so the text reads upside down (turned in firmware). Right half: module centre, and pin 1 (GND)
# relative to it. Pins run toward -x on both halves, since the modules themselves don't mirror.
OLED_CENTRE = (229.75, 26.0)  # 3 mm toward each half's inner edge, away from the nearest keycaps
OLED_PIN1 = (3.81, 12.7)
OLED_PIN_TURN = 90                # turns the 1x4 header so its pins run from pin 1 toward -x


OLED_MODEL = "${KIPRJMOD}/lib/keygen.3dshapes/OLED_096_I2C.step"   # tools/gen_models.py


def oled_model(fp):
    """Add the OLED module's 3D model to its 1x4 footprint, and hide the footprint's stock pin header:
    the module sits in the top frame, plugged into a right-angle header in these four holes."""
    for m in fp.Models():
        if "PinHeader" in m.m_Filename: m.m_Show = False
    if any(m.m_Filename == OLED_MODEL for m in fp.Models()): return
    m = pcbnew.FP_3DMODEL(); m.m_Filename = OLED_MODEL
    fp.Models().push_back(m)


def battery_plus(b):
    """Mark the battery connector's + pad (pad 1) on the back silkscreen. A reversed pack destroys
    the charger. Skips a mark that's already there, so it can run on a routed board."""
    for ref in ("BT101", "BT201"):
        fp = b.FindFootprintByReference(ref)
        if fp is None: continue
        c = next(p for p in fp.Pads() if p.GetNumber() == "1").GetPosition()
        pos = pcbnew.VECTOR2I(c.x + pcbnew.FromMM(BAT_PLUS[0]), c.y + pcbnew.FromMM(BAT_PLUS[1]))
        if any(isinstance(d, pcbnew.PCB_TEXT) and d.GetText() == "+" and d.GetPosition() == pos for d in b.GetDrawings()):
            continue
        t = pcbnew.PCB_TEXT(b)
        t.SetText("+"); t.SetLayer(pcbnew.B_SilkS); t.SetPosition(pos); t.SetMirrored(True)
        t.SetTextSize(pcbnew.VECTOR2I(pcbnew.FromMM(1.2), pcbnew.FromMM(1.2))); t.SetTextThickness(pcbnew.FromMM(0.2))
        b.Add(t)


def build():
    comps = read_netlist()
    B = Board(comps)
    geo = key_geometry()
    for side in ("left", "right"):
        base = g.BASE[side]
        keys = g.KEYS[side]
        enc = g.ENCODER_POS.get(side)
        cells = sorted([(r, c, lab, w) for r, c, lab, w in keys] + ([(enc[0], enc[1], "enc", None)] if enc else []))
        num = {(r, c): n for n, (r, c, lab, w) in enumerate(cells, 1)}
        outline_pts = []
        for (r, c) in [(r, c) for r, c, *_ in keys]:
            cx, cy, rr, w, h, corners = geo[(side, r, c)]
            n = num[(r, c)]
            # The big thumb keys are tall (1 x 1.25u): turn the 1.25u footprint, its keycap
            # and the LED/diode pattern a quarter turn so they follow the key.
            ro = rr + (90 if h > w else 0)
            span = max(w, h)
            B.place(f"SW{base+n}", cx, cy, ro, back=True)
            lx, ly = rot(LED_OFFSET, ro)
            li = [i for i, k in enumerate(keys) if (k[0], k[1]) == (r, c)][0]
            B.place(f"LED{base+li+1}", cx + lx, cy + ly, ro, back=True)
            kx, ky, rel = LED_CAPS[side][li + 1]
            px, py = rot((kx, ky), ro)
            cap = B.place(f"C{base + g.LED_CAP_BASE + li + 1}", cx + px, cy + py, ro + rel, back=True)
            cap.Reference().SetVisible(False)      # 33 more labels would only clutter the silkscreen
            cap.SetDNP(not g.led_cap_fitted(li + 1))
            if li == len(keys) - 1:
                kx, ky, rel = LED_BULK[side]
                px, py = rot((kx, ky), ro)
                B.place(f"C{base + 5}", cx + px, cy + py, ro + rel, back=True)
            east = (span * U / 2 - 1.225, DIODE_AT[1]) if span > 1 else DIODE_AT
            dx, dy = rot(east, ro)
            B.place(f"D{base+n}", cx + dx, cy + dy, ro, back=True, extra=90)
            outline_pts += grow(corners, cx, cy, 0.6)
        # right-half positions, mirrored for the left
        rmir = (lambda x: x) if side == "right" else (lambda x: MIRROR_X - x)
        sx, sy = rmir(ENCODER_SHAFT[0]), ENCODER_SHAFT[1]
        sgn = 1 if side == "right" else -1
        if enc:
            # encoder diode: beside the encoder's switch pins
            B.place(f"D{base+num[enc]}", sx + sgn * ENC_DIODE[0], sy + ENC_DIODE[1], 0, back=True, extra=90)
        # controller and friends
        mir = (lambda x: MIRROR_X - x) if side == "right" else (lambda x: x)
        for key, p in LEFT_PARTS.items():
            prefix, n = re.match(r"([A-Z]+)(\d+)$", key).groups()
            if side == "right" and "right" in p:
                q = p["right"]; B.place(f"{prefix}{base + int(n)}", q["x"], q["y"], q["rot"], back=p["back"]); continue
            B.place(f"{prefix}{base + int(n)}", mir(p["x"]) - p.get("body_dx", 0), p["y"], p.get("rot", 0), back=p["back"])
        ax, ay = BOOST_AT[side]
        for ref, dx, dy, r in BOOST:
            if side == "right": dx, dy, r = -dx, -dy, r + 180
            prefix, n = re.match(r"([A-Z]+)(\d+)$", ref).groups()
            B.place(f"{prefix}{base + int(n)}", ax + dx, ay + dy, r, back=True)
        for ref, (x, y, r) in BUFFER[side].items():
            prefix, n = re.match(r"([A-Z]+)(\d+)$", ref).groups()
            B.place(f"{prefix}{base + int(n)}", x, y, r, back=True)
        if enc:
            hx, hy = ENC_HEADER
            B.place(f"J{base+2}", sx + hx + 4 * 2.54 if side == "right" else sx - hx, sy + hy, 90,
                    back=True).Reference().SetVisible(False)      # its label would sit over the opening
            fp = pcbnew.FootprintLoad(str(FP_DIRS["keygen"]), "EC11_Case_Mount")   # off the netlist: no pads
            fp.SetFPID(pcbnew.LIB_ID("keygen", "EC11_Case_Mount"))
            fp.SetReference(f"ENC{base+1}"); fp.SetValue("EC11"); fp.SetPosition(mm(sx, sy)); B.b.Add(fp)
        ox, oy = rmir(OLED_CENTRE[0]), OLED_CENTRE[1]
        oled_model(B.place(f"J{base+1}", ox + OLED_PIN1[0], oy + OLED_PIN1[1], 0, back=False, extra=OLED_PIN_TURN))
        # outline: keys + controller ear
        ear_x0, ear_x1 = mir(MCU_X - 9.5), mir(MCU_X + 9.0 + 1.2 + 6.1 + 1.5 + 7.4 + 1.0)
        ear_y1 = TOP_EDGE + 16.65 * 2 + 15.0
        outline_pts += [(ear_x0, TOP_EDGE), (ear_x1, TOP_EDGE), (ear_x1, ear_y1), (ear_x0, ear_y1)]
        if enc:
            outline_pts += [(sx - 10, sy + 9), (sx + 10, sy + 9)]
        B.outline(outline_pts)
        if enc:
            w, h = ENC_OPENING
            corners = [(sx-w/2, sy-h/2), (sx+w/2, sy-h/2),
                       (sx+w/2, sy+h/2), (sx-w/2, sy+h/2)]
            for a, b in zip(corners, corners[1:] + corners[:1]):
                edge = pcbnew.PCB_SHAPE(B.b)
                edge.SetShape(pcbnew.SHAPE_T_SEGMENT)
                edge.SetStart(mm(*a)); edge.SetEnd(mm(*b))
                edge.SetLayer(pcbnew.Edge_Cuts); edge.SetWidth(pcbnew.FromMM(0.1))
                B.b.Add(edge)
        B.mounting_holes(convex_hull(outline_pts), side)

    battery_plus(B.b)
    missing = set(comps) - B.placed - {r for r in comps if r.startswith("#")}
    if missing: raise RuntimeError(f"not placed: {sorted(missing)}")
    path = PCB / "keygen.kicad_pcb"
    tb = B.b.GetTitleBlock()
    tb.SetTitle("Keygen"); tb.SetRevision("0.1"); tb.SetDate("2026-10-20"); tb.SetCompany("github.com/milindmadhukar/keygen")
    tb.SetComment(0, "Left half (refs 1xx) and right half (refs 2xx); generated by tools/gen_pcb.py")
    B.b.SetFileName(str(path))
    pcbnew.SaveBoard(str(path), B.b)
    # PAGE_INFO isn't exposed to Python: set the drawing sheet in the file (both halves fit on A3)
    path.write_text(re.sub(r'\(paper "[^"]*"\)', '(paper "A3")', path.read_text(), count=1))
    set_project_rules()
    print(f"placed {len(B.placed)} footprints, {len(B.nets)} nets -> {path.relative_to(ROOT)}")


RULES = {                       # Lion Circuits: 6/6 mil on 1 oz copper; we keep some margin
    "min_clearance": 0.2, "min_track_width": 0.15, "min_via_diameter": 0.6, "min_via_annular_width": 0.13,
    "min_through_hole_diameter": 0.3, "min_hole_clearance": 0.25, "min_hole_to_hole": 0.25,
    "min_copper_edge_clearance": 0.2,    # reverse-mount LED pads sit 0.247 mm from their own cut-out corners
    "min_silk_clearance": 0.0,
}

def set_project_rules():
    import json
    pro = PCB / "keygen.kicad_pro"
    d = json.loads(pro.read_text())
    d.setdefault("board", {}).setdefault("design_settings", {}).setdefault("rules", {}).update(RULES)
    pro.write_text(json.dumps(d, indent=2) + "\n")


if __name__ == "__main__":
    build()
