milindmadhukar/keygen/(commit log)

2026-10-19 Finalise layout: drop trackpad and screen, hide controllers, HJKL arrows
    Remove the Redox inner column (66 keys) and move [ ] to the right bottom row.
    Put a single EC11 knob in the freed right inner column, mount both nRF52840s
    on the PCB underside with USB-C through the case, and show status through
    per-key RGB instead of an OLED.
2026-10-19 Add BOM with Indian sources; power LEDs from switched VCC
    bom/bom.csv is the source; tools/render_bom.py renders plan/bom.html and
    the vault BOM note. Drop the external LED MOSFET in favour of the
    nRF52840 board's switched VCC, move fabrication to Lion Circuits, and
    target KiCad 10.
2026-10-19 Generate left and right schematics for KiCad 10
    tools/gen_schematic.py builds both halves from one key table: the 5x7
    COL2ROW matrix with 1N4148 diodes, the SK6812MINI-E chain on the
    controller's switched VCC, the nRF52840 Pro Micro, battery, MSK12C02
    power switch, reset, TRRS and (right) the EC11 encoder.
    tools/check_schematic.py runs ERC and checks KiCad's netlist against the
    tables; both halves pass with zero violations. Footprints come from KiCad
    stock libraries plus marbastlib and Keebio-Parts, added as submodules.
2026-10-19 Merge both halves into one KiCad project
    pcb/keygen.kicad_pro holds a top sheet with left and right sub-sheets
    (refs 1xx/2xx, sheet-local nets) and will carry one PCB with both halves
    joined by snap-off tabs. The board stays non-reversible. The checker now
    runs ERC on the whole project and splits the netlist per half.
2026-10-19 Place all footprints on the PCB
    tools/gen_pcb.py builds pcb/keygen.kicad_pcb from the schematic netlist:
    switches and Kailh sockets on the back at Redox's KLE positions, an
    SK6812MINI-E under each switch's LED window, a 1N4148 beside each switch,
    six underglow LEDs in key gaps, the controller under the old inner column
    with USB-C at the top edge, TRRS, power switch, battery JST and reset in
    the corner beside it, and the right-hand encoder below its controller.
    Each half gets a convex outline and five M2 holes placed clear of every
    switch body and part. Design rules go into the project file. DRC: no
    errors; routing is next.
2026-10-19 Mark switch bodies on the front silkscreen
    pcb/lib/keygen.pretty holds marbastlib's MX hotswap footprints with a
    14 mm switch outline on B.SilkS, which lands on the front because the
    footprints are placed flipped. Keeping it in a project library (instead
    of editing placed footprints) avoids library-mismatch warnings and keeps
    'update footprints from library' safe.
2026-10-19 Show switches, keycaps and parts in KiCad's 3D view
    Project copies of the vendored footprints point their 3D models inside
    the repo. The hotswap footprints add a kiswitch MX switch and a generated
    keycap, turned over so they stand on the front of a back-mounted part.
    The controller gets a simple generated block. The encoder moves to
    marbastlib's EC11 footprint (origin at the shaft) because KiCad's
    encoder model isn't in the 3D package. Renders in docs/.
2026-10-19 Stop tracking KiCad's local history folder
    pcb/.history is KiCad 10's per-machine local-history repository; it was
    picked up by the previous commit as an embedded repo.
2026-10-19 Turn the tall thumb keys and put both halves on an A3 sheet
    Redox's big thumb keys are 1 x 1.5u (tall), so their 1.5u footprints,
    keycaps and LED/diode patterns rotate a quarter turn. The board moves to
    the centre of an A3 drawing sheet with a filled title block (PAGE_INFO
    isn't exposed to Python, so the generator sets the paper size in the
    saved file). Also adds tools/route_pcb.py (Freerouting) for the next
    step.
2026-10-19 Add case_refs.py and an import-only path to the router
    case_refs.py writes the PCB positions the case and plate depend on
    (controller, TRRS, power switch, reset, battery JST, encoder, M2 holes)
    into the vault note '14 - case & plate requirements'. route_pcb.py:
    GetBoardPolygonOutlines now needs its infer flag, and --import-only
    reuses the last Freerouting session.
2026-10-20 Route the PCB: DRC clean with schematic parity
    Freerouting routes ~85% of signals with ground left to the pour; a grid
    maze router (finish_route.py) completes the rest and ties stranded
    ground pads to vias. Ground is poured on both layers per half with
    stitching vias, islands removed and an antenna keep-out under each
    controller. sync_pcb.py relinks footprints to the schematic; schematic
    UUIDs are now deterministic so regenerating keeps those links, and the
    generator no longer overwrites the project's design rules. Mounting
    holes are in the schematic. Result: 0 unconnected, 0 errors, 0 parity
    issues (28 silkscreen warnings remain).
2026-10-20 Export manufacturing files for a bare-board order
    fab/keygen-gerbers.zip holds both halves in one upload; per-half zips
    are fallbacks if the fab won't take two outlines in one design.
    ORDER.md lists the order-form settings (2 layers, 1.6 mm, HASL, no
    assembly) and the LED cut-out note for the fab's DFM check. Hole and
    cap labels are hidden to clear the remaining silkscreen overlaps.
2026-10-20 Recommend per-half PCB orders
    Per half came out cheaper at Lion Circuits than the combined file, so
    ORDER.md, the README and the vault note now point to the left/right
    zips; the combined zip stays for other fabs.
2026-10-20 Add assembly BOMs generated from the schematic
    fab/BOM-left.csv and fab/BOM-right.csv list every part type with its
    references, quantity, value and footprint; fab/BOM.md has the same as
    tables with soldering notes and totals for one and two keyboards, with
    where-to-buy taken from bom/bom.csv.
2026-10-20 Add a 1:1 A4 print of the switch plate
    tools/plate_print.py writes docs/plate-print.pdf from the current PCB: one
    half per A4 page with the plate outline, 14 mm switch cut-outs, keycap
    footprints and legends, M2 holes, the encoder cut-out and knob, and a
    100 mm ruler for checking the print scale.
2026-10-20 Add fab-format assembly BOMs per half
    BOM-assembly-left/right.csv use the fab upload columns: Item Number,
    Designator, Unit Quantity, Description, Manufacturer Part Number,
    Footprint, Value, Assembly Instructions. Instructions give the board
    side and polarity, name the top-side underglow LEDs, and mark the
    switches and controller as customer-fitted.
2026-10-20 Audit the routed board against the part datasheets
    tools/check_datasheets.py checks the PCB that gets fabricated against
    the datasheets now kept in docs/datasheets/: controller pinout and
    orientation, nRF52840 NFC/low-frequency/bootloader pins, the battery
    path through the switch, LED/diode/encoder/TRRS pinouts, antenna
    clearance and the current budget. It prints PASS/WARN/FAIL per check
    and exits 1 on any FAIL. On this board: 0 FAIL, 14 WARN.
2026-10-20 Straighten routed tracks into 0/45/90 degree runs
    tools/smooth_route.py string-pulls every track chain (one net, layer
    and width between pads, vias and junctions) into straight and 45-degree
    segments, checking clearance with KiCad's own collision, then refills
    the zones and stitches back any ground piece a moved track cut off.
    On the board: 5551 -> 3567 segments, plus one GND via on the right.
    route_pcb.stitch_fragments shared its union-find keys between the left
    and right GND nets, so a split right-half pour counted as connected
    through the left half and never got its via; clear them per net.
    DRC with schematic parity: 0 errors, 0 unconnected (22 silkscreen
    warnings, as before).
2026-10-20 Drop the underglow LEDs
    The battery sits under the PCB, where it would hide the six underglow
    LEDs per half and they would only drain it. The LED chain is now the 33
    per-key LEDs on each half (LED x01-x33), all reverse-mounted on the back.
    The schematic and placement generators no longer add them. On the routed
    board the 12 footprints and their chain copper were removed, the VCC
    links they carried were re-routed with finish_route.py, and DRC with
    schematic parity is clean (0 errors, 0 unconnected). Gerbers, BOMs, the
    schematic PDF, the plan and the shopping list are regenerated.
    (Cherry-picked from 8c0cb53, made on the board before the tracks were
    straightened; the board surgery, VCC re-ro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
2026-10-20 Cut the bottom edge back to the bottom row and thumb keys
    The convex-hull outline ran straight from the outer bottom key to the
    thumb tip and left a wedge of bare board right where the wrists come in.
    tools/trim_outline.py swaps that edge for two straight lines on both
    halves (mirrored): flat along the bottom of the outer bottom key, then
    straight down to the thumb tip, as steep as the thumb keys, pads and
    mounting holes allow. About 10 cm2 comes off each half.
    The holes H104/H203 now sit 2.9-3.0 mm from the edge (was 4.0). Six
    ROW4 segments that ran outside the new edge, and 42 GND stitching vias,
    were dropped; finish_route.py re-routed the three cut connections and
    smooth_route.py straigh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
2026-10-20 Keep the antenna keep-outs and mark the battery + pad
    load_without_zones() dropped every zone, rule areas included, so each
    cleanup_pcb.py or finish_route.py run deleted the "no ground pour" areas
    under the controllers' antennas. It now keeps rule areas, and
    ground_pours() adds any antenna keep-out the board is missing.
    gen_pcb.battery_plus() puts a "+" on the back silkscreen beside pad 1
    of BT101/BT201, so a reversed battery pack is caught before it kills
    the charger. sync_pcb.py adds it to an already-routed board.
2026-10-20 Restore the antenna keep-outs and print the battery + on the board
    Re-poured with the fixed route_pcb.py (cleanup_pcb.py twice: the second
    pass removes two GND vias left dangling under U101's antenna once the
    fill there is gone), then sync_pcb.py added the "+" beside pad 1 of
    BT101/BT201. D234's "K" moves to the other side of its pad, off the
    board edge.
    DRC with schematic parity: 0 errors, 0 unconnected, 0 parity, 22
    silkscreen warnings. check_datasheets.py: 93 pass, 10 warn, 0 fail. Its
    battery "+" check matched "SilkS" in the layer name, which KiCad 10
    reports as "B.Silkscreen", so it now compares the layer itself.
    Gerbers regenerated.
2026-10-20 Count the LED cut-outs in ORDER.md instead of hard-coding 39
    The underglow LEDs are gone, so each half now has 33 reverse-mount LED
    windows, not 39. export_fab.py now counts them from the board.
2026-10-20 Rewrite the README and add fresh renders
    A project-style README: specifications, gallery, a documentation index
    (build plan, schematic, ordering notes, BOMs, datasheets, plate print,
    firmware), hardware and PCB summary, repository layout, the PCB
    pipeline as a table with requirements and commands, ordering, status
    and credits.
    The renders are redone on the current board (bottom edge cut, no
    underglow), plus a perspective hero shot and a two-layer routing
    picture. firmware/README.md holds the planned ZMK config layout and
    what the firmware has to do.
2026-10-20 Add project CLAUDE.md: keep the README current
    Fundamental changes to the board, specs, build pipeline, docs or status
    update the README in the same change, and board changes regenerate the
    renders in docs/. tools/render_routing.py draws docs/pcb-routing.png
    (front copper red, back copper blue), so that picture can be redrawn.
2026-10-20 Black soldermask and Keygen silkscreen artwork
    The board is named after Martin Garrix's track Keygen, whose cover is a
    fake keygen.exe window. tools/silkscreen_art.py (pipeline step 8) writes
    a stackup with black mask, white silkscreen and HASL, and draws that
    cover on the free board: the MARTIN GARRIX window with an outlined
    KEYGEN logo, star cloud, moon and the cover's serial beside the left
    thumb cluster; a moon and the STMPD emblem beside the encoder; GENERATE
    between two emblems under each reset button; credits and a flashing
    hint on the underside; and stars over every free spot on both faces.
    The emblem is the label's own vector. Art stays 0.25 mm clear of pads
    and holes, clear of foot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
2026-10-20 Drop the TRRS jack and switch the battery through a MOSFET
    Settle power and connectivity before ordering. The halves talk over
    Bluetooth only; USB-C on the left half is the wired mode. The TRRS jack
    would only have replaced the Bluetooth split, needs its own ZMK build,
    can't charge the other half (the nice!nano has no VBUS pin) and must not
    be hot-plugged while a half is powered, which with a battery in each half
    is always. P0.08 and P0.17 become spare.
    The genuine nice!nano v2 charges at 500 mA with BOOST bridged, but the
    MSK12C02 slide switch is rated 50 mA. It now only drives the gate of an
    AO3401A P-MOSFET (source on the battery, drain on B+) with a 1 MOhm gate
    resistor, so no battery c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
2026-10-20 State only what the board has in the README
2026-10-20 Finalise switches and keycaps; size the BOM for one keyboard
    Switches: Akko V3 Lavender Purple Pro, 2 x 45 from StacksKB.
    Keycaps: blank DSA PBT in smoke translucent, 1u from Meckeys and
    1.25u/1.5u from AliExpress. The BOM's buy column now covers a single
    keyboard with spares; the two-keyboard quantities are gone.
2026-10-22 Raise the battery to 2500–3000 mAh per half
    The underside has room for a pouch up to 60 x 88 mm; thickness (5 mm)
    is the real limit. The cell now sits under the outer and middle key
    columns, clear of the antenna keep-out, with a lead long enough to
    reach the connector. Charge time with BOOST is about 6 h.
2026-10-22 Add the ZMK firmware: shield, keymap, builds and keymap pictures
    A keygen shield for the nice!nano v2 on ZMK main, one build per half
    with the left half as the Bluetooth central. QWERTY base with Nav, Fn
    and System layers, the encoder on volume, ZMK Studio, and the per-key
    LEDs lit only on USB power with their VCC switched off. build.sh builds
    the UF2s in ZMK's Docker image, and a GitHub Actions workflow builds
    them on every push that touches firmware/. tools/render_keymap.py draws
    one picture per layer into docs/.
2026-10-22 Power the LEDs from the battery through a MOSFET switch
    The SK6812MINI-E is rated for VDD 3.7-5.5 V, and the nice!nano's 3.3 V
    VCC has no published current limit for 33 LEDs. The LED rail (LED_VDD)
    now runs from B+ through an AO3401A P-MOSFET (Q2). An AO3400A N-MOSFET
    (Q3) on P0.08 pulls Q2's gate low to turn the LEDs on; 100 kOhm
    resistors hold Q2 off (R2, gate to source) and Q3 off while the
    controller boots or sleeps (R3). The 10 uF + 100 nF capacitors move to
    Q2's output. VCC (pad 16) is unused. The cell is inside the LEDs'
    rating until it runs low, and they light only on USB power.
    All resistors and capacitors are now 1206 hand-solder footprints. The
    new parts sit on the back between e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
2026-10-22 Add the switch plate, the gasket-mounted case, two OLEDs and a second knob
    Switch plate: a 1.6 mm FR-4 board with black mask and no copper, made by
    the PCB fab. tools/gen_plate.py writes it as its own KiCad board
    (pcb/plate/) with Gerbers per half and fab/PLATE.md. It follows the PCB
    outline with eight gasket tabs per half, 14 mm switch cut-outs, an
    encoder cut-out and an OLED window per half, and the M2 holes.
    Case: a 3D-printed PETG bottom shell and top frame per half, written by
    tools/gen_case.py (build123d) to case/ as STL and STEP. The plate and
    PCB, tied by M2 standoffs, float on Poron strips above and below each
    tab; eight M2 screws per half close the case into heat-set inserts. It
    h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
2026-10-22 Lower both knobs 4 mm and size them for a 17 x 13 mm knob
    Both encoder shafts move 4 mm toward the thumbs (y 125 to 129), so the
    knob no longer sits against the OLED and is closer to the thumb. With a
    17 mm knob its edge is 4.5 mm below the OLED module, 5.7 mm from the
    thumb cluster's top key and 9.1 mm from the G/H column. The encoder
    diodes stay where they were, beside the switch pins.
    The encoders' tracks were ripped and rerouted with finish_route.py and
    smooth_route.py; the artwork was redrawn. Each EC11's common pin C,
    2.5 mm between A and B, now connects to the ground pour solid: there is
    no room for thermal spokes beside it.
    The knob model is now 17 x 13 mm (an "amplifier" knob, D h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
2026-10-22 Give the OLED's I2C a frame-sized buffer and internal pull-ups
    The overlay runs i2c0 as nordic,nrf-twim. The SSD1306 takes no repeated
    start inside a write, so TWIM merges the control byte and the frame into
    one transfer through its concatenation buffer, which defaults to 16
    bytes: every frame write would fail with -ENOSPC and both OLEDs would
    stay blank. zephyr,concat-buf-size is now 1025, the control byte plus a
    full 128 x 64 / 8 = 1024-byte frame.
    SDA and SCL also get the nRF52840's internal pull-ups, so the bus still
    works on a module that ships without its own.
    All three UF2 builds pass. Left: 49% flash, 33% RAM; right: 40%, 19%.
2026-10-22 Give the battery a bay in the case floor and fit-check it
    The LiPo now lies in a bay sunk 1 mm into each bottom shell's floor
    instead of on kapton over the solder joints. The bay fits the largest
    cell bom.csv allows (60 x 88 x 5 mm) plus 1.5 mm each side.
    case_geometry.py places it as near the battery connector as it can while
    keeping 15 mm from the antenna end and 3 mm from the tall parts under
    the PCB: under 1-4, Q-R and A-F on the left, mirrored on the right, its
    lead end about 40 mm from the connector. The case height is unchanged.
    gen_case.py's fit check now includes the cell, grown 0.5 mm for
    tolerance and swelling: 2.5 mm below the sockets and diodes, 1.0 mm with
    the floating stack p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
2026-10-22 Clear the silkscreen warnings
    DRC with schematic parity now shows 0 errors, 0 warnings, 0 unconnected
    and 0 parity issues; the 16 silkscreen warnings are gone.
    The controller's USB end crosses the board's sloped top edge, so its
    outline and USB box ran up to 0.91 mm off the board. The keygen copy of
    nice_nano_H_USBup now stops both at a straight line 0.3 mm inside the
    edge, with "USB" in the shortened box and "topside" just under it. The
    module PCB stays at least 0.21 mm inside the edge on both halves; the
    USB-C receptacle's outer corner reaches 0.22 mm past it, within the
    case's 1 mm USB_OVERHANG.
    sync_pcb.py now redraws any keygen footprint whose graphics no longer
    match the library, on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
2026-10-22 Cover the plate with a top frame deck, add foam cut files, sort case/
    The top frame now carries a deck level with its rim (6.6 to 8.6 mm above
    the PCB) that covers the plate everywhere but the keycaps, 0.6 mm clear
    of each. The OLED window is chamfered and opens further towards the
    thumbs, so the whole active area shows at 50 degrees from vertical; the
    glass sits 3.5 mm below the deck top. The encoder bushing passes through
    a 9 mm hole hidden under the knob, whose underside is 2.9 mm above the
    deck. Webs under 1 mm and any islands are dropped.
    gen_case.py also writes the three foam layers per half as 1:1 DXF and
    SVG: 0.5 mm PE switch foam on the PCB (holed for every pin, pad, LED
    window, st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
2026-10-22 Check in the foam STEP files
    case/foam/step/ holds each foam layer per half as a solid, in place: 26 MB
    raw, about 4 MB compressed in git, the PE switch foam the largest at 11 MB
    per half. They are no longer ignored, so every generated file is in the
    repo.
2026-10-22 Add assembly instructions, slim the README, track the notes
    INSTRUCTIONS.md is a step-by-step build: ordering, soldering per half,
    plate, OLED and switches, closing the case, flashing and troubleshooting.
    The README keeps the specifications, a few pictures and links. Its
    hardware detail and build pipeline now live in the notes, as
    16 - hardware reference and 17 - building from source.
    notes/ is now a tracked copy of the Obsidian vault folder instead of a
    symlink into it. Images move from docs/ to assets/, and the render
    scripts write there; docs/ keeps the datasheets.
2026-10-22 Add CNC and laser cut files for the switch plate
    gen_plate.py now also writes case/plate/dxf/: a DXF per half with dogbone
    corners for a 1/8 in. router bit, the outline, cut-outs and drilled holes
    on separate layers, and a fit-test strip of cut-outs from 13.90 to 14.10 mm
    for setting the cutter offset. PLATE.md says how to cut them.
    render_bom.py writes the BOM note into notes/, which the hooks mirror into
    the vault, instead of writing the vault copy directly.
2026-10-22 Drop the plate fit-test strip and the cutter-offset notes
2026-10-22 Use a SuperMini controller, Poron switch pads and EVA foam
    The parts as bought: an nRF52840 SuperMini (nice!nano v2 clone, about
    100 mA charging, no BOOST jumper) per half, Poron ring switch pads under
    each switch in place of the PE sheet, 2 mm EVA plate foam and 5 mm EVA
    case foam, Poron gasket strips cut to 12 mm, a D-shaft EC11 and a 505080
    cell with a protection board. gen_case.py no longer writes the switch-foam
    sheet; the plate-foam model is 2 mm. BOM, notes, instructions, build plan
    and case renders follow.
2026-10-23 Screw the case together from below
    The bottom shell and top frame now join with M2 x 16 socket-head
    screws driven up through counterbores in the floor into heat-set
    inserts in blind holes in the top frame's underside, so the top has
    no screw holes. gen_case.py checks that the walls stay solid round
    every screw. BOM, checklist, instructions, notes and the case renders
    follow.
2026-10-23 Model the Poron ring switch pads and the gasket strips
    The switch pads are single Poron square rings, one stuck on the PCB
    round each switch, not a sheet. gen_case.py now models them in place
    (18 mm across, 14.2 mm open middle, notched on the clip sides, sized
    from the listing photos), clipping the 7 per half whose corner meets a
    standoff, and models the 12 x 4 mm gasket strips under and over each
    plate tab, squeezed as when closed. The fit check covers both. The
    exploded render shows the rings and the strips, and the EVA foam now
    renders grey, as bought, rather than pink.
    The checklist marks the EVA foam in the Amazon cart and says where
    each foam layer and gasket strip goes. Instructions,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
2026-10-23 Buy every keycap from one AliExpress seller
    All the blank DSA PBT keycaps now come from SZElectronic Store on
    AliExpress, in one order with the LEDs, so the smoke shade matches
    across sizes: a 50-pack of 1u in LBlack plus a 10-pack of mixed colours
    (two accent keys and spares), a 10-pack of 1.25u in LBlack and a
    10-pack of 1.5u in Clear Black. Meckeys drops out. The checklist, BOM,
    rendered BOM page and notes follow.
2026-10-23 Regenerate stale outputs automatically
    tools/regen.py knows what each generator reads and writes: the
    schematic and its PDF, the ZMK layout, keymap pictures, 3D models,
    plate, plate print, case and foam, the case and board renders, the
    routing picture, Gerbers, both BOMs and the BOM page. It hashes each
    step's inputs (its script, the tools/ modules it imports and its data
    files) against tools/regen.lock and reruns only the stale steps, so
    outputs that differ only in timestamps don't churn.
    A Claude Code Stop hook runs it at the end of every turn and hands a
    failing step back as feedback; a git pre-commit hook refuses a commit
    while anything is stale. A full run confirmed every committed out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
2026-10-23 feat(layout): refine thumb cluster and OLED placement
    Use 1.25u lower thumb keys, keep the upper pair at 1u, move the encoders and OLEDs, and align the board outline with the thumb row. Regenerate the routed PCB, case, plate, print sheets, fabrication files, BOM, and documentation.
2026-10-24 Cut the plate from FR-4 sheet and fit the HongYan EC11H encoder
    The switch plate is now CNC-routed from one 300 x 300 mm sheet of
    1.5 mm black FR-4 with the DXFs; the Gerbers stay as the PCB-fab
    alternative at 1.6 mm. The encoder is the HongYan EC11H with a 20 mm
    D shaft: wider mounting slots in the footprint, a 15 x 15 mm plate
    cut-out, a local relief under the top frame for its taller body and
    the knob raised to match. The OLED window and keycap windows get more
    clearance.
    The plate sits on stock M2 x 3 brass standoffs over 0.5 mm DIN 988
    shims, with M2 x 3 screws where a plate screw shares the standoff and
    M2 x 4 elsewhere. The battery bay is sized for the installed stack
    (cell, thicknes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
2026-10-25 Trim thin points off the top frame's deck for printing
    The deck between the keycap windows kept any web wider than 1 mm, which left a
    wedge tapering to a point between the thumb keys and the bottom row, and a
    sharp tip beside the encoder: on a 2 mm printed deck both snap off. Every web
    or point inside the walls narrower than 4 mm (DECK_MIN_WEB) is now trimmed back
    to a rounded end; the rim keeps its sharp corners. The print settings go in
    INSTRUCTIONS.md.
2026-10-25 Use 3 mm gasket strips squeezed by a third
    The 2 mm Poron strips were squeezed 0.4 mm, less than an FDM print's error
    across two parts, so a shell or frame printed 0.2 mm off could leave the plate
    loose or the strips crushed. 3 mm strips squeezed 1.0 mm stay 27-40 %
    compressed either way. The ledge drops to 1.5 mm and the top frame rises to
    9.0 mm, so the case is 23.6 mm tall; the fit check still finds no overlaps.
    The case is printed at 90 % infill for weight.
2026-10-25 Render the case from straight above
    render-case-top.png shows the whole keyboard in its case from above, where the
    top frame's deck round the keycaps can be judged; the angled views hide it.
2026-10-25 Model DSA keycaps from KeyV2 and add a Blender scene
    The keycaps are KeyV2's DSA 1u and 1.25u (lib/KeyV2), generated by
    tools/gen_keycaps.py: black for KiCad's renders, and as STL for Blender.
    Their skirt sits CAP_SKIRT above the plate, where the case's clearance
    check expects it.
    blender/keygen.blend is a hand-kept studio file that links the parts
    built by tools/gen_blend.py into blender/keygen-parts.blend: smoke
    caps lit by the per-key LEDs, clear-top lavender switches, black PETG
    case, black FR-4 plate and the black-mask PCB. The parts file is
    gitignored and kept current by a new local regen step, which
    --check skips. gen_case.py also writes the plate as STL now.
2026-10-25 Show Cycles renders and GIFs of the Blender scene in the README
    tools/render_blender.py (the studio-renders regen step) renders the
    studio file with Cycles: a hero still from the studio camera, a top
    view, a close-up of the knob and thumb cluster, a rainbow wave across
    the per-key LEDs and a turntable, as JPEGs and looping GIFs in assets/.
    They lead the README gallery; the case layers and the PCB stay KiCad
    renders.
    The renders add about 14 minutes to a full regen, so the Stop hook's
    timeout goes to 40 minutes. The studio camera now frames the case, and
    the smoke caps and PETG are rougher and the key light softer, so they
    read black rather than grey.
2026-10-26 Publish generated binaries to GitHub releases instead of git
    The renders and GIFs, the PCB and plate Gerbers, the case, plate and
    foam files, the schematic PDF and the generated 3D models are now
    gitignored. tools/regen.py still makes them, and its lock still covers
    them, so a commit waits until they are current. The new pre-push hook
    runs tools/publish.py when main is pushed. It uploads whatever changed
    to two releases under fixed tags: "media" for the README pictures and
    "build" for everything to order, print or cut. The part datasheets
    move to a "datasheets" release.
    The README, INSTRUCTIONS.md, ORDER.md, PLATE.md, the datasheet index
    and the notes link to the release downloads.
2026-10-26 Show the bare PCB and its silkscreen artwork in the README
    render_board.py also renders the board with every 3D model taken out: at an angle, from above and from below. The README's PCB section shows all three, and the silkscreen notes show both faces.
2026-10-26 Move the underside silkscreen art clear of the encoders
    Since the HongYan EC11H went in, its pins and mounting slots cut through the GENERATE rows, the keygen.exe window and the credits, and the window and the right-half GENERATE row ran off the inner edge. Each piece now sits where nothing clips it: the window and both GENERATE rows a few millimetres over, and the credits split into a smaller logo above the left encoder's pins and 0.9 mm lines below them. DRC is clean.
2026-10-26 Stand the top KEYGEN window upright beside the controller
    The wide window sat over the left encoder, so its pins, mounting slots, outline and label cut the title, the logo and the serial, and its frames ran off the edge. No clear spot on that face fits a 39 x 23 mm window, so it is now upright in the corner right of the controller's header rows: the same title bar, star cloud, moon, serial and stacked frame, with the logo as KEY over GEN. Nothing clips it, and DRC is clean.
2026-10-26 Tidy the underside text: the credits in a column, a maker's mark on the edge
    On the left half the GENERATE row, a larger KEYGEN logo and the repo link with the revision now share one centre line; the 'wireless split keyboard' and 'named for Keygen' lines are gone. Along the right half's bottom edge: KEYGEN REV 0.1 over DESIGNED BY MILIND MADHUKAR. The silkscreen font gains a middle dot. DRC is clean.
2026-10-26 Give the keycaps room to clear the top frame's deck
    The keycap skirt sits 6.7 mm above the plate at rest (the MX slider's
    shoulder in the switch model), not 7.5 mm, so a pressed cap sinks about
    1 mm into its deck window. The 0.8 mm window clearance left nothing for
    a full-size 18.4 mm DSA skirt and the plate floating 0.5 mm in its
    gasket pockets.
    Widen the windows to 1.2 mm clear of each cap and chamfer their mouths
    0.4 mm on the deck top, the face printed on the bed. The fit check now
    takes the caps at their largest and lowest, grown by the plate's float,
    and check_mechanical budgets the float and checks a pressed cap clears
    the plate screw heads.
2026-10-26 Size the USB-C port for the plug, and render the case from the side and below
    The USB-C opening was a 20 mm slot from the PCB's underside down
    through the floor, sized for the controller's whole end. Put that end
    in a pocket inside the wall instead, open at the top of the bottom
    shell so the stack drops in straight, and cut a 14.2 x 9.8 mm port
    with 2 mm corners through the 1.5 mm of wall in front of it. The port
    takes the largest plug overmould the USB-C spec recommends, carried by
    the floating stack 0.5 mm sideways, 1.5 mm down and 1.0 mm up, with
    0.4 mm to spare, so a plugged cable never ties the stack to the case.
    The wall stays thinned 1.5 mm past the inner wall round the lever.
    The po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
2026-10-26 Add feet and magnetic tenting, and fix the fit issues from a build audit
    Each half's flat floor takes four 10 x 4 mm rubber feet and a 35 x 45 mm
    steel plate for a detachable magnetic tenting stand, placed clear of the
    screw counterbores, the reset pinhole, the USB-C opening and 15 mm from
    the controller's antenna end; spare plates add weight under the battery
    bay. The parts list and the shopping checklist gain the M2 x 16 case
    screws, the stands, plates and feet, flux, Kapton tape and a puller.
    The reset guide tube ended 1.0 mm under the button, inside the stack's
    1.5 mm float, so pressing the board down could reset the half. It now
    stops FLOAT_GAP + 0.5 mm under the button, and the fit ch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
2026-10-27 Rewrite the build instructions for a first-time builder, with assembly maps
    INSTRUCTIONS.md now opens with what the build is, the skills it needs and
    the terms it uses, then a plan of what to get when: the plate and its foam
    wait for an OLED module to be measured, the case and its foam for the
    controller sockets, and soldering needs neither. Each step says which side
    a part goes on and which side it is soldered from, and the flashing section
    says where the firmware files come from.
    tools/render_assembly.py draws assembly maps, every part's reference on each
    side of each half and the power parts enlarged, from the board's fab layers
    (the silkscreen hides most references). A regen step keeps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
2026-10-27 Make the switch plate clear polycarbonate, and add the wrist rests
    The plate is now 1.5 mm clear polycarbonate, CNC-routed (not laser-cut) from a
    6 x 24 in. solid sheet from Amazon.in, which holds three halves. The thickness is
    unchanged, so the stack and the case are too. PLATE.md leads with routing the
    sheet; the Gerbers stay as the same plate in FR-4 from a PCB fab.
    The case model, the Blender scene and the plate render show the plate clear.
    Also add the wrist rests (Amazon.in) to the BOM and the checklist.
2026-10-27 Lower the case 1 mm, and take 2.5 mm feet
    Size the controller's space under the PCB from the socket height (7.5 mm with 3.0 mm sockets),
    and sink the battery bay 1.6 mm into the floor so the cell keeps 1.0 mm to the underside parts
    with the stack pressed down. The case is 22.6 mm tall and the keycap tops about 33 mm above the
    desk, before feet. The feet are 10 x 2.5 mm.
2026-10-27 Show ZMK's status screen on the OLEDs in the Blender renders
    tools/render_oled.py draws each half's 128 x 64 screen as ZMK's built-in status screen lays it
    out, with LVGL's own Montserrat fonts from the ZMK workspace: Bluetooth profile, battery and
    layer on the left, the link and battery on the right, on USB power. It writes
    assets/oled-{left,right}.svg (the new regen step "oled"), and the Blender scene lights each
    OLED's active area with its screen, pixel by pixel.
    Add a studio close-up of the left OLED (render-studio-oled.jpg) to the README, and the screens
    to the firmware README.
2026-10-27 Source in India where it costs about the same, and fix the outer top foot
    A pre-order audit of every listing and cart (2026-10-27). The flux,
    Kapton tape and rubber feet move from AliExpress to Amazon.in and the
    puller to StacksKB, each for less than ₹300 more; the rest stays on
    AliExpress, where nothing in India matches it at the price. The feet are
    now 8 x 3 mm clear domed bumpers. The checklist gains today's prices, the
    stock warnings, the Robu case print quoted from the current STLs (₹893),
    a JLCPCB comparison for the boards and the FR-4 plate, and a note that
    the polycarbonate plate needs a local CNC router shop.
    Step 21 put the outer top foot 7 mm in from both edges, over the oute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
2026-10-27 Order the PCBs from JLCPCB
    Both halves come to US$40.63 with UPS to India (US$15.40 each: black,
    lead-free HASL, 1 oz, Remove Mark), about ₹3,600 plus customs, against
    ₹6,800 at Lion Circuits, which stays as the fallback. ORDER.md gains the
    Remove Mark setting, so the order number stays off the silkscreen art.
    The checklist's estimate drops to about ₹20,200, and corrects the JLC
    figure the audit commit got wrong (it priced the shipping twice).
2026-10-27 Take the steel plates from Amazon.in and trim the Robu spares
    The tenting stand's steel plate is now one of a LIRAMARK pair from
    Amazon.in (65 x 45 x 0.6 mm, ₹99), laid long side across the inner half
    of the floor, 10 mm below the reset pinhole and 18 mm from the antenna,
    clear of the screws, the pinhole and the feet; the five AliExpress plates
    and the spares for weight go. Robu's order drops to two encoders and two
    strips of machined pins, which make the four 12-pin rows.
2026-10-27 Set the tenting stand's steel disc flush into the floor
    Each bottom shell's underside gets a 40.6 mm pocket, 1.0 mm deep, for a
    40 mm round steel plate (LIRAMARK, Amazon.in), so it sits flush like the
    counterbored screw heads; the depth takes the plate and its tape with the
    bridged ceiling sagging a little, and leaves 2.0 mm of floor.
    case_geometry.steel_disc() places it on the inner half as far as it can
    from the battery bay (whose floor is thinner), the counterbores, the reset
    pinhole and the floor's edge, and 15 mm or more from the antenna;
    check_mechanical.py checks those clearances. A 65 x 45 mm plate found no
    room clear of the bay. The Robu print is requoted from the new shells at
    ₹9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
2026-10-27 Rewrite the build instructions as a build guide, after TOTEM's
    INSTRUCTIONS.md now opens with the parts in tables (electronics, switches
    and caps, plate and case, feet and tenting), then the tools, a picture of
    which part goes on which side, the plan, and one short section per part
    in soldering order, each with a close-up of that part's pads and marks.
    The things that break a board (a reversed battery, the controller chip
    down, an OLED with GND and VCC swapped) are warning callouts.
    render_assembly.py draws the overview, the left half from the front and
    the back with each part filled by type, and a close-up of one part of
    each type, references hidden, with a caption saying how it goes in.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
2026-10-27 Draw Keygen's own OLED screens, with a boot animation and a lighting menu
    The screens are plain C on a 128 x 64, 1-bit framebuffer in firmware/module/src/ui: a boot
    animation after the Keygen cover (stacked windows, the logo over star dust and a moon on the left,
    a serial generated between two cubes on the right), the left and right status screens, and the
    right knob's lighting menu. tools/render_oled.py now builds them for the PC and plays scripted
    scenes through them into GIFs and the SVGs Blender reads; tools/gen_oled_assets.py writes their
    fonts, icons and logo. The firmware does not run them yet.
2026-10-28 chore(hardware): audit power, lighting, and assembly
    Verify switch and LED geometry, net connectivity, firmware lighting behavior, and current limits. Record prototype checks and update build guidance and generated assets.
2026-10-28 Mount the OLED in the top frame and fix the plate fasteners and foam
    The OLED module moves from the PCB into the top frame. Its glass sits in a
    pocket under a 1.0 mm lip, 1.0 mm below the top surface, and its board on a
    boss under the deck, located by four pegs through its corner holes whose
    tips are melted over or glued. A Dupont lead from it plugs onto a 1x4
    right-angle header in J101/J201, lying flat under the module, so the top
    frame comes off without unsoldering. The module geometry now follows the
    GME12864-11 drawing: glass centred, lit area 6.37 mm from the pin edge, the
    flex cable round the far edge.
    Each plate standoff takes one M2 x 5 screw from below, 2.9 mm into its
    thread, and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
2026-10-29 Set the knob height from the encoder drawing and order the connectors
    The EC11H's 20 mm shaft is measured from its 6.5 mm body, so its tip is
    26.5 mm above the PCB and an uncut shaft holds the knob 6.5 mm off the
    deck. The case now works out the knob's height from its measured depth
    and hub (KNOB_DEPTH, KNOB_HUB_UP): it sits 4.1 mm above the deck, clear
    with the stack pressed down and the knob pushed, its hub clear of the
    bushing, 6.7 mm above the keycaps, after cutting 2.4 mm off the shaft
    before soldering. The fit check, the knob's 3D model and the
    instructions follow, and the checks hold them to it.
    The battery's JST-PH plugs and the OLED's right-angle header are in the
    AliExpress cart.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
2026-10-30 Add a printed tenting wedge held by magnets to the steel disc
    An optional 13° PETG wedge per half replaces the magnetic tenting stand. The half
    stands on its rubber feet in recesses in the wedge, and four superglued 10 x 3 mm
    magnets hold the floor's steel disc. gen_case.py writes the wedges to case/wedge/,
    the STLs top face down as they print, and check_mechanical.py checks the feet and
    the magnets.
    Add wedge views to render_case.py and a tented studio set to render_blender.py,
    which stands each half on its wedge.
2026-10-30 Allow for the pin carrier under the controller and buy the wedge magnets
    The controller rests on the male pins' plastic carrier as well as the
    socket, which the case left out, so a plug sat on the port floor with no
    float. PIN_CARRIER_H (1.9 mm, measured on arrival) lowers the floor and the
    USB-C port to match: the bottom shell is 19.0 mm tall and the case 24.5 mm.
    The M2 x 16 screws are unchanged, their seat follows the joint.
    The wedge magnets move to the AliExpress order, a true N35 10 x 3 mm disc,
    so the pockets stay as drawn. Flux and 12 mm Kapton are in the Amazon cart.
    The case and wedges are quoted from the current STLs, and the checklist
    total follows real cart prices and today's e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
2026-10-31 Bring the README up to date: the wedges, the OLED mount and the status
2026-11-02 feat(keygen): add encoder mount study and OLED boot animation
2026-11-02 feat(firmware): deep sleep after an hour idle
    Set the idle and deep sleep timeouts explicitly, with deep sleep moved
    from 15 minutes to 1 hour. Each half times out on its own, so the longer
    timeout keeps the right half awake through left-hand-only use.
    Document the sleep behaviour and add a sleep-current check to the build
    guide. The plate file and regen.lock are regenerated; the plate geometry
    is unchanged, only its ids and footprint order differ.
2026-11-02 feat(pcb): mount the encoder in the top frame with a 5-pin cable
    Pressing the knob no longer pushes on the gasket-mounted plate and PCB.
    Each EC11 is clamped to a boss in the top frame by its washer and M7 nut,
    with two cheeks that stop the body turning. The plate (18 x 18 mm) and
    PCB (18 x 20 mm) have openings so they float round it.
    - PCB: ENC101/201 become padless, board-only footprints carrying the 3D
    models; a side-entry JST-PH 5-pin header (J102/J202) on the back faces
    the opening; D107/D207 move 2 mm clear of it. Only the copper the change
    touched was rerouted; DRC and schematic parity are clean.
    - Case: boss, cheeks and a foam bay for the terminals, lead and header.
    The knob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
2026-11-02 feat(pcb): connect the encoder by a pin header and jumper lead
    Replace the JST-PH header with a 1x5 right-angle 2.54 mm pin header
    (J102/J202) on the back, pins pointing away from the thumb keys, so the
    encoder plugs in like the OLED: five female-female jumper wires glued into
    one plug and soldered to the encoder. Both parts are already on hand.
    The plug lies flat under the PCB beside the opening. Only the encoder nets
    were rerouted; DRC and schematic parity are clean.
2026-11-02 fix(pcb): keep the encoder's jumper plug clear of the screw heads
    With a 14.5 mm Dupont housing and room for its wires to bend, the plug on
    J102/J202 reached the M2 button heads under H103/H202 and came within
    0.3 mm of the board edge. Move both headers 5.5 mm south.
    The plug envelope is now part of the case model: it joins the case foam's
    encoder bay, and check_mechanical requires 1 mm to the board edge and the
    screw heads, and 0.5 mm to the encoder after the board's float. DRC and
    schematic parity are clean.
2026-11-04 feat(pcb): switch the power slide to an SK12D07VG5 through the case wall
    The MSK12C02's 1.45 mm lever stopped 1.8 mm inside the case wall's outer
    face, reachable only with a fingernail or a pin. Replace it on both halves
    with a Shou Han SK12D07VG5 right-angle through-hole slide switch (LCSC
    C431548): its 4 mm knob reaches 4 mm past the board edge and stands 1.5 mm
    proud of the wall (1.0-2.0 mm as the stack floats).
    - Footprint and box model generated from the datasheet drawing; pin 3 is
    unconnected, since the switch makes before it breaks.
    - SW190/SW290 moved 1 mm away from the board corner, so the outer tab hole
    is 1.7 mm off the side edge. Only the gate and ground were rerouted; DRC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
2026-11-04 docs: describe the SK12D07VG5 power switch
    The build steps solder it with the through-hole parts and drop its knob into
    the case's slot; the top frame's tongue closes it. The notes, the plan page,
    the datasheet index (with a translation of its Chinese notes) and the
    shopping checklist name the new part: 5 from Robu.in, the ₹10 line minimum.
2026-11-08 docs(bom): mark the Amazon.in cart as ordered
2026-11-08 fix(pcb): move the underside artwork clear of the encoder openings
    The 18 x 20 mm encoder openings and the J102/J202 headers cut through GENERATE, the KEYGEN logo and the flashing hint on the back, and the opening clipped the STMPD RCRDS label on the front. Stack the emblem, GENERATE and the hint in the strip beside each opening, move the logo and link to the left half's bottom edge, and shrink the front emblem to fit.
2026-11-08 fix(pcb): join every pad to the ground fill through thermal spokes
    SMD ground pads (the LEDs, Q103/Q203, R103/R203, C101/C102, C201/C202) were flooded solid into the fill on both layers, which sinks the heat of a hand iron. Pour with thermal reliefs on every pad; a design rule lets the nine LED ground pads with room for only one spoke take one. DRC and schematic parity are clean.
2026-11-09 docs: drop underglow wording; the LEDs are per-key backlights
    ZMK's own identifiers (CONFIG_ZMK_RGB_UNDERGLOW*, zmk,underglow, &rgb_ug,
    the underglow feature tag) stay, since the firmware needs them.
2026-11-09 feat(pcb): power the LEDs from a 5 V boost and buffer their data
    The SK6812MINI-E wants 3.7-5.5 V and 0.7 x VDD on its data input; the
    raw cell gave 3.0-4.2 V and the controller's 3.3 V data had no margin.
    - LED_VDD is now 4.95 V from a TI TPS61023 (U2, SOT-563): 1 uH TDK
    TMS322512ALM-1R0MTAA, 2 x 22 uF out, 10 uF in, 732k/100k feedback,
    laid out as the datasheet's example. P0.08 drives its EN (R3 holds
    it low); shut down it disconnects the rail. Q2, Q3 and R2 are gone.
    - An SN74LV1T125 (U3) on the rail, beside the first LED, drives the
    chain at 5 V through 330 R (R5), with 100 nF (C2) at its supply.
    - A 0805 100 nF footprint beside every LED, every fourth fitted (the
    rest DNP), a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
2026-11-09 feat(firmware): make lighting on battery an opt-in, saved setting
    A Keygen ZMK module (firmware/module, loaded through zephyr/module.yml
    in CI and by build.sh) replaces ZMK's USB auto-off:
    - on USB the lighting is ZMK's own;
    - on battery it stays off unless &kg_bl (System layer, Z) allows it,
    saved in settings; when allowed it is capped at half the brightness
    scale, halved below 20 % charge and off below 10 %;
    - whenever the lighting is off it disables ext-power, so the LED boost
    and its rail are off.
    It re-checks after every USB, battery and activity event, since ZMK's
    idle wake can restore the lighting. Left, right and settings_reset
    build at the pinned ZMK.
2026-11-09 docs: describe the LED boost, data buffer and battery lighting
    README specifications, build guide (BOOST link bridged for 300 mA,
    soldering the SOT-563, boost and buffer close-ups), hardware notes,
    datasheet index (TPS61023, SN74LV1T125, the TDK inductor), logic audit
    (re-checked limits), firmware README and the Robu shopping checklist.
2026-11-09 feat(pcb): hand-solder pads for the LED boost, no stars under the controllers
    - keygen:SOT-563_HandSolder: KiCad's SOT-563 with each pad 0.4 mm
    longer outwards (0.6 mm of pad past the leads for an iron); the inner
    edges and the 0.5 mm pitch are unchanged, so the routing stays. One
    5 V link on the right half moved 0.2 mm to keep 0.15 mm from SW.
    - silkscreen_art.py: no stars between or under the controllers' header
    rows on either face; the KEYGEN window and the moon stay.
    - ORDER.md and the notes give the 0.15 mm clearance at the boost's pins.
    DRC with schematic parity: 0 errors, 0 unconnected, 0 parity.
2026-11-10 fix(tools): straight maze routes, and cleanup that only removes dead copper
    - finish_route.py: the A* charges 3 grid steps for a 45 degree bend
    and 7 for 90 or more, so its paths run straight between few corners
    instead of stair-stepping across the 0.2 mm grid.
    - cleanup_pcb.py: prune the dangling vias and stubs DRC reports by
    UUID. Matching by position also took any live track passing through
    a stub's dangling end, which cut 18 connections on one run.
2026-11-10 feat(pcb): room to hand-solder the LED buffer, optional LED caps, no wiggles
    - The data buffer (U103/U203) moved to a spot beside the first LED with
    1 mm clear of every other pad and 0.5 mm of every other courtyard;
    its 100 nF and the 330 R sit beside it with the same margins. It was
    0.03 mm from LED101.
    - Seven LED capacitor spots moved to keep 0.5 mm from other parts'
    pads and 1 mm from hotswap and through-hole pads. No via sits in a
    pad of any fitted new part.
    - The 66 per-LED 100 nF footprints are all optional (DNP): the boost's
    2 x 22 uF and the 10 uF at the chain's end decouple the rail.
    - Every staircase on the board (157, most from earlier maze-router
    passes) was ripped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
2026-11-10 fix(firmware): one owner for the lighting, a knob that scrolls
    - battery_lighting.c now alone turns the lighting on and off
    (AUTO_OFF_IDLE off): off when idle, as set on USB, on battery only
    when &kg_bl allows it. It saves what the user set (on or off,
    brightness, battery lighting), so the battery cap can't become the
    stored brightness and a reboot from deep sleep keeps the wishes.
    Changes it didn't make are taken as the user's, so the brightness
    keys work on battery. The 10 % and 20 % thresholds have 5 % of
    hysteresis, and it waits for the first battery reading.
    - &kg_bl has empty parameter metadata and a display name, so ZMK
    Studio can assign it.
    - Left knob: SCRL_VAL 100 a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
2026-11-10 feat(tools): hardware keep-outs, power-track widening, hidden stuck labels
    - route_pcb.py: a 3 mm keep-out (no tracks, vias or fill) round each
    mounting hole, where the shim, standoff and screw head bear on the
    board; finish_route.py and smooth_route.py route round it.
    - widen_power.py: widens BAT_RAW, VBAT and LED_VDD segments to 0.6,
    0.5 or 0.4 mm wherever clearance allows (pipeline step 5b).
    - silkscreen_art.py: a footprint label with no clear spot is hidden,
    not left over a pad or a pin-1 mark.
2026-11-10 fix(pcb): no copper under the mounting hardware, wide supply tracks
    - No tracks, vias or ground fill within 3 mm of the ten mounting holes;
    the 25 track pieces there (COL0/3/4/6, ROW2/4, K46, LED_D6/D16) are
    rerouted round them.
    - Battery path and LED supply widened: BAT_RAW and VBAT are all
    0.4-0.6 mm, the LED rail 0.6 mm for most of its length.
    - R204's label, which covered U202's pin-1 mark, is hidden.
    - DRC with schematic parity: 0 errors, 0 warnings, 0 unconnected.
    - Order notes list the DFM flags to expect (hotswap ring, SOT-563 mask
    web, LED windows). Parts list: the 100 kOhm 1 % is Yageo
    RC1206FR-13100KL (the -07 is out of stock at Robu), the SuperMini
    charges at 300 mA,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
2026-11-10 feat(firmware): LED bring-up builds and a bring-up that works
    - KEYGEN_LIGHTING_TEST and two builds, keygen_left-led-test and
    keygen_right-led-test: each half lights its LEDs on its own, on
    battery too, saving nothing, so LEDs can be tested as they go on.
    build.sh honours build.yaml's artifact-name.
    - Build guide: measure the LED rail (4.83-5.08 V) before fitting any
    LED; check the SuperMini's VCC is 3.3 V before plugging the OLED in;
    the slide switch doesn't protect against a reversed cell; the LED
    test uses the bring-up build with battery and USB, battery out to
    solder.
2026-11-10 docs(assembly): when and how to fit the standoffs and switch pads
    The guide had the standoffs and the Poron switch pads, but not when to fit
    them or how, and the pictures did not show them.
    - Standoffs and Switch pads get a When line, the parts per half and
    numbered steps. The pads go on the PCB's front, never the plate; each
    is lifted off its backing sheet with tweezers; seven per half have a
    bite snipped out beside a standoff's shim.
    - The OLED header moves ahead of the standoffs, so all soldering is done
    before any foam goes on. The plate foam and the plate get their own
    section, and the plan table follows the new order.
    - The rings lie over the diode joints (26 of 33 keys per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
2026-11-10 feat(pcb): SMD diodes on the back, so the switch pads lie flat
    On 26 of the 33 keys per half the DO-35 diodes' front-side joints sat
    under the Poron switch pad's 1.9 mm band, each pad covering 79% of it,
    so the ring would tent over two joints and not stick. Rings on 19.05 mm
    pitch are 1.05 mm apart, so no spot by a switch was free of them.
    - The 68 diodes are 1N4148W (Diodes Inc 1N4148W-7-F, SOD-123, Robu.in)
    on the back, centred where the DO-35 pads were. New footprint
    keygen:D_SOD-123_HandSolder: KiCad's SOD-123 with 1.6 x 1.2 mm pads,
    0.7 mm longer outwards for an iron. Nearest other pad 1.18 mm,
    nearest hotswap pad 1.45 mm, no courtyard overlaps.
    - The copper they touched and th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
2026-11-10 docs(bom): the SMD diodes are in the Robu cart
2026-11-10 feat(video): build-guide video: Blender clips, Piper voiceover and scene script
    Animated EEVEE clips of the build from blender/keygen.blend (resumable,
    one clip at a time), a Piper voiceover with frame timings, and the
    narration for every step of INSTRUCTIONS.md.
2026-11-10 feat(video): Remotion scenes, diagrams and music bed for the build video
    Step panels with the current step highlighted, chapter cards, parts and
    troubleshooting tables, the plan timeline, labelled exploded view, and
    animated diagrams for the steps the renders don't show.
2026-11-10 feat(video): build script, framed close-ups and fixed exploded-view anchors
2026-11-10 fix(video): place multi-mesh parts as one, follow small parts with the camera
2026-11-10 fix(video): SMD diodes in the 3D clips, built from the PCB's pads
2026-11-11 feat(docs): printed A4 reference, regenerated and published with the build
    tools/print_reference.py writes docs/keygen-reference.pdf, black and white on A4:
    each half's key layout at 1:1 with every layer's legends and switch references,
    the back of each half at 1:1 (fab layer, no switch holes, no unfitted parts), the
    power parts enlarged, each part type close up, the keymap, the key matrix with
    the controller's pads, and the parts lists with tick boxes.
    A regen.py step keeps it current; publish.py uploads it to the build release.
    The keymap pictures now label &kg_bl as "LEDs on battery".
2026-11-11 chore(case): Bambu Studio print projects for the case
2026-11-11 fix(docs): no switch-pin circles on the reference's 1:1 back maps
2026-11-11 feat(pcb): diode silkscreen drawn like the part, cathode bar at pad 1
    The 1N4148W footprint's silkscreen was a thin bracket closed at the cathode,
    easy to misread. It is now the part's outline with a solid bar across it at
    the pad 1 (cathode) end, as on the diode and in its datasheet drawing, so the
    band goes over the bar. The fab layer marks the band at the body's end too.
    Redrawn on all 68 diodes with sync_pcb.py; only their graphics changed.
    DRC with schematic parity: 0 violations, 0 unconnected, 0 parity.
    check_datasheets: 127 pass, 0 fail.
    The printed reference's back pages are centred, with a one-line subtitle
    instead of the notes. Gerbers, renders, maps, BOM notes and the build guide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
2026-11-11 feat(docs): the case footprint of each half at 1:1 in the printed reference
