milindmadhukar/keygen/notes/attachments/Pasted image 20260426015004.png

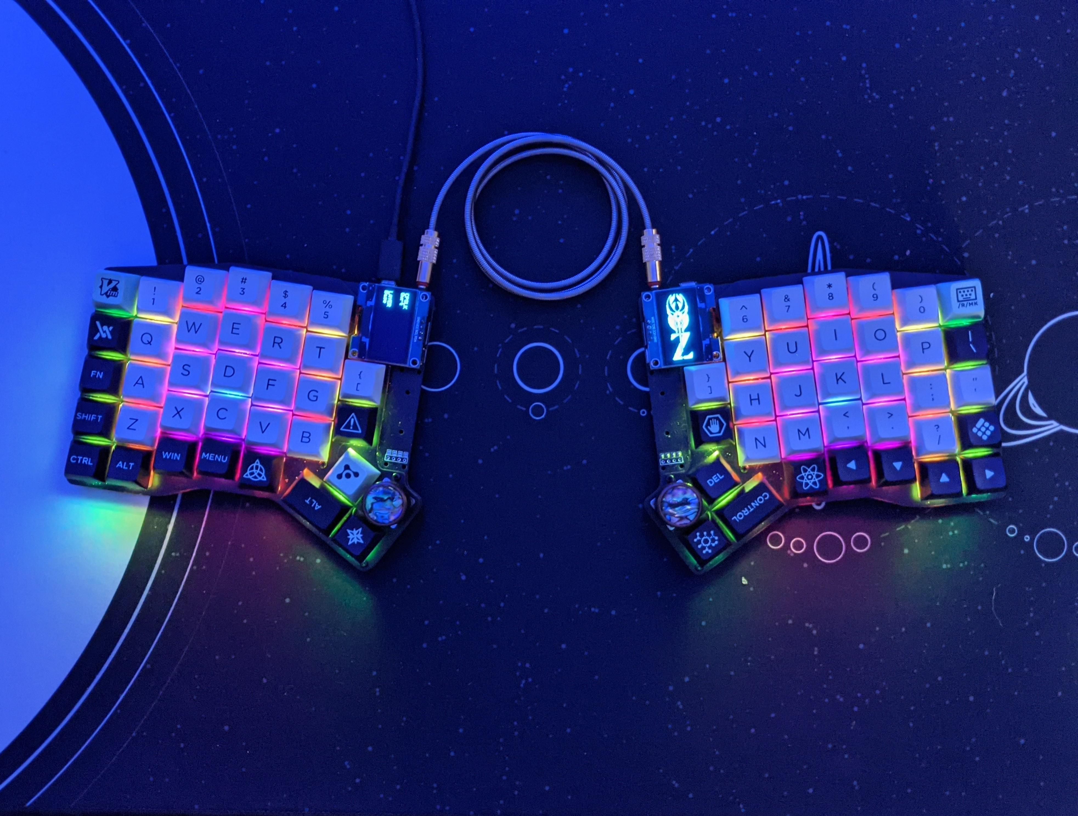
notes/attachments/Pasted image 20260426015004.png
